NorthernWidget/Project-Okapi/docs/figures/issue-51-J10_F.png

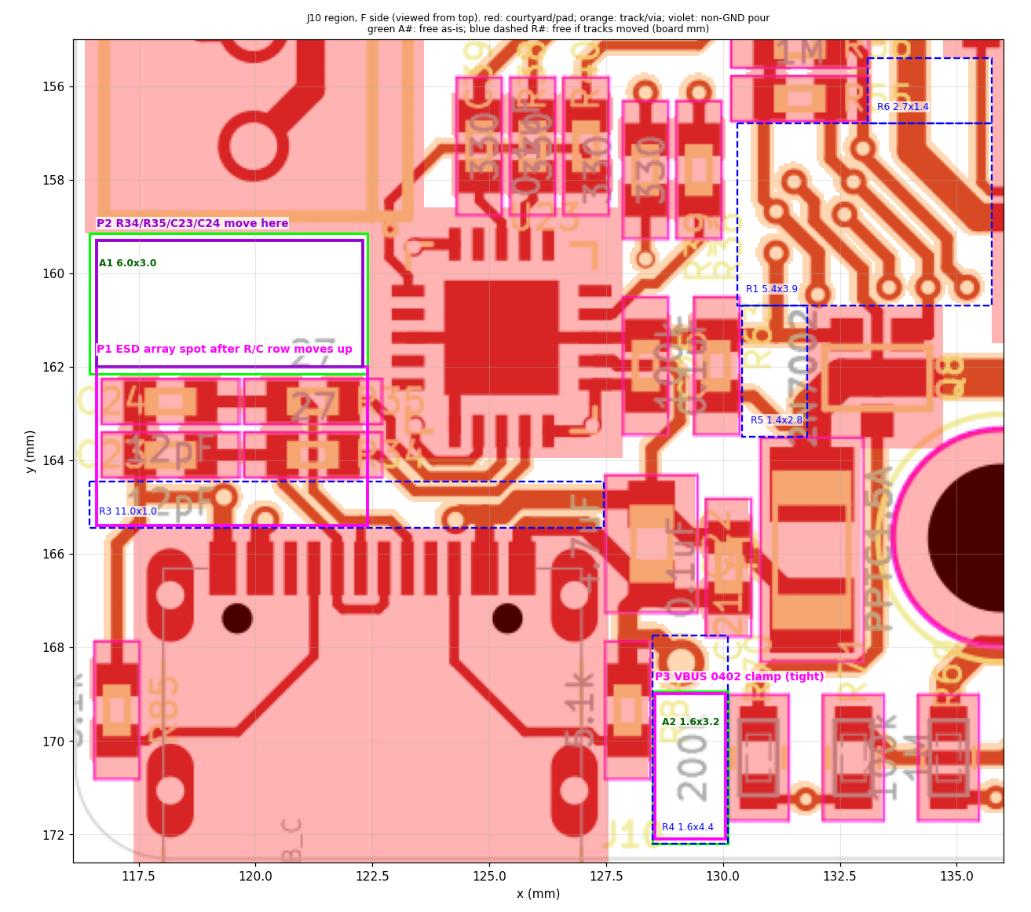
docs/figures/issue-51-J10_F.png
