NorthernWidget/Project-Okapi/docs/figures/issue-51-J5toJ8_F.png

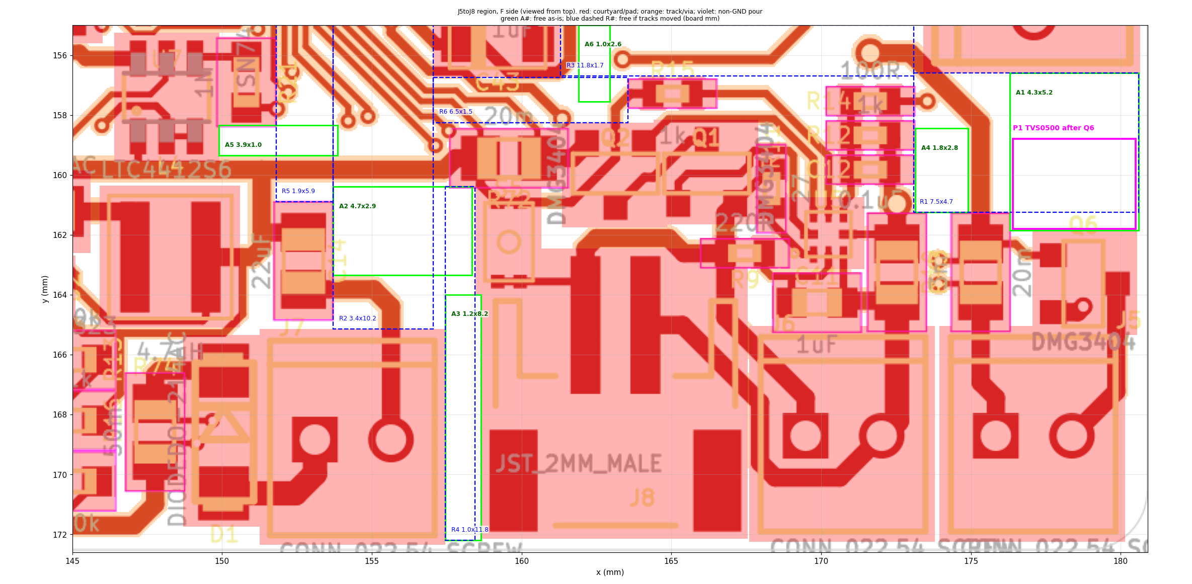
docs/figures/issue-51-J5toJ8_F.png
