NorthernWidget/Project-Okapi/Production/Okapi_BoM_0v7_2026-11-13.csv

Refs | Value | Footprint | Qty | MF | MPN | DIGIKEY | ALT_MF | ALT_MPN | ALT_DIGIKEY | DNP
BT1 | BATTERY_COIN12MM | nw-cold-silicon:LINX_BAT-HLD-012-SMT | 1 | MPD | BK-916-TR | BK-916-CT-ND
C1,C18,C22 | 4.7uF | nw-cold-silicon:C0603 | 3 | Murata | GRM188Z71C475KE21D | 490-GRM188Z71C475KE21DCT-ND
C2,C3,C4,C7,C8,C9,C10,C14,C19,C20,C30 | 22uF | nw-cold-silicon:C0805 | 11 | Murata | GRM219R61C226ME15L | 490-9952-1-ND
C5 | 220uF | nw-cold-silicon:C2917 | 1 | AVX | TPSY227K010R0100 | 478-5408-1-ND
C6,C33 | 68pF | nw-cold-silicon:C0402 | 2 | Wurth | 885012005060 | 732-7474-1-ND
C11,C13 | 1uF | nw-cold-silicon:C0603 | 2 | Taiyo Yuden | TMK107B7105KA-T | 587-2984-1-ND
C12,C17,C21,C25,C26,C27,C28,C29,C31,C32,C34,C35,C36,C37,C38,C39,C44,C45,C46,C47,C48,C50,C57 | 0.1uF | nw-cold-silicon:C0402 | 23 | Murata | GCM155R71C104KA55D | 490-4759-1-ND
C15,C16,C42 | 1uF | nw-cold-silicon:C0402 | 3 | Samsung | CL05A105KA5NQNC | 1276-1445-1-ND
C23,C24,C40,C41 | 12pF | nw-cold-silicon:C0402 | 4 | TDK | CGA2B2C0G1H120J050BA | 445-5585-1-ND
C43 | 100uF | nw-cold-silicon:C1206_TANT | 1 | Murata | GRM31CR61A107MEA8L | 490-GRM31CR61A107MEA8LCT-ND
D1,D3 | DIODEDO-214AC | nw-cold-silicon:DO214AC | 2 | Central Semiconductor | CMSH3-40MA TR13 | CMSH3-40MATR13CT-ND
D2 | DIODESOD-323 | nw-cold-silicon:SOD323-R | 1 | Central Semiconductor | CMDSH2-3 TR | CMDSH2-3CT-ND
D4,D5,D7 | CLVBA-FKA | nw-cold-silicon:CLVBA-FKA | 3 | Cree | CLVBA-FKA-CAEDH8BBB7A363 | CLVBA-FKA-CAEDH8BBB7A363CT-ND
D6 | LM4040 | nw-cold-silicon:SOT23-3 | 1 | Microchip | LM4040DYM3-2.5-TR | 576-1047-1-ND
D8 | BAT54C | nw-cold-silicon:SOT23-3 | 1 | ON Semiconductor | BAT54CLT1G | BAT54CLT1GOSCT-ND
D9 | DIODEDO-214AC | nw-cold-silicon:DO214AC | 1 | Diodes Incorporated | B340A-13-F | B340A-FDICT-ND
D10,D13,D16 | LEDGREEN0603 | nw-cold-silicon:LED_0603 | 3 | Wurth | 150060GS75000 | 732-4971-1-ND
D11,D14,D17 | LEDYELLOW0603 | nw-cold-silicon:LED_0603 | 3 | Wurth | 150060YS75000 | 732-4981-1-ND
D12,D18 | LEDRED0603 | nw-cold-silicon:LED_0603 | 2 | Wurth | 150060RS75000 | 732-4978-1-ND
F1,F2 | PPTC1.5A | nw-cold-silicon:1206 | 2 | Bourns | MF-NSMF150-2 | MF-NSMF150-2CT-ND
H1,H2,H3 | MOUNTING_HOLE4_NP | nw-cold-silicon:4_40 | 3 | N/A | DNP | DNP
IC1 | ATMEGA1284M | nw-cold-silicon:MLF44-TH | 1 | Atmel | ATMEGA1284P-MUR | ATMEGA1284P-MURCT-ND
ISP1 | AVRISP-6 | nw-cold-silicon:AVRISP | 1 | Amphenol | 67997-206HLF | 609-3234-ND
J1,J4 | CONN_82.54_SCREW | nw-cold-silicon:1X08_SCREW | 2 | On Shore | OSTVN08A150 | ED10566-ND
J2 | CONN_102.54_SCREW | nw-cold-silicon:1X10_SCREW | 1 | On Shore | OSTVN10A150 | ED10567-ND
J3 | CONN_42.54_SCREW | nw-cold-silicon:1X04_SCREW | 1 | On Shore | OSTVN04A150 | ED10563-ND
J5,J6,J7 | CONN_022.54_SCREW | nw-cold-silicon:1X02_2.54_SCREWTERM | 3 | OnShore | OSTVN02A150 | ED10561-ND
J8 | JST_2MM_MALE | nw-cold-silicon:JST-2-SMD | 1 | JST | S2B-PH-SM4-TB(LF)(SN) | 455-1749-1-ND
J9 | B_SERIES_M.2EKEY_NOPROG | nw-cold-silicon:PARTICLE_M.2EKEY_NOPROG | 1 | TE | 2199230-4 | A115904CT-ND
J10 | USB_C | nw-cold-silicon:USB_C_CUSB31-CFM2AX-01-X | 1 | GCT | USB4105-GF-A | 2073-USB4105-GF-ACT-ND
JP1,JP2,JP3,JP4,JP5,JP6,JP7 | JUMPER-SMT_2_NO_SILK | nw-cold-silicon:SMT-JUMPER_2_NO_SILK | 7
L1 | 6.8uH | nw-cold-silicon:1008 | 1 | Wurth | 74438323068 | 732-4849-1-ND
L2 | 10uH | nw-cold-silicon:WE-XHMI(6.65X6.45) | 1 | Wurth | 74439346100 | 732-10707-1-ND
L3 | 1uH | nw-cold-silicon:WE-LQS(3X3) | 1 | Wurth | 74404032010 | 732-5491-1-ND
L4 | 4.7uH | nw-cold-silicon:WE-MAIA(4.1X4.1) | 1 | Wurth | 78438356047 | 732-11316-1-ND
Q1,Q2,Q6 | DMG3404 | nw-cold-silicon:SOT23-3 | 3 | Diodes Incorporated | DMG3404L-7 | DMG3404L-7DICT-ND
Q3,Q5 | FDN360P | nw-cold-silicon:SOT23-3 | 2 | onsemi | FDN360P | FDN360PCT-ND
Q4,Q7,Q8 | 2N7002 | nw-cold-silicon:SOT323 | 3 | ON Semiconductor | 2N7002WT1G | 2N7002WT1GOSCT-ND
R1,R5,R7,R8,R65,R66 | 180k | nw-cold-silicon:R0402 | 6 | Yageo | RC0402FR-07180KL | 311-180KLRCT-ND | Panasonic | ERJ-2RKF1803X | P180KLCT-ND
R2,R4 | 1.62M | nw-cold-silicon:R0603 | 2 | Vishay | CRCW06031M62FKEA | 541-1.62MHCT-ND | Yageo | RC0603FR-071M62L | 13-RC0603FR-071M62LCT-ND
R3,R17 | 330k | nw-cold-silicon:R0603 | 2 | Panasonic | ERJ-3EKF3303V | P330KHCT-ND | Stackpole | RMCF0603FT330K | RMCF0603FT330KCT-ND
R6 | 820k | nw-cold-silicon:R0603 | 1 | Yageo | RC0603FR-07820KL | 311-820KHRCT-ND | Panasonic | ERJ-3EKF8203V | P820KHCT-ND
R9,R53,R60,R64,R76,R77,R78,R79,R80 | 220R | nw-cold-silicon:R0402 | 9 | TE | CRGCQ0402F220R | A129619CT-ND | Yageo | RC0402FR-07220RL | 311-220LRCT-ND
R10 | 3m | nw-cold-silicon:R0805 | 1 | Rohm | PMR10EZPFV3L00 | RHM.003AJCT-ND | Vishay | WFC08053L000FE66 | 541-WFC08053L000FE66CT-ND
R11,R34,R35 | 27 | nw-cold-silicon:R0402 | 3 | Yageo | RC0402FR-0727RL | YAG3086CT-ND | Panasonic | ERJ-2RKF27R0X | P27.0LCT-ND
R12,R15 | 1k | nw-cold-silicon:R0402 | 2 | Yageo | RC0402FR-071KL | 311-1.00KLRCT-ND | Panasonic | ERJ-2RKF1001X | P1.00KLCT-ND
R13 | 180k | nw-cold-silicon:R0603 | 1 | Panasonic | ERJ-3EKF1803V | P180KHCT-ND | Stackpole | RMCF0603FT180K | RMCF0603FT180KCT-ND
R14 | 100R | nw-cold-silicon:R0402 | 1 | Yageo | RC0402FR-07100RL | 311-100LRCT-ND | Stackpole | RMCF0402FT100R | RMCF0402FT100RCT-ND
R16 | 91k | nw-cold-silicon:R0603 | 1 | Panasonic | ERJ-3EKF9102V | P91.0KHCT-ND | Yageo | RC0603FR-0791KL | 311-91.0KHRCT-ND
R18,R19,R23,R57,R58,R61,R63 | 100k | nw-cold-silicon:R0402 | 7 | Yageo | RC0402FR-07100KL | 311-100KLRCT-ND | Panasonic | ERJ-2RKF1003X | P100KLCT-ND
R20 | 130k | nw-cold-silicon:R0603 | 1 | Panasonic | ERJ-3EKF1303V | P130KHCT-ND | Stackpole | RMCF0603FT130K | RMCF0603FT130KCT-ND
R21 | 1M | nw-cold-silicon:R0603 | 1 | Panasonic | ERJ-3EKF1004V | P1.00MHCT-ND | Yageo | RC0603FR-071ML | 311-1.00MHRCT-ND
R22 | 143k | nw-cold-silicon:R0402_0603 | 1 | Yageo | RC0603FR-07143KL | 311-143KHRCT-ND
R24,R25,R41,R45,R46,R47,R52,R54,R67,R86,R87 | 10k | nw-cold-silicon:R0402 | 11 | Yageo | RC0402FR-0710KL | 311-10.0KLRCT-ND | Panasonic | ERJ-2RKF1002X | P10.0KLCT-ND
R26,R27,R28,R29 | 232 | nw-cold-silicon:R0402 | 4 | Yageo | RC0402FR-07232RL | YAG3063CT-ND | Stackpole | RMCF0402FT232R | RMCF0402FT232RCT-ND
R30,R31,R32,R33 | 464 | nw-cold-silicon:R0402 | 4 | Yageo | RC0402FR-07464RL | 311-464LRCT-ND | Panasonic | ERJ-2RKF4640X | P464LCT-ND
R36,R37,R38,R39,R40,R42,R43,R44 | 330 | nw-cold-silicon:R0402 | 8 | Yageo | RC0402FR-07330RL | 311-330LRCT-ND | Panasonic | ERJ-2RKF3300X | P330LCT-ND
R48 | 1k | nw-cold-silicon:R0402_0603 | 1 | Yageo | RC0402FR-071KL | 311-1.00KLRCT-ND | Panasonic | ERJ-2RKF1001X | P1.00KLCT-ND
R49,R50 | 10k | nw-cold-silicon:R0603 | 2 | Bourns | CRT0603-BY-1002ELF | CRT0603-BY-1002ELFCT-ND | Susumu | RG1608P-103-B-T5 | RG16P10.0KBCT-ND
R51 | 0 | nw-cold-silicon:R0402 | 1 | Panasonic | ERJ-2GE0R00X | P0.0JCT-ND | Yageo | RC0402JR-070RP | YAG1279CT-ND
R55,R56,R59,R68 | 1M | nw-cold-silicon:R0402 | 4 | Yageo | RC0402FR-071ML | 311-1.00MLRCT-ND | Panasonic | ERJ-2RKF1004X | P1.00MLCT-ND
R69 | 100k | nw-cold-silicon:R0402_0603 | 1 | Yageo | RC0402FR-07100KL | 311-100KLRCT-ND | Panasonic | ERJ-2RKF1003X | P100KLCT-ND
R70 | 200k | nw-cold-silicon:R0402_0603 | 1 | Panasonic | ERJ-2RKF2003X | P200KLCT-ND | Yageo | RC0402FR-07200KL | 311-200KLRCT-ND
R71 | 1M | nw-cold-silicon:R0402_0603 | 1 | Yageo | RC0402FR-071ML | 311-1.00MLRCT-ND | Panasonic | ERJ-2RKF1004X | P1.00MLCT-ND
R72,R73,R75 | 20m | nw-cold-silicon:R0805 | 3 | Panasonic | ERJ-6BWFR020V | P.02AQCT-ND | KOA | UR73VD2ATTD20L0F | 2019-UR73VD2ATTD20L0FCT-ND
R74 | 50m | nw-cold-silicon:R0805 | 1 | Panasonic | ERJ-6BWFR050V | P17581CT-ND | KOA | UR73V2ATTD50L0F | 2019-UR73V2ATTD50L0FCT-ND
R81,R82,R83,R84,R85 | 5.1k | nw-cold-silicon:R0402 | 5 | Yageo | RC0402FR-075K1L | 311-5.10KLRCT-ND | Panasonic | ERJ-2RKF5101X | P5.10KLCT-ND
RTC1 | DS3231M | nw-cold-silicon:SO08 | 1 | Maxim | DS3231MZ+ | DS3231MZ+-ND
S1,S2 | SPDTPCM12 | nw-cold-silicon:PCM12 | 2 | C&K | PCM12SMTR | 401-2016-1-ND
S3,S4,S6,S7 | BUTTON4.2X3.2 | nw-cold-silicon:SWITCH_4.2X3.2 | 4 | C&K | PTS810 SJG 250 SMTR LFS | CKN10504CT-ND
S5 | BUTTON2.6X1.6 | nw-cold-silicon:SWITCH_2.6X1.6 | 1 | Panasonic | EVP-BB2A9B000 | P19888CT-ND
SD1 | MICROSDCD | nw-cold-silicon:MICROSD_CD | 1 | Molex | 5025700893 | WM19093CT-ND
U$1,U$2 | VDIV-JP | nw-cold-silicon:VDIV_GENERIC | 2
U1 | TLV61220DBV | nw-cold-silicon:DBV_R-PDSO-G6 | 1 | TI | TLV61220DBVR | 296-30547-1-ND
U2 | TPS6282DLC | nw-cold-silicon:DLC_8 | 1 | TI | TPS62822DLCT | 296-49512-1-ND
U3 | TPS61032RSA | nw-cold-silicon:RSA_S-PVQFN-N16 | 1 | TI | TPS61032RSAR | 296-16662-1-ND
U4 | LT3652DD | nw-cold-silicon:DFN_12_3X3 | 1 | LT | LT3652EDD#PBF | LT3652EDD#PBF-ND
U5 | BQ2980RUG | nw-cold-silicon:RUG_S-PQFP-N8 | 1 | TI | BQ298000RUGT | 296-47578-1-ND
U6 | TPS2105 | nw-cold-silicon:SOT23-5 | 1 | TI | TPS2105DBVR | 296-10883-1-ND
U7 | LTC4412S6 | nw-cold-silicon:SOT23-6L | 1 | LT | LTC4412ES6#TRPBF | LTC4412ES6#TRPBFCT-ND
U8 | TPL5111DDC | nw-cold-silicon:DDC_R-PDSO-G6 | 1 | TI | TPL5111DDCR | 296-46226-1-ND
U9 | TPS797 | nw-cold-silicon:DCK_R-PDSO-G5 | 1 | TI | TPS79733DCKR | 296-11990-1-ND
U10,U21,U22 | TPS22917DBV | nw-cold-silicon:DBV_R-PDSO-G6 | 3 | TI | TPS22917DBVT | 296-48370-1-ND
U11,U12,U13 | SN74AUP1G04YFP | nw-cold-silicon:DSBGD_4 | 3 | TI | SN74AUP1G04YFPR | 296-25196-1-ND
U14,U15,U16 | SN74AUP2G08DQE | nw-cold-silicon:DQE_R-PX2SON-N8 | 3 | TI | SN74AUP2G08DQER | 296-25638-1-ND
U17,U18,U19,U20 | MIC2544MSOP | nw-cold-silicon:MSOP_8 | 4 | Microchip | MIC2544-1YMM | 576-1738-5-ND
U23 | FT231X-Q | nw-cold-silicon:QFN20 | 1 | FTDI | FT231XQ-R | 768-1128-1-ND
U24 | SN74LVC1G3157DRL | nw-cold-silicon:DRL_R-PDSO-N6 | 1 | TI | SN74LVC1G3157DRLR | 296-18015-1-ND
U25 | SN74AUP3G34DCU | nw-cold-silicon:DCU_(R-PDSO-G8) | 1 | TI | SN74AUP3G34DCUR | 296-25595-1-ND
U26,U34 | TXS0102DQM | nw-cold-silicon:DQM_R-PX2SON-N8 | 2 | TI | TXS0102DQMR | 296-28435-1-ND
U27,U29,U42 | TXS0104RGY | nw-cold-silicon:RGY_S-PVQFN-N14 | 3 | TI | TXS0104ERGYR | 296-20698-1-ND
U28,U36 | TCA9406DCU | nw-cold-silicon:DCU_(R-PDSO-G8) | 2 | TI | TCA9406DCUR | 296-28109-1-ND
U30 | MCP4726SOT-23 | nw-cold-silicon:SOT23-6L | 1 | Microchip | MCP4726A2T-E/CH | MCP4726A2T-E/CHCT-ND
U31 | BME280 | nw-cold-silicon:BME280 | 1 | Bosch | BME280 | 828-1063-1-ND
U32 | PAC1934QFN | nw-cold-silicon:QFN16 | 1 | Microchip | PAC1934T-I/JQ | PAC1934T-I/JQCT-ND
U33 | ADS111 | nw-cold-silicon:VSSOP_10 | 1 | TI | ADS1115IDGSR | 296-38849-1-ND
U35 | MB85RC | nw-cold-silicon:SO08 | 1 | Fujitsu | MB85RC512TPNF-G-JNERE1 | 865-1269-1-ND
U37 | TLV3691DCK | nw-cold-silicon:DCK_R-PDSO-G5 | 1 | TI | TLV3691IDCKR | 296-37910-1-ND
U38 | MLX90393 | nw-cold-silicon:QFN16_3X3 | 1 | Melexis | MLX90393SLW-ABA-011-RE | MLX90393SLW-ABA-011-RECT-ND
U39 | MIC94094C6 | nw-cold-silicon:SC-70_6 | 1 | Microchip | MIC94094YC6-TR | 576-3492-1-ND
U40 | SN74AHC1G86DCK | nw-cold-silicon:DCK_R-PDSO-G5 | 1 | TI | SN74AHC1G86DCKR | 296-8750-1-ND
U41 | MCP23018QFN | nw-cold-silicon:QFN24 | 1 | Microchip | MCP23018T-E/MJ | MCP23018T-E/MJCT-ND
U43 | BMA456 | nw-cold-silicon:LGA-12_2X2 | 1 | Bosch | BMA456 | 828-1075-1-ND
U44 | VEML6030 | nw-cold-silicon:VEML6030 | 1 | Vishay | VEML6030-GS15 | VEML6030-GS15CT-ND
U45 | PCA9634QFN | nw-cold-silicon:QFN20_5X5 | 1 | NXP | PCA9634BS,118 | 568-8717-1-ND
USB2 | USB_MICROVERT | nw-cold-silicon:USB_MICRO_VERT_MOLEX | 1 | Molex | 1051330001 | WM9734CT-ND
XTAL1 | 8 MHz | nw-cold-silicon:CRYSTAL_5X3.2_2-SMD | 1 | ECS | ECS-80-12-30-JGN-TR | 50-ECS-80-12-30-JGN-CT-ND
