NorthernWidget/Project-Okapi/docs/v0.7-pre-build-checks.md

# v0.7 pre-build checks

No board has been built from the 2024 design or from its KiCad port. v0.7.0 is not to be built either: like the 2024 design, it has no charger sense resistor between the LT3652's SENSE and BAT pins ([#32](https://github.com/NorthernWidget/Project-Okapi/issues/32)), which v0.8.0 adds as R88. These checks carry forward to the first v0.8.0 boards. The only Okapi boards that exist are the 25 from 2020 (v0.4), and their schematic is a different one. So nothing below has an as-built value yet: this is what to confirm on the first v0.8.0 boards, with the value the design expects beside each.

In several places the 2024 files disagreed with what the design meant, and the v0.7.0 parts list corrects them (`NW-Status/studies/okapi-hardware-audit/DECISIONS.md` has the reasoning for each):

| Ref | Design for v0.7.0 | 2024 files | Net |
|-----|---|---|-----|
| R26–R29 | 232 Ω, 0402 | value field 287R; the part number was 232 Ω | ILIM of the port switches U17–U20, to ground |
| R30–R33 | 464 Ω, 0402 | value field 287R; the part number was 453 Ω | second ILIM resistor of each switch, in parallel through JP1–JP4 |
| R36–R40, R42–R44 | 330 Ω, 0402 | 330 Ω with an 0603 part number | LED series (D4, D5), the FT231X UART series (R38, R40) |
| R19 | 100 kΩ, 0402 | 120 kΩ | PARTICLE_EN pull-up to 3V3_CORE (Q3's gate) |
| C40, C41 | 12 pF, 0402 (TDK C0G) | a Samsung 0603 part number on 0402 pads | crystal load |
| C42 | 1 µF, 0402 | an 0603 part number on an 0402 pad | AVCC and AREF decoupling |
| R48 | 1 kΩ, 0402 on a dual 0402/0603 land | 330 Ω, 0603 | bias for the 2.5 V reference (D6) |
| R51 | 0 Ω, 0402 | no value | PAC1934 ADDRSEL to ground (address 0x10) |
| R72, R73, R75 | 20 mΩ, 0805, 0.5 W (ERJ-6BWFR020V) | no value | PAC1934 shunts: V_LI, V_PRIME, V_BETA |
| R74 | 50 mΩ, 0805, 0.5 W (ERJ-6BWFR050V) | no value | PAC1934 shunt: V_SOLAR_IN |
| R22, R69 | 143 kΩ 0603, 100 kΩ 0402, both on dual 0402/0603 lands | 0603 lands | MPPT pair on the LT3652's VIN_REG |
| Q7 | 2N7002WT1G | 2N7002W-7-F (#7) | switches 5V_AUX |

The resistor and capacitor consolidation (2026-11-06 to 2026-11-09, `NW-Status/studies/okapi-hardware-audit/resistor-minimum-set.md` and `capacitors.md`) changed these from the 2024 files as well:

| Ref | Design for v0.7.0 | 2024 files | Net |
|-----|---|---|-----|
| R3 | 330 kΩ, 0603 | 360 kΩ | TPS61032 low-battery divider |
| R5, R7 | 180 kΩ, 0402 | 0603 | feedback dividers of U1 and U2 |
| R6 | 820 kΩ 1 %, 0603 | 5 % | 3V3_AUX feedback divider |
| R9 | 220 Ω, 0402 | 330 Ω | U5's VDD filter (300 Ω maximum) |
| R11 | 27 Ω, 0402 | 20 Ω | U5's BAT resistor |
| R13 | 180 kΩ, 0603 | 182 kΩ | LT3652 VFB bias |
| R15 | 1 kΩ, 0402 | 2 kΩ | U5's PACK resistor |
| R21 | 1 MΩ, 0603 | 470 kΩ | LTC4412 STAT pull-up |
| R70, R71 | 200 kΩ, 1 MΩ, 0402 on dual 0402/0603 lands | 0603 | LT3652 SHDN divider (charger start voltage) |
| R81–R83 | 5.1 kΩ, 0402 | 5.6 kΩ | B-SoM RGB LED |
| C1 | 4.7 µF, 0603 | 0805 | – |
| C3, C4, C14 | 22 µF, 0805 | 10 µF | bulk, for effective capacitance at 4.2–5 V |
| C30 | 22 µF, 0805 | 10 µF | the MCP4726's VDD bulk |
| C15, C16 | 1 µF, 0402 | 0.22 µF | – |
| C22 | 4.7 µF X7R, 0603 | 10 µF, 0805 | USB VBUS (FTDI's value) |
| C33 | 68 pF, 0402 | 0.1 µF | DAC output |
| C43 | 100 µF ceramic, 1206 (GRM31CR61A107MEA8L) | tantalum | the tantalum land stays until #43 |
| XTAL1 | ECS-80-12-30-JGN-TR | TXC 7A-8.000MAAE-T (obsolete) | 8 MHz crystal |

Measure two or three boards from the run, so that one odd board does not stand for all of them.

## 1. Look (unpowered)

1. R9, R36–R40, R42–R44: 0402 (1.0 × 0.5 mm), not 0603 (1.6 × 0.8 mm). An 0603 on these pads overhangs them.
2. C40, C41, C42: 0402. Record the markings on the reels, since a ceramic capacitor carries none.
3. R48: record the size. It is 0402 as built, and 0603 only if someone has swapped it for more reference current (a 330 Ω 0603, `RC0603FR-07330RL`, fits the same pads).
4. R22 (0603) and R69 (0402), marked on the silk as the MPPT pair; R70 and R71 0402. All four sit on dual lands that take either size.
5. Q7, Q4, Q8: record the top marking. The BoM change is for Q7; Q4 and Q8 carried the same part number.
6. R72–R75, and on v0.8.0 the charger sense resistor R88: 0805. Record any marking.
7. R5, R7, R9, R11, R15, R81–R83: 0402. C1, C22: 0603. C15, C16: 0402. C3, C4, C14, C30: 0805 22 µF (record the reel). C43: a ceramic 1206 on the tantalum land, centered.

## 2. Resistance (unpowered, batteries, USB and solar input out)

Many of these sit between unpowered ICs, whose protection diodes can conduct at an ohmmeter's test voltage. Take each reading in both probe polarities and record the higher one. Measure the four shunts with a four-wire (Kelvin) milliohm meter on the pads; a two-wire meter cannot read 20 mΩ.

| Ref | Probe across | Expect |
|-----|---|---|
| R26–R29 | its two pads, JP1–JP4 open | 232 Ω |
| R30–R33 | its two pads, JP open | 464 Ω |
| R26–R29 | its two pads, the matching JP closed | 154.7 Ω (232 Ω ∥ 464 Ω) |
| R36–R40, R42–R44 | its two pads | 330 Ω |
| R9 | its two pads | 220 Ω |
| R11 | its two pads | 27 Ω |
| R15 | its two pads | 1 kΩ |
| R3 | its two pads | 330 kΩ |
| R13 | its two pads | 180 kΩ |
| R21 | its two pads | 1 MΩ |
| R70 | its two pads | 200 kΩ |
| R71 | its two pads | 1 MΩ |
| R81–R83 | its two pads | 5.1 kΩ |
| R19 | its two pads | 100 kΩ |
| R48 | its two pads | 1 kΩ |
| R51 | its two pads | under 1 Ω |
| R72, R73, R75 | pads, four-wire | 20 mΩ |
| R74, and R88 on v0.8.0 | pads, four-wire | 50 mΩ |
| R22 | its two pads | 143 kΩ |
| R69 | its two pads | 100 kΩ |

Close each of JP1–JP4 in turn with a solder bridge, read it, and wick it open again.

## 3. Powered

1. **Port current limits (optional, with a current-limited load).** Enable one port switch and load its output with an electronic load in constant-current mode. Raise the current until the output collapses and record that trip current. The datasheet gives 0.79–1.19 A with the jumper open and 1.04–1.93 A with it closed (R_SET = 230 V / I, with the current-limit factor spread 184–276 V up to 1 A and 161–299 V above it). If the upstream rail sags first, record where.
2. **R19.** With PARTICLE_EN not driven, measure the voltage across R19. The current is that voltage divided by the reading from step 2. When firmware drives PARTICLE_EN low, the pull-up carries about 33 µA at 3.3 V.
3. **R48 and the reference.** With 5V_AUX on, measure VREF (J2 pin 2) and the voltage across R48. Expect 2.5 V on VREF and about 2.5 mA through R48 (the LM4040 holds 2.5 V from 60 µA to 15 mA). Then load VREF with 1.25 kΩ (about 2 mA) and record VREF again.
4. **R51 and the PAC1934.** Scan the I2C bus on the segment the PAC1934 sits on. Expect an answer at 0x10 and the product ID 0x5B from `pacFind()`; the other chips are at 0x48, 0x52, 0x20, 0x50, 0x77, 0x0C, 0x68 and 0x18 (the BMA456's other strap would put it at 0x19).
5. **Shunts and zero offset.** With the load off, read each channel's current. The PAC1934's offset is ±0.02 mV at 25 °C, which is ±1 mA on 20 mΩ and ±0.4 mA on 50 mΩ. Then pass a known current through each channel (about 1 A, from a bench supply read on a second meter) and compare: expect 20 mV across a 20 mΩ shunt and 50 mV across a 50 mΩ one. On V_LI the current is bipolar: charging reads positive.
6. **MPPT pair.** Feed the solar input from a current-limited bench supply and lower its voltage below the point the supply can sustain. The charger holds the input at VIN_REG, 2.7 V × (1 + 143 kΩ / 100 kΩ) = 6.56 V by the design. Record where it settles.
7. **Q7.** Command 5V_AUX off and measure the current from the backup battery. A latched Q7 draws about 100 mA; expect the sleep current instead.

The PAC1934 path in the firmware (`Okapi.cpp`) has not run on hardware.

## Results

| Board (serial) | R26/R30 open (Ω) | R26 closed (Ω) | R19 (Ω) | R48 (Ω) | VREF (V) | PAC1934 address | R72 (mΩ) | R73 (mΩ) | R74 (mΩ) | R75 (mΩ) | Notes |
|---|---|---|---|---|---|---|---|---|---|---|---|
| | | | | | | | | | | | |
| | | | | | | | | | | | |
