NorthernWidget/Project-Okapi/docs/figures/issue-36-r48-move.png

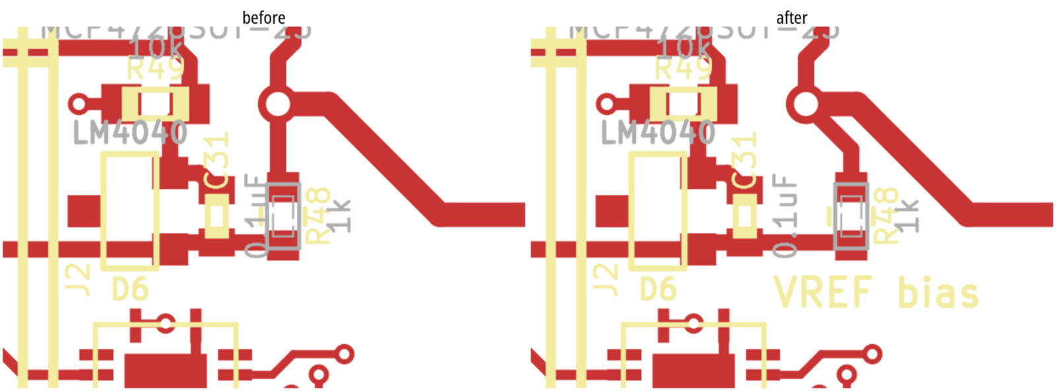
docs/figures/issue-36-r48-move.png
