NorthernWidget/Project-Okapi/docs/figures/issue-37-slow-routing.png

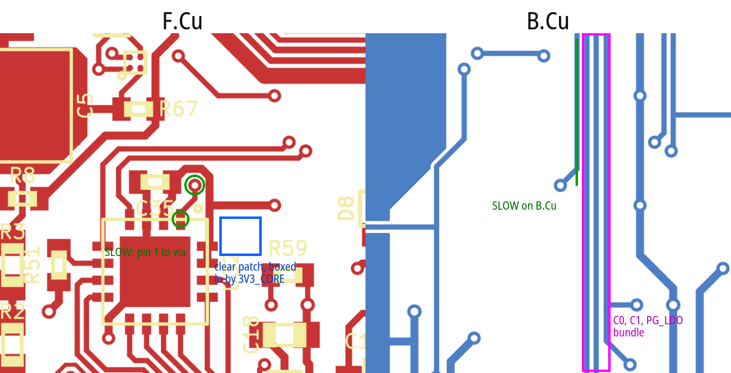
docs/figures/issue-37-slow-routing.png
