NorthernWidget/Project-Okapi/docs/figures/issue-51-J1J2_F.png

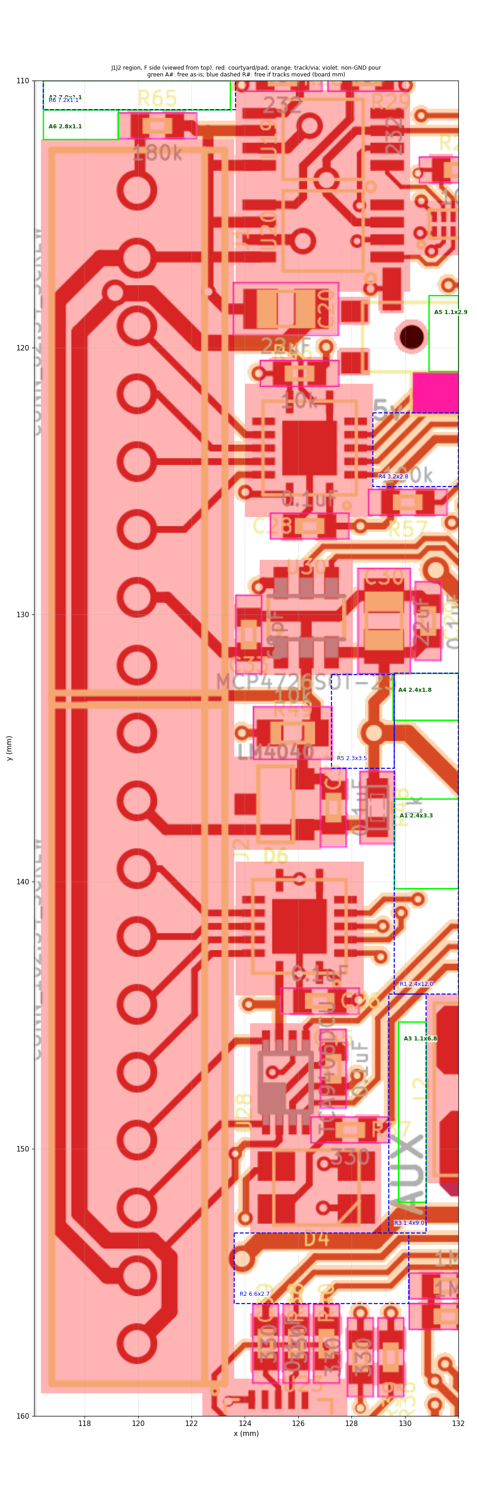
docs/figures/issue-51-J1J2_F.png
