NorthernWidget/Project-Okapi/docs/figures/issue-51-J3J4_F.png

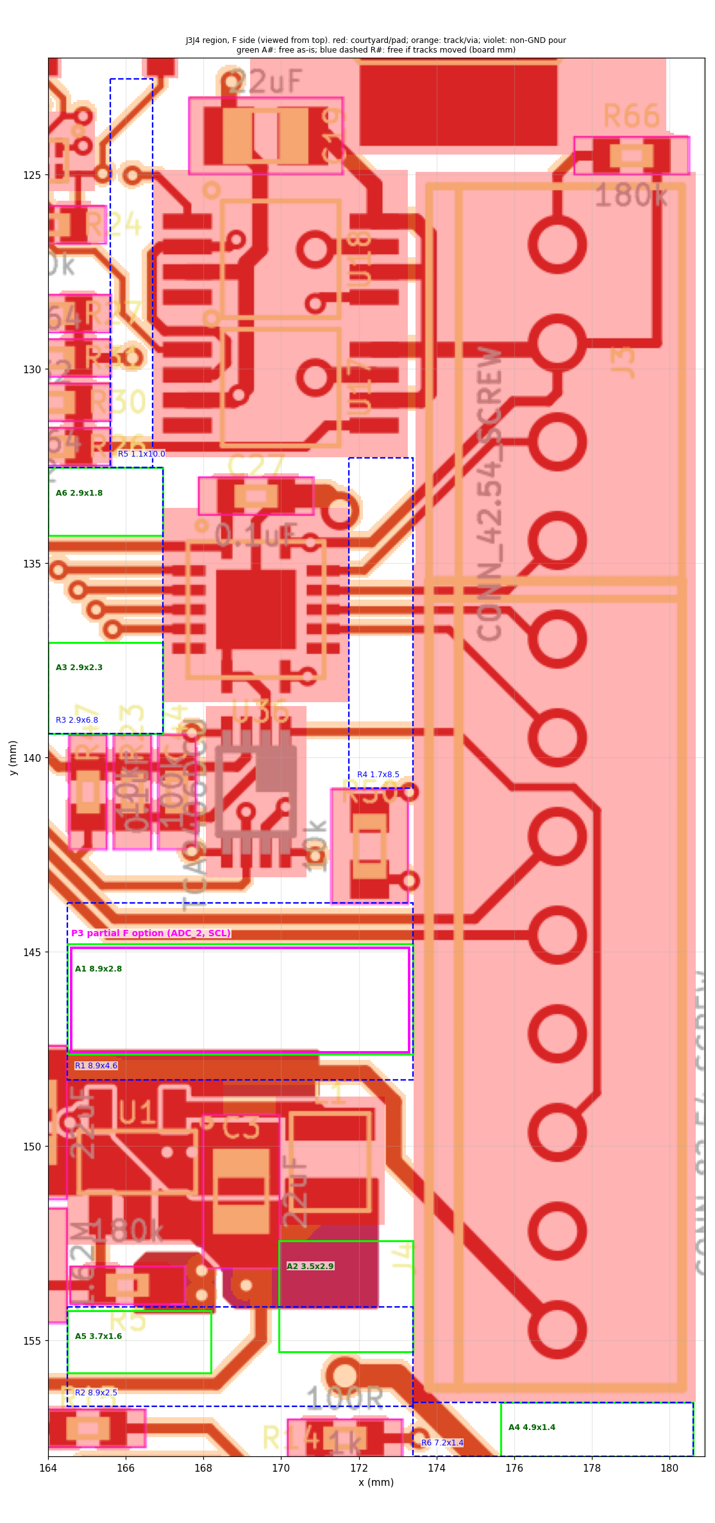
docs/figures/issue-51-J3J4_F.png
