NorthernWidget/Project-Okapi/docs/figures/issue-51-USB2_F.png

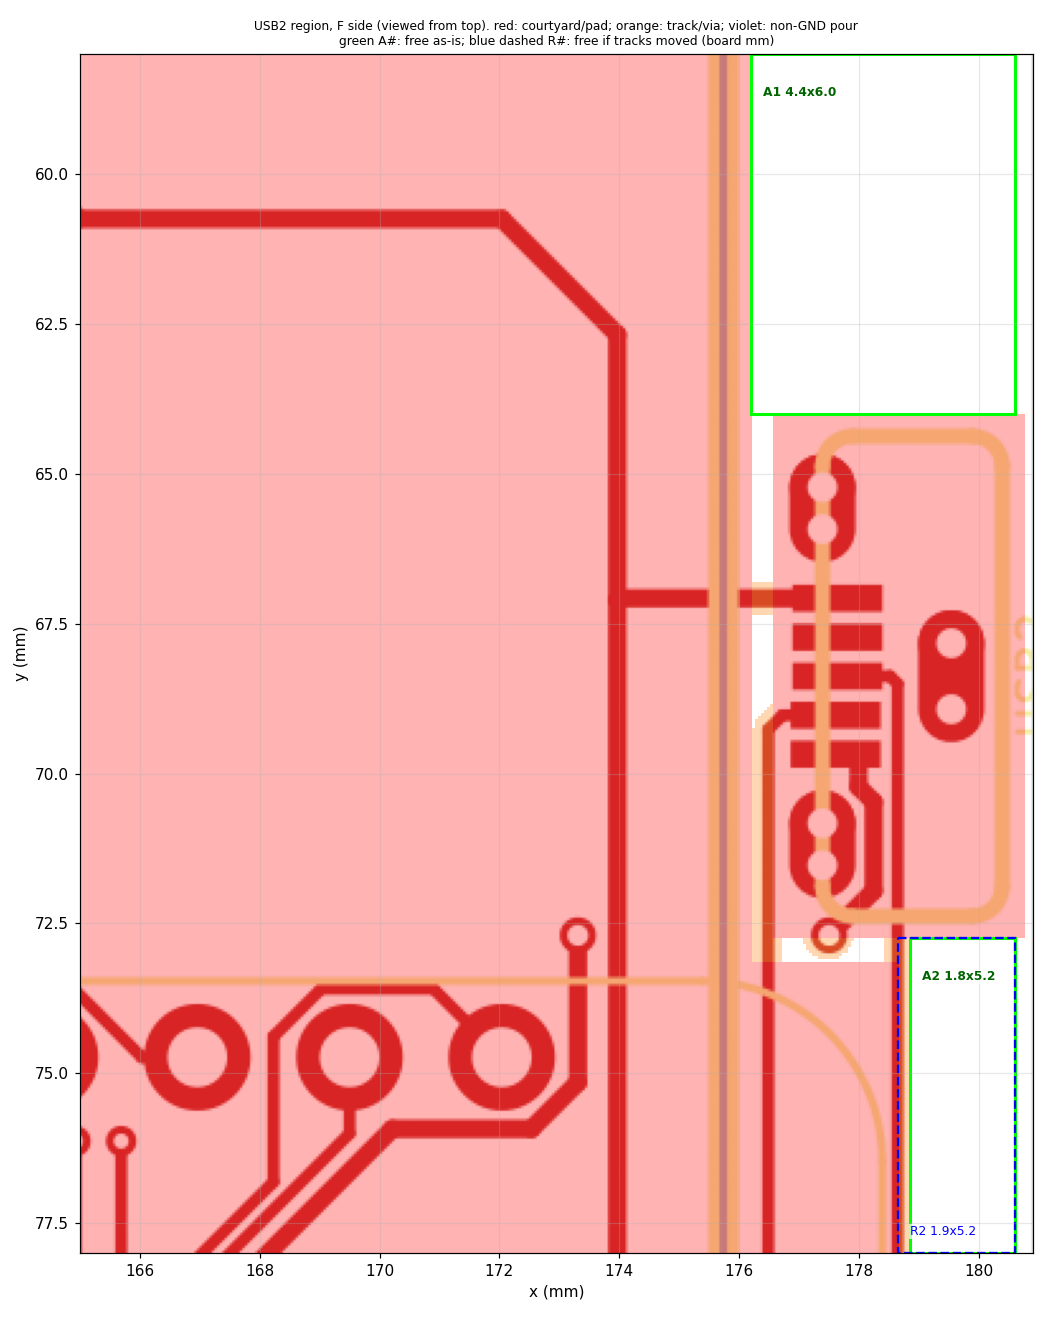
docs/figures/issue-51-USB2_F.png
