NorthernWidget/Project-Okapi/Hardware/KiCAD-10import/Okapi.kicad_pcb

## KiCad design Hardware/KiCAD-10import/Okapi.kicad_pcb (2026-11-13)

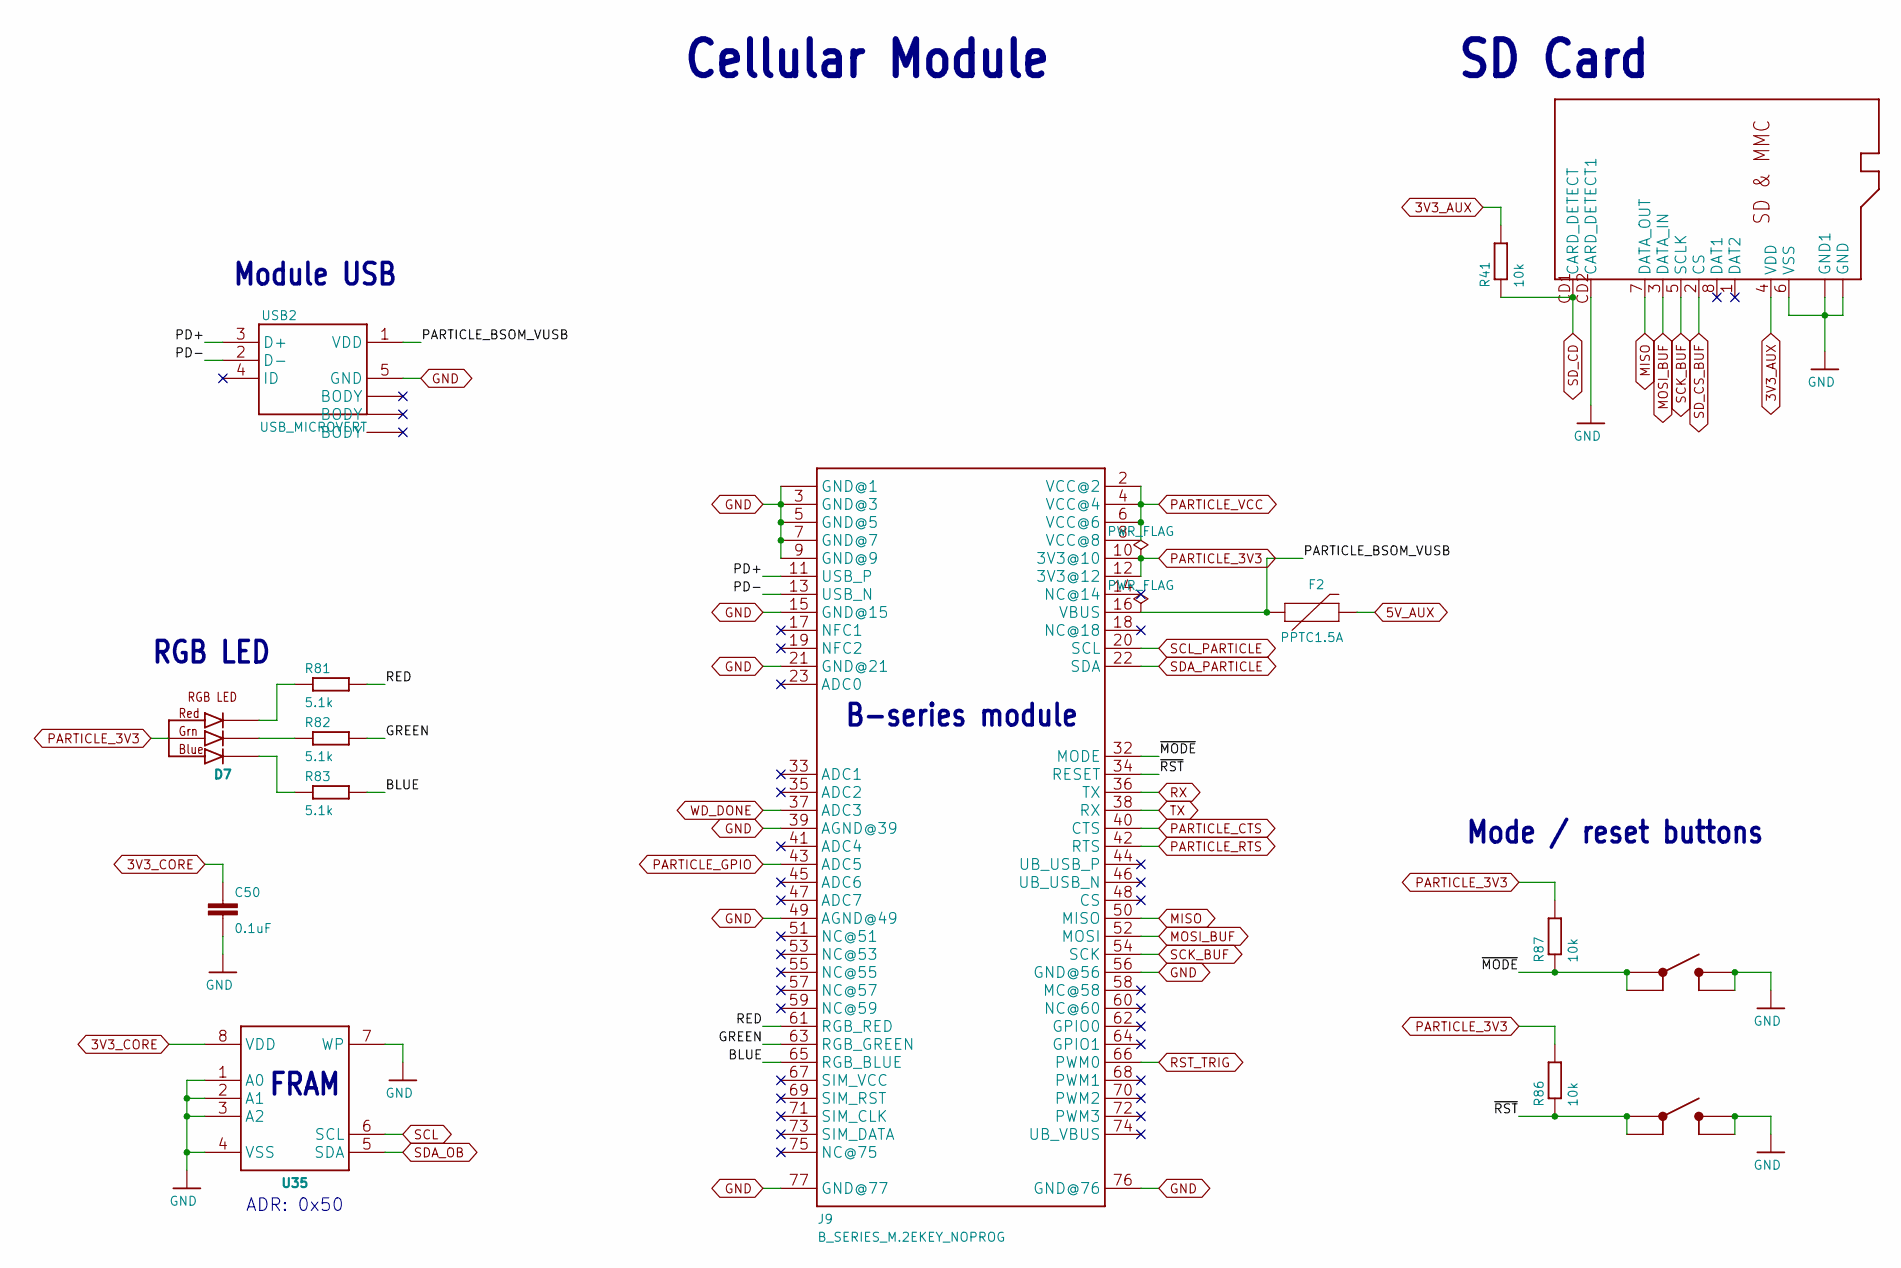
[picture p8: schematic Cell_Module.kicad_sch]

Parts:
C50: 0.1uF; C0402; MPN GCM155R71C104KA55D; DIGIKEY 490-4759-1-ND
D7: CLVBA-FKA; MPN CLVBA-FKA-CAEDH8BBB7A363; DIGIKEY CLVBA-FKA-CAEDH8BBB7A363CT-ND
F2: PPTC1.5A; 1206; MPN MF-NSMF150-2; DIGIKEY MF-NSMF150-2CT-ND
J9: B_SERIES_M.2EKEY_NOPROG; PARTICLE_M.2EKEY_NOPROG; MPN 2199230-4; DIGIKEY A115904CT-ND
R41, R86, R87: 10k; R0402; MPN RC0402FR-0710KL; DIGIKEY 311-10.0KLRCT-ND
R81, R82, R83: 5.1k; R0402; MPN RC0402FR-075K1L; DIGIKEY 311-5.10KLRCT-ND
S6, S7: BUTTON4.2X3.2; SWITCH_4.2X3.2; MPN PTS810 SJG 250 SMTR LFS; DIGIKEY CKN10504CT-ND
SD1: MICROSDCD; MICROSD_CD; MPN 5025700893; DIGIKEY WM19093CT-ND
U35: MB85RC; SO08; MPN MB85RC512TPNF-G-JNERE1; DIGIKEY 865-1269-1-ND
USB2: USB_MICROVERT; USB_MICRO_VERT_MOLEX; MPN 1051330001; DIGIKEY WM9734CT-ND

Connections:
3V3_AUX: R41.2, SD1.4 (VDD); also elsewhere on the board
3V3_CORE: C50.1, U35.8 (VDD); also elsewhere on the board
5V_AUX: F2.2; also elsewhere on the board
/Cell_Module/BLUE: J9.65 (RGB_BLUE), R83.2
/Cell_Module/GREEN: J9.63 (RGB_GREEN), R82.2
/Cell_Module/PARTICLE_BSOM_VUSB: F2.1, J9.16 (VBUS), USB2.1 (VDD)
/Cell_Module/PD+: J9.11 (USB_P), USB2.3 (D+)
/Cell_Module/PD-: J9.13 (USB_N), USB2.2 (D-)
/Cell_Module/RED: J9.61 (RGB_RED), R81.2
/Cell_Module/~MODE: J9.32 (MODE), R87.1, S6.1, S6.2
/Cell_Module/~RST: J9.34 (RESET), R86.1, S7.1, S7.2
GND: C50.2, J9.1 (GND@1), J9.3 (GND@3), J9.5 (GND@5), J9.7 (GND@7), J9.9 (GND@9), J9.15 (GND@15), J9.21 (GND@21), J9.39 (AGND@39), J9.49 (AGND@49), J9.56 (GND@56), J9.76 (GND@76), J9.77 (GND@77), J9.GND (GND@1), S6.3 (4), S6.4 (3), S7.3 (4), S7.4 (3), SD1.6 (VSS), SD1.CD2 (CARD_DETECT1), SD1.MT1 (GND), SD1.MT2 (GND1), SD1.MT3 (GND1), SD1.MT4 (GND1), U35.1 (A0), U35.2 (A1), U35.3 (A2), U35.4 (VSS), U35.7 (WP), USB2.5 (GND); also elsewhere on the board
MISO: J9.50 (MISO), SD1.7 (DATA_OUT); also elsewhere on the board
MOSI_BUF: J9.52 (MOSI), SD1.3 (DATA_IN); also elsewhere on the board
unnamed: D7.3 (BLUE_CATH), R83.1
unnamed: D7.4 (GREEN_CATH), R82.1
unnamed: D7.1 (RED_CATH), R81.1
PARTICLE_3V3: D7.2 (ANODE), J9.10 (3V3@10), J9.12 (3V3@12), R86.2, R87.2; also elsewhere on the board
PARTICLE_CTS: J9.40 (CTS); also elsewhere on the board
PARTICLE_GPIO: J9.43 (ADC5); also elsewhere on the board
PARTICLE_RTS: J9.42 (RTS); also elsewhere on the board
PARTICLE_VCC: J9.2 (VCC@2), J9.4 (VCC@4), J9.6 (VCC@6), J9.8 (VCC@8); also elsewhere on the board
RST_TRIG: J9.66 (PWM0); also elsewhere on the board
RX: J9.36 (TX); also elsewhere on the board
SCK_BUF: J9.54 (SCK), SD1.5 (SCLK); also elsewhere on the board
SCL: U35.6 (SCL); also elsewhere on the board
SCL_PARTICLE: J9.20 (SCL); also elsewhere on the board
SDA_OB: U35.5 (SDA); also elsewhere on the board
SDA_PARTICLE: J9.22 (SDA); also elsewhere on the board
SD_CD: R41.1, SD1.CD1 (CARD_DETECT); also elsewhere on the board
SD_CS_BUF: SD1.2 (CS); also elsewhere on the board
TX: J9.38 (RX); also elsewhere on the board
WD_DONE: J9.37 (ADC3); also elsewhere on the board

Notes on the sheet:
Cellular Module
B-series module
RGB LED
Mode / reset buttons
ADR: 0x50
Module USB
FRAM
SD Card

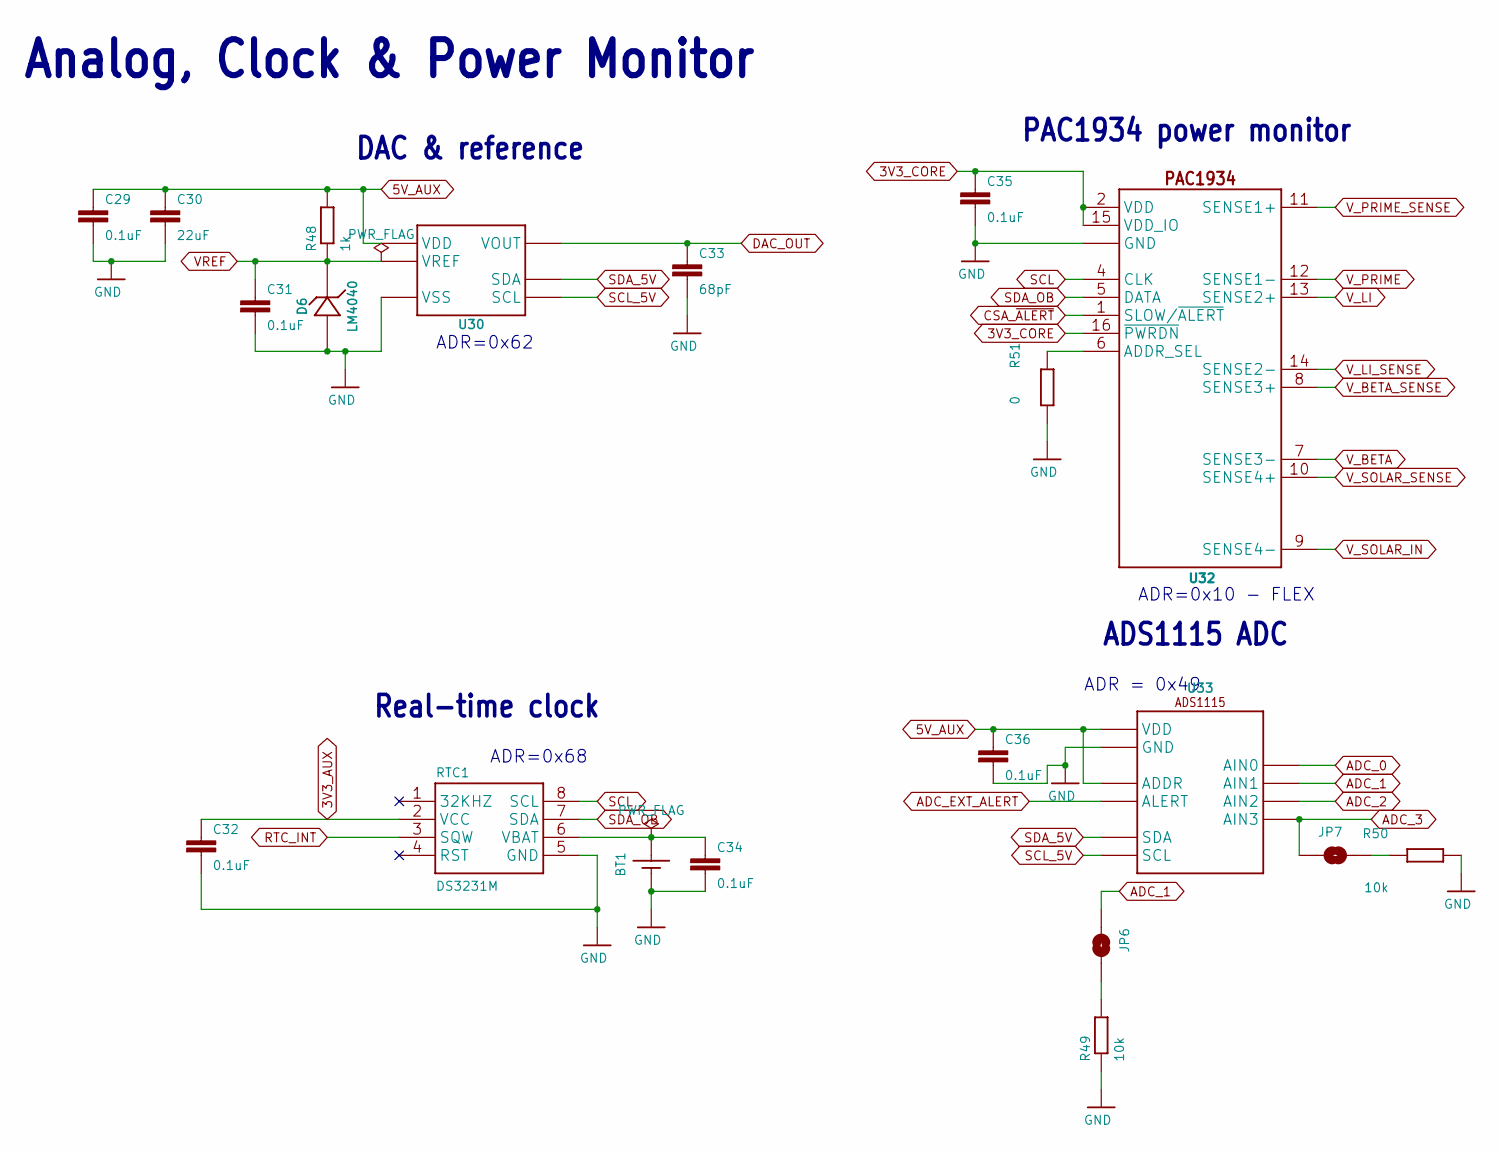
[picture p9: schematic Analog_Clock_Power.kicad_sch]

Parts:
BT1: BATTERY_COIN12MM; LINX_BAT-HLD-012-SMT; MPN BK-916-TR; DIGIKEY BK-916-CT-ND
C29, C31, C32, C34, C35, C36: 0.1uF; C0402; MPN GCM155R71C104KA55D; DIGIKEY 490-4759-1-ND
C30: 22uF; C0805; MPN GRM219R61C226ME15L; DIGIKEY 490-9952-1-ND
C33: 68pF; C0402; MPN 885012005060; DIGIKEY 732-7474-1-ND
D6: LM4040; SOT23-3; MPN LM4040DYM3-2.5-TR; DIGIKEY 576-1047-1-ND
JP6, JP7: JUMPER-SMT_2_NO_SILK; SMT-JUMPER_2_NO_SILK
R48: 1k; R0402_0603; MPN RC0402FR-071KL; DIGIKEY 311-1.00KLRCT-ND
R49, R50: 10k; R0603; MPN CRT0603-BY-1002ELF; DIGIKEY CRT0603-BY-1002ELFCT-ND
R51: 0; R0402; MPN ERJ-2GE0R00X; DIGIKEY P0.0JCT-ND
RTC1: DS3231M; SO08; MPN DS3231MZ+; DIGIKEY DS3231MZ+-ND
U30: MCP4726SOT-23; SOT23-6L; MPN MCP4726A2T-E/CH; DIGIKEY MCP4726A2T-E/CHCT-ND
U32: PAC1934QFN; QFN16; MPN PAC1934T-I/JQ; DIGIKEY PAC1934T-I/JQCT-ND
U33: ADS111; VSSOP_10; MPN ADS1115IDGSR; DIGIKEY 296-38849-1-ND

Connections:
3V3_AUX: C32.1, RTC1.2 (VCC); also elsewhere on the board
3V3_CORE: C35.1, U32.2 (VDD), U32.15 (VDD_IO), U32.16 (~PWRDN); also elsewhere on the board
5V_AUX: C29.1, C30.1, C36.1, R48.2, U30.3 (VDD), U33.1 (ADDR), U33.8 (VDD); also elsewhere on the board
ADC_0: U33.4 (AIN0); also elsewhere on the board
ADC_1: JP6.1, U33.5 (AIN1); also elsewhere on the board
ADC_2: U33.6 (AIN2); also elsewhere on the board
ADC_3: JP7.1, U33.7 (AIN3); also elsewhere on the board
ADC_EXT_ALERT: U33.2 (ALERT); also elsewhere on the board
CSA_~ALERT: U32.1 (SLOW/~ALERT); also elsewhere on the board
DAC_OUT: C33.1, U30.1 (VOUT); also elsewhere on the board
GND: BT1.GND (-), C29.2, C30.2, C31.2, C32.2, C33.2, C34.2, C35.2, C36.2, D6.2 (A), R49.1, R50.1, R51.1, RTC1.5 (GND), U30.2 (VSS), U32.3 (GND), U32.EP (GND), U33.3 (GND); also elsewhere on the board
unnamed: BT1.POWER0 (+), C34.1, RTC1.6 (VBAT)
unnamed: JP6.2, R49.2
unnamed: JP7.2, R50.2
unnamed: R51.2, U32.6 (ADDR_SEL)
RTC_INT: RTC1.3 (SQW); also elsewhere on the board
SCL: RTC1.8 (SCL), U32.4 (CLK); also elsewhere on the board
SCL_5V: U30.5 (SCL), U33.10 (SCL); also elsewhere on the board
SDA_5V: U30.4 (SDA), U33.9 (SDA); also elsewhere on the board
SDA_OB: RTC1.7 (SDA), U32.5 (DATA); also elsewhere on the board
VREF: C31.1, D6.1 (C), R48.1, U30.6 (VREF); also elsewhere on the board
V_BETA: U32.7 (SENSE3-); also elsewhere on the board
V_BETA_SENSE: U32.8 (SENSE3+); also elsewhere on the board
V_LI: U32.13 (SENSE2+); also elsewhere on the board
V_LI_SENSE: U32.14 (SENSE2-); also elsewhere on the board
V_PRIME: U32.12 (SENSE1-); also elsewhere on the board
V_PRIME_SENSE: U32.11 (SENSE1+); also elsewhere on the board
V_SOLAR_IN: U32.9 (SENSE4-); also elsewhere on the board
V_SOLAR_SENSE: U32.10 (SENSE4+); also elsewhere on the board

Notes on the sheet:
ADR=0x68
ADR = 0x49
Analog, Clock & Power Monitor
Real-time clock
ADR=0x10 - FLEX
DAC & reference
ADS1115 ADC
ADR=0x62
PAC1934 power monitor

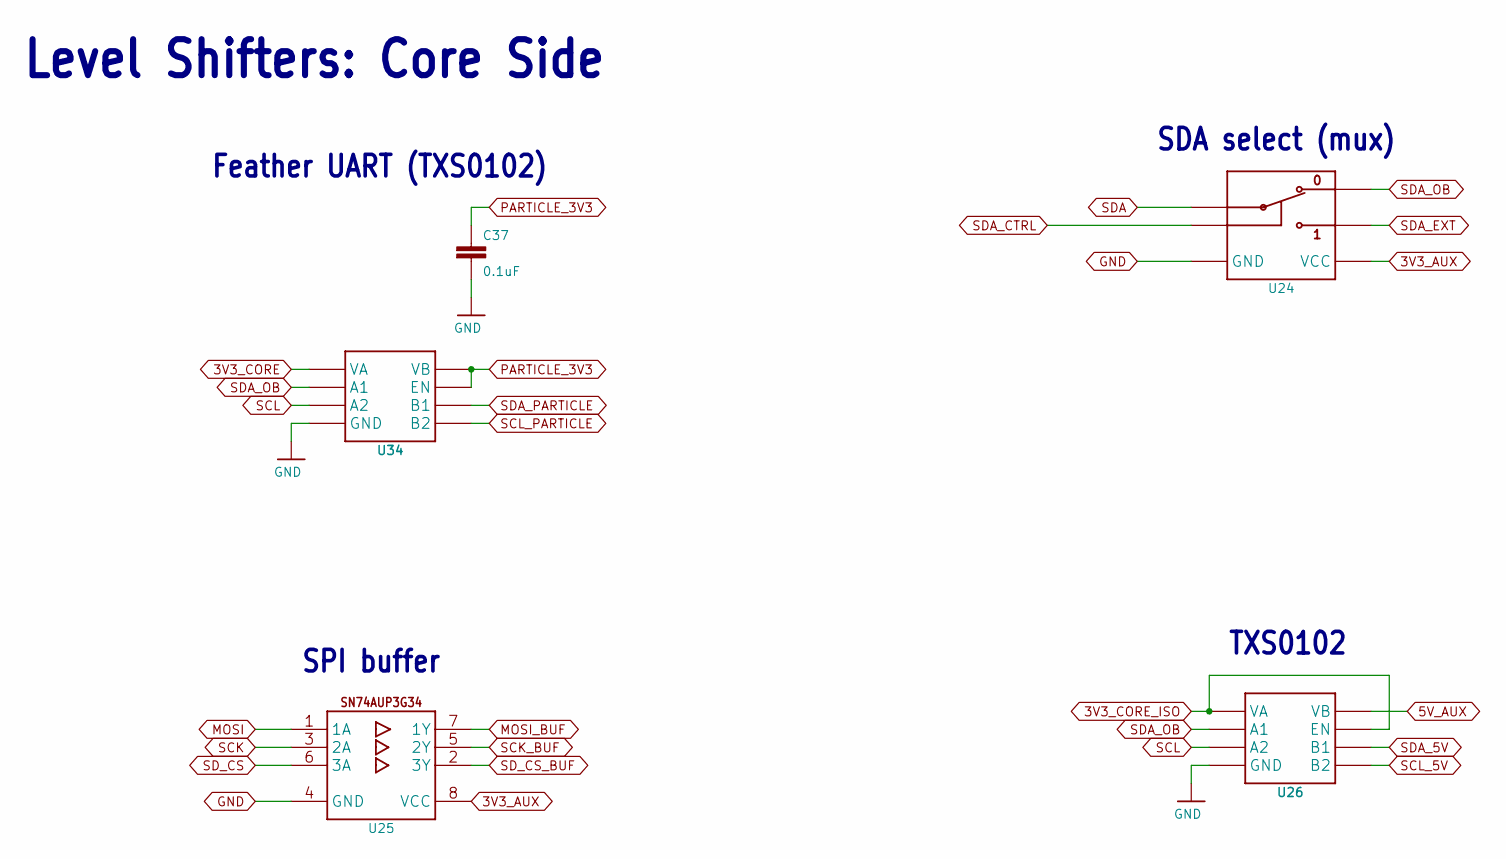
[picture p10: schematic Level_Shifters.kicad_sch]

Parts:
C37: 0.1uF; C0402; MPN GCM155R71C104KA55D; DIGIKEY 490-4759-1-ND
U24: SN74LVC1G3157DRL; DRL_R-PDSO-N6; MPN SN74LVC1G3157DRLR; DIGIKEY 296-18015-1-ND
U25: SN74AUP3G34DCU; DCU_(R-PDSO-G8); MPN SN74AUP3G34DCUR; DIGIKEY 296-25595-1-ND
U26, U34: TXS0102DQM; DQM_R-PX2SON-N8; MPN TXS0102DQMR; DIGIKEY 296-28435-1-ND

Connections:
3V3_AUX: U24.5 (VCC), U25.8 (VCC); also elsewhere on the board
3V3_CORE: U34.1 (VA); also elsewhere on the board
3V3_CORE_ISO: U26.1 (VA), U26.5 (EN); also elsewhere on the board
5V_AUX: U26.8 (VB); also elsewhere on the board
GND: C37.2, U24.2 (GND), U25.4 (GND), U26.4 (GND), U34.4 (GND); also elsewhere on the board
MOSI: U25.1 (1A); also elsewhere on the board
MOSI_BUF: U25.7 (1Y); also elsewhere on the board
PARTICLE_3V3: C37.1, U34.5 (EN), U34.8 (VB); also elsewhere on the board
SCK: U25.3 (2A); also elsewhere on the board
SCK_BUF: U25.5 (2Y); also elsewhere on the board
SCL: U26.3 (A2), U34.3 (A2); also elsewhere on the board
SCL_5V: U26.6 (B2); also elsewhere on the board
SCL_PARTICLE: U34.6 (B2); also elsewhere on the board
SDA: U24.4 (A); also elsewhere on the board
SDA_5V: U26.7 (B1); also elsewhere on the board
SDA_CTRL: U24.6 (S); also elsewhere on the board
SDA_EXT: U24.1 (B2); also elsewhere on the board
SDA_OB: U24.3 (B1), U26.2 (A1), U34.2 (A1); also elsewhere on the board
SDA_PARTICLE: U34.7 (B1); also elsewhere on the board
SD_CS: U25.6 (3A); also elsewhere on the board
SD_CS_BUF: U25.2 (3Y); also elsewhere on the board

Notes on the sheet:
TXS0102
Feather UART (TXS0102)
Level Shifters: Core Side
SDA select (mux)
SPI buffer

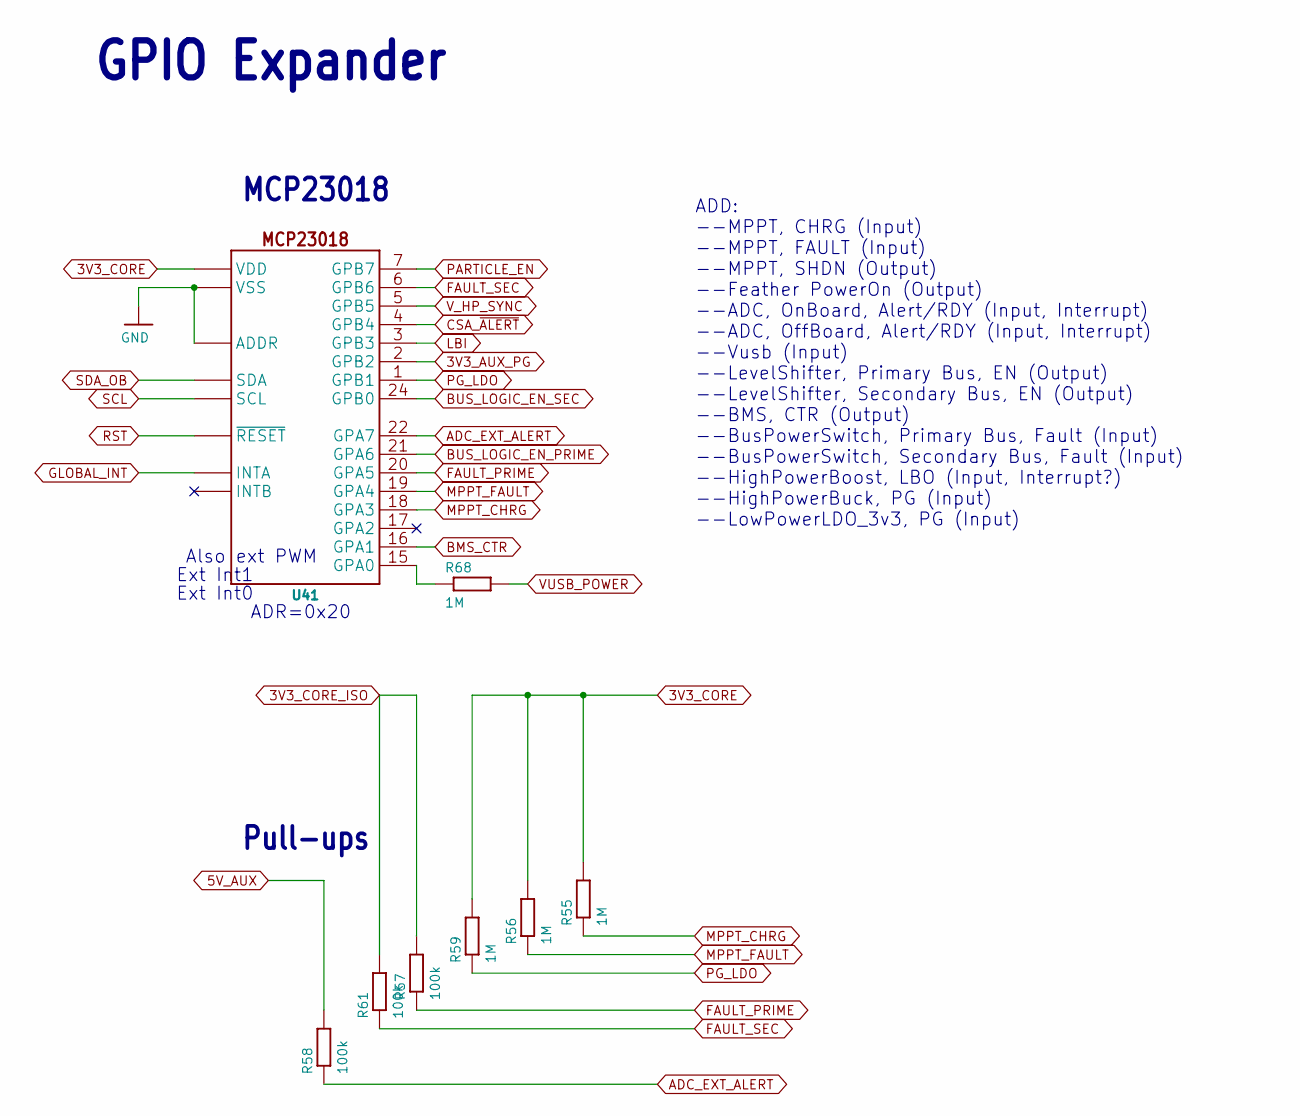
[picture p11: schematic GPIO_Expander.kicad_sch]

Parts:
R55, R56, R59, R68: 1M; R0402; MPN RC0402FR-071ML; DIGIKEY 311-1.00MLRCT-ND
R57, R58, R61: 100k; R0402; MPN RC0402FR-07100KL; DIGIKEY 311-100KLRCT-ND
U41: MCP23018QFN; QFN24; MPN MCP23018T-E/MJ; DIGIKEY MCP23018T-E/MJCT-ND

Connections:
3V3_AUX_PG: U41.2 (GPB2); also elsewhere on the board
3V3_CORE: R55.2, R56.2, R59.2, U41.8 (VDD); also elsewhere on the board
3V3_CORE_ISO: R57.2, R61.2; also elsewhere on the board
5V_AUX: R58.2; also elsewhere on the board
ADC_EXT_ALERT: R58.1, U41.22 (GPA7); also elsewhere on the board
BMS_CTR: U41.16 (GPA1); also elsewhere on the board
BUS_LOGIC_EN_PRIME: U41.21 (GPA6); also elsewhere on the board
BUS_LOGIC_EN_SEC: U41.24 (GPB0); also elsewhere on the board
CSA_~ALERT: U41.4 (GPB4); also elsewhere on the board
FAULT_PRIME: R57.1, U41.20 (GPA5); also elsewhere on the board
FAULT_SEC: R61.1, U41.6 (GPB6); also elsewhere on the board
GLOBAL_INT: U41.14 (INTA); also elsewhere on the board
GND: U41.11 (ADDR), U41.23 (VSS), U41.EP (VSS); also elsewhere on the board
LBI: U41.3 (GPB3); also elsewhere on the board
MPPT_CHRG: R55.1, U41.18 (GPA3); also elsewhere on the board
MPPT_FAULT: R56.1, U41.19 (GPA4); also elsewhere on the board
unnamed: R68.1, U41.15 (GPA0)
PARTICLE_EN: U41.7 (GPB7); also elsewhere on the board
PG_LDO: R59.1, U41.1 (GPB1); also elsewhere on the board
RST: U41.12 (~RESET); also elsewhere on the board
SCL: U41.9 (SCL); also elsewhere on the board
SDA_OB: U41.10 (SDA); also elsewhere on the board
VUSB_POWER: R68.2; also elsewhere on the board
V_HP_SYNC: U41.5 (GPB5); also elsewhere on the board

Notes on the sheet:
Ext Int0
Ext Int1
Also ext PWM
Pull-ups
MCP23018
GPIO Expander
ADR=0x20
ADD: --MPPT, CHRG (Input) --MPPT, FAULT (Input) --MPPT, SHDN (Output) --Feather PowerOn (Output) --ADC, OnBoard, Alert/RDY (Input, Interrupt) --ADC, OffBoard, Alert/RDY (Input, Interrupt) --Vusb (Input) --LevelShifter, Primary Bus, EN (Output) --LevelShifter, Secondary Bus, EN (Output) --BMS, CTR (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

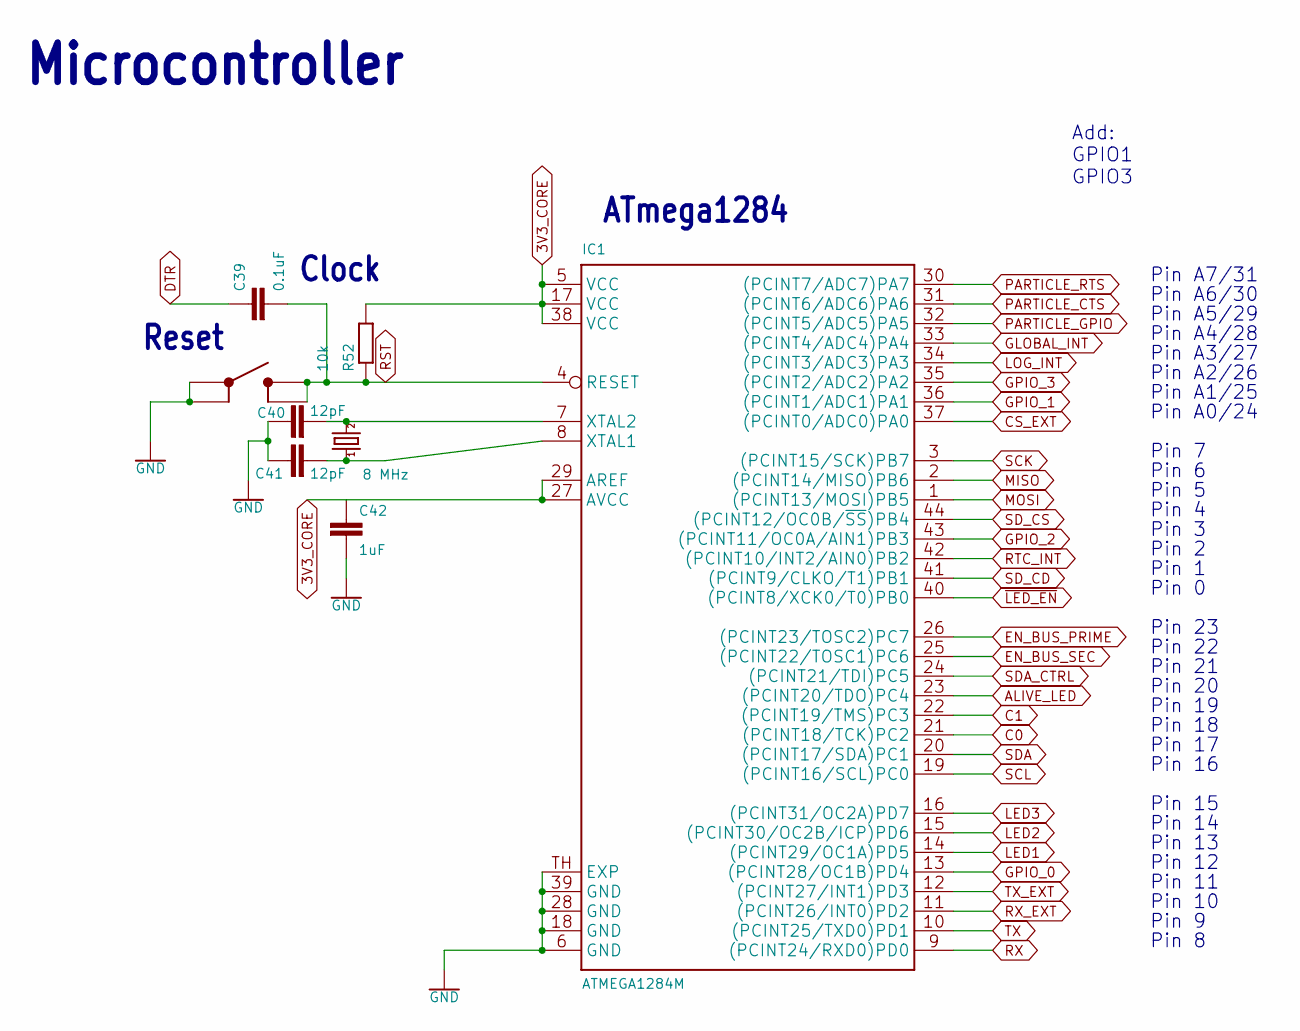
[picture p12: schematic Microcontroller.kicad_sch]

Parts:
C39: 0.1uF; C0402; MPN GCM155R71C104KA55D; DIGIKEY 490-4759-1-ND
C40, C41: 12pF; C0402; MPN CGA2B2C0G1H120J050BA; DIGIKEY 445-5585-1-ND
C42: 1uF; C0402; MPN CL05A105KA5NQNC; DIGIKEY 1276-1445-1-ND
IC1: ATMEGA1284M; MLF44-TH; MPN ATMEGA1284P-MUR; DIGIKEY ATMEGA1284P-MURCT-ND
R52: 10k; R0402; MPN RC0402FR-0710KL; DIGIKEY 311-10.0KLRCT-ND
S4: BUTTON4.2X3.2; SWITCH_4.2X3.2; MPN PTS810 SJG 250 SMTR LFS; DIGIKEY CKN10504CT-ND
XTAL1: 8 MHz; CRYSTAL_5X3.2_2-SMD; MPN ECS-80-12-30-JGN-TR; DIGIKEY 50-ECS-80-12-30-JGN-CT-ND

Connections:
3V3_CORE: C42.1, IC1.5 (VCC), IC1.17 (VCC), IC1.27 (AVCC), IC1.29 (AREF), IC1.38 (VCC), R52.2; also elsewhere on the board
ALIVE_LED: IC1.23 ((PCINT20/TDO)PC4); also elsewhere on the board
C0: IC1.21 ((PCINT18/TCK)PC2); also elsewhere on the board
C1: IC1.22 ((PCINT19/TMS)PC3); also elsewhere on the board
CS_EXT: IC1.37 ((PCINT0/ADC0)PA0); also elsewhere on the board
DTR: C39.1; also elsewhere on the board
EN_BUS_PRIME: IC1.26 ((PCINT23/TOSC2)PC7); also elsewhere on the board
EN_BUS_SEC: IC1.25 ((PCINT22/TOSC1)PC6); also elsewhere on the board
GLOBAL_INT: IC1.33 ((PCINT4/ADC4)PA4); also elsewhere on the board
GND: C40.1, C41.1, C42.2, IC1.6 (GND), IC1.18 (GND), IC1.28 (GND), IC1.39 (GND), IC1.TH (EXP), S4.1, S4.2; also elsewhere on the board
GPIO_0: IC1.13 ((PCINT28/OC1B)PD4); also elsewhere on the board
GPIO_1: IC1.36 ((PCINT1/ADC1)PA1); also elsewhere on the board
GPIO_2: IC1.43 ((PCINT11/OC0A/AIN1)PB3); also elsewhere on the board
GPIO_3: IC1.35 ((PCINT2/ADC2)PA2); also elsewhere on the board
LED1: IC1.14 ((PCINT29/OC1A)PD5); also elsewhere on the board
LED2: IC1.15 ((PCINT30/OC2B/ICP)PD6); also elsewhere on the board
LED3: IC1.16 ((PCINT31/OC2A)PD7); also elsewhere on the board
LOG_INT: IC1.34 ((PCINT3/ADC3)PA3); also elsewhere on the board
MISO: IC1.2 ((PCINT14/MISO)PB6); also elsewhere on the board
MOSI: IC1.1 ((PCINT13/MOSI)PB5); also elsewhere on the board
unnamed: C41.2, IC1.8 (XTAL1), XTAL1.OSC1 (1)
unnamed: C40.2, IC1.7 (XTAL2), XTAL1.OSC2 (2)
PARTICLE_CTS: IC1.31 ((PCINT6/ADC6)PA6); also elsewhere on the board
PARTICLE_GPIO: IC1.32 ((PCINT5/ADC5)PA5); also elsewhere on the board
PARTICLE_RTS: IC1.30 ((PCINT7/ADC7)PA7); also elsewhere on the board
RST: C39.2, IC1.4 (RESET), R52.1, S4.3 (4), S4.4 (3); also elsewhere on the board
RTC_INT: IC1.42 ((PCINT10/INT2/AIN0)PB2); also elsewhere on the board
RX: IC1.9 ((PCINT24/RXD0)PD0); also elsewhere on the board
RX_EXT: IC1.11 ((PCINT26/INT0)PD2); also elsewhere on the board
SCK: IC1.3 ((PCINT15/SCK)PB7); also elsewhere on the board
SCL: IC1.19 ((PCINT16/SCL)PC0); also elsewhere on the board
SDA: IC1.20 ((PCINT17/SDA)PC1); also elsewhere on the board
SDA_CTRL: IC1.24 ((PCINT21/TDI)PC5); also elsewhere on the board
SD_CD: IC1.41 ((PCINT9/CLKO/T1)PB1); also elsewhere on the board
SD_CS: IC1.44 ((PCINT12/OC0B/~SS)PB4); also elsewhere on the board
TX: IC1.10 ((PCINT25/TXD0)PD1); also elsewhere on the board
TX_EXT: IC1.12 ((PCINT27/INT1)PD3); also elsewhere on the board
~LED_EN: IC1.40 ((PCINT8/XCK0/T0)PB0); also elsewhere on the board

Notes on the sheet:
Pin 23
Pin A5/29
Pin 4
Pin 20
Pin 6
Pin 0
Pin 11
Pin 16
Pin 5
Reset
Pin 18
Pin 15
Pin 19
Pin A3/27
Add: GPIO1 GPIO3
Pin A6/30
Pin 1
Pin A1/25
Pin 10
Pin 22
Pin A4/28
Pin A2/26
Pin A0/24
Pin 8
Pin 12
Pin 13
Pin 2
Microcontroller
Pin 3
Pin 17
ATmega1284
Pin 14
Pin A7/31
Pin 9
Clock
Pin 7
Pin 21

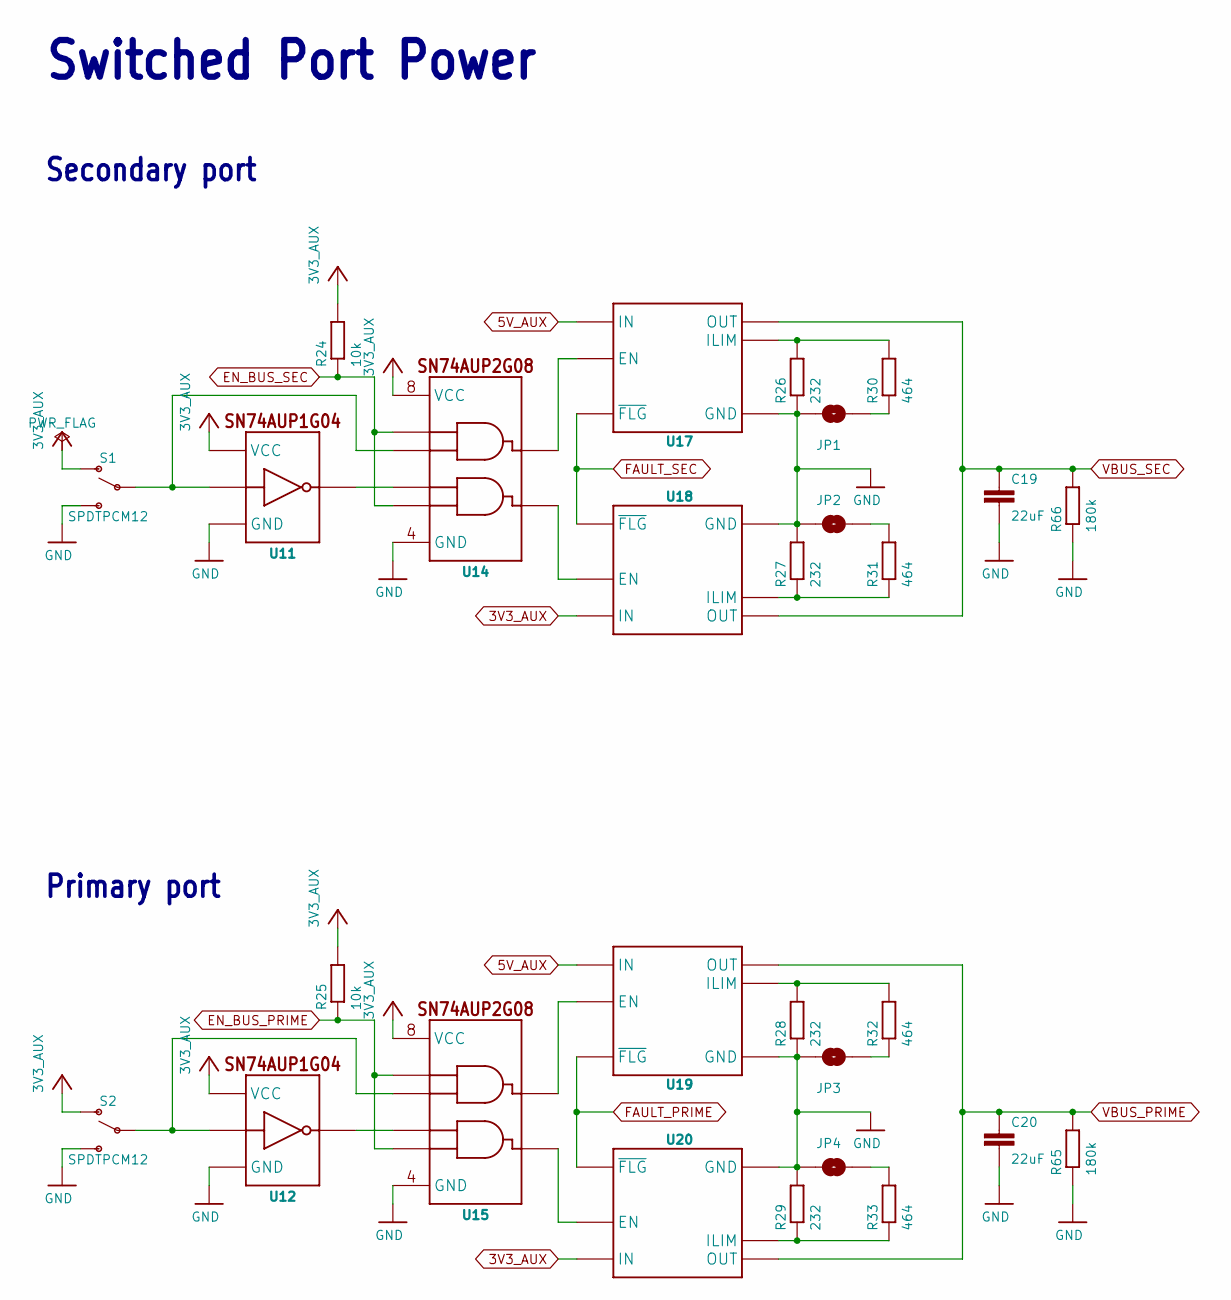
[picture p13: schematic Sensor_Ports.kicad_sch]

Parts:
C19, C20: 22uF; C0805; MPN GRM219R61C226ME15L; DIGIKEY 490-9952-1-ND
JP1, JP2, JP3, JP4: JUMPER-SMT_2_NO_SILK; SMT-JUMPER_2_NO_SILK
R24, R25: 10k; R0402; MPN RC0402FR-0710KL; DIGIKEY 311-10.0KLRCT-ND
R26, R27, R28, R29: 232; R0402; MPN RC0402FR-07232RL; DIGIKEY YAG3063CT-ND
R30, R31, R32, R33: 464; R0402; MPN RC0402FR-07464RL; DIGIKEY 311-464LRCT-ND
R65, R66: 180k; R0402; MPN RC0402FR-07180KL; DIGIKEY 311-180KLRCT-ND
S1, S2: SPDTPCM12; PCM12; MPN PCM12SMTR; DIGIKEY 401-2016-1-ND
U11, U12: SN74AUP1G04YFP; DSBGD_4; MPN SN74AUP1G04YFPR; DIGIKEY 296-25196-1-ND
U14, U15: SN74AUP2G08DQE; DQE_R-PX2SON-N8; MPN SN74AUP2G08DQER; DIGIKEY 296-25638-1-ND
U17, U18, U19, U20: MIC2544MSOP; MSOP_8; MPN MIC2544-1YMM; DIGIKEY 576-1738-5-ND

Connections:
3V3_AUX: R24.2, R25.2, S1.1 (O), S2.1 (O), U11.A2 (VCC), U12.A2 (VCC), U14.8 (VCC), U15.8 (VCC), U18.7 (IN), U20.7 (IN); also elsewhere on the board
5V_AUX: U17.7 (IN), U19.7 (IN); also elsewhere on the board
EN_BUS_PRIME: R25.1, U15.1 (A1), U15.6 (B2); also elsewhere on the board
EN_BUS_SEC: R24.1, U14.1 (A1), U14.6 (B2); also elsewhere on the board
FAULT_PRIME: U19.2 (~FLG), U20.2 (~FLG); also elsewhere on the board
FAULT_SEC: U17.2 (~FLG), U18.2 (~FLG); also elsewhere on the board
GND: C19.2, C20.2, JP1.1, JP2.1, JP3.1, JP4.1, R26.1, R27.2, R28.1, R29.2, R65.1, R66.1, S1.3 (S), S2.3 (S), U11.B1 (GND), U12.B1 (GND), U14.4 (GND), U15.4 (GND), U17.3 (GND), U18.3 (GND), U19.3 (GND), U20.3 (GND); also elsewhere on the board
unnamed: JP1.2, R30.1
unnamed: JP2.2, R31.2
unnamed: JP3.2, R32.1
unnamed: JP4.2, R33.2
unnamed: S1.2, U11.A1 (A), U14.2 (B1)
unnamed: S2.2, U12.A1 (A), U15.2 (B1)
unnamed: U11.B2 (Y), U14.5 (A2)
unnamed: U12.B2 (Y), U15.5 (A2)
unnamed: U14.7 (Y1), U17.1 (EN)
unnamed: U14.3 (Y2), U18.1 (EN)
unnamed: U15.7 (Y1), U19.1 (EN)
unnamed: U15.3 (Y2), U20.1 (EN)
unnamed: R26.2, R30.2, U17.5 (ILIM)
unnamed: R27.1, R31.1, U18.5 (ILIM)
unnamed: R28.2, R32.2, U19.5 (ILIM)
unnamed: R29.1, R33.1, U20.5 (ILIM)
VBUS_PRIME: C20.1, R65.2, U19.6 (OUT), U19.8 (OUT), U20.6 (OUT), U20.8 (OUT); also elsewhere on the board
VBUS_SEC: C19.1, R66.2, U17.6 (OUT), U17.8 (OUT), U18.6 (OUT), U18.8 (OUT); also elsewhere on the board

Notes on the sheet:
Primary port
Secondary port
Switched Port Power

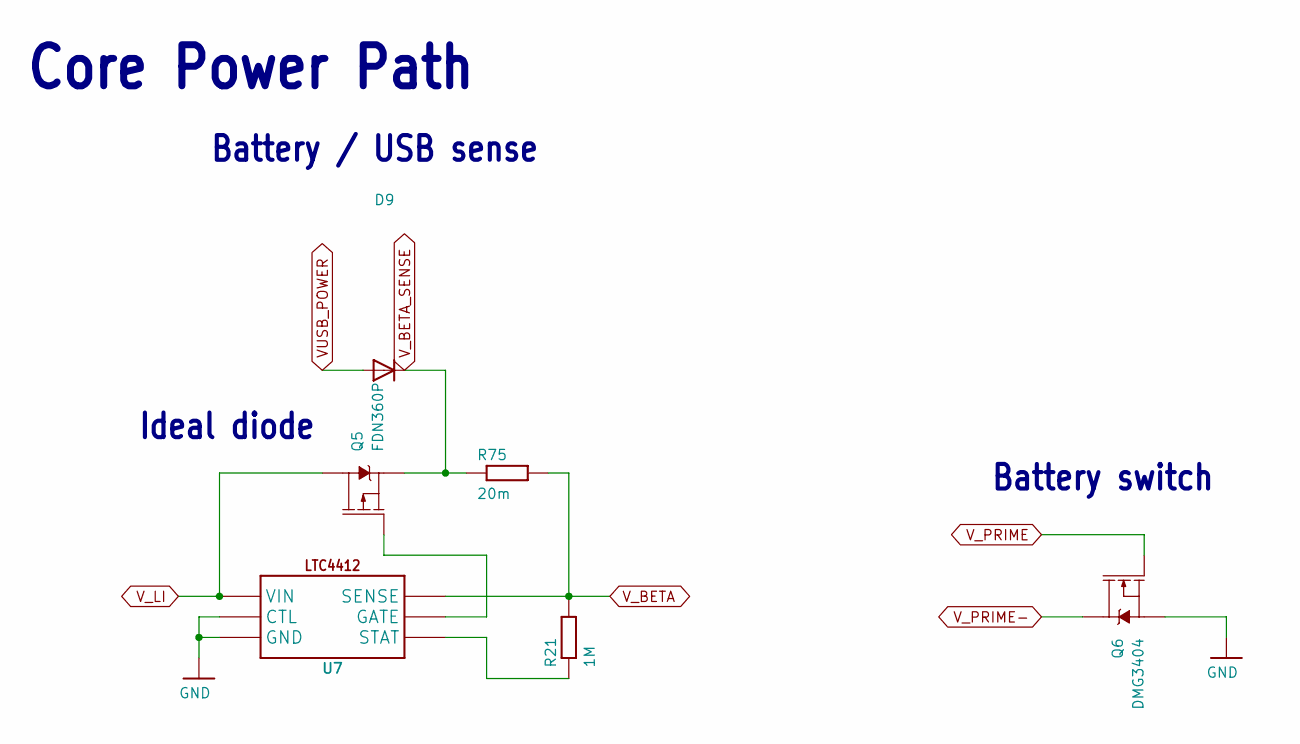
[picture p14: schematic Core_Power_Path.kicad_sch]

Parts:
D9: DIODEDO-214AC; DO214AC; MPN B340A-13-F; DIGIKEY B340A-FDICT-ND
Q5: FDN360P; SOT23-3; MPN FDN360P; DIGIKEY FDN360PCT-ND
Q6: DMG3404; SOT23-3; MPN DMG3404L-7; DIGIKEY DMG3404L-7DICT-ND
R21: 1M; R0603; MPN ERJ-3EKF1004V; DIGIKEY P1.00MHCT-ND
R75: 20m; R0805; MPN ERJ-6BWFR020V; DIGIKEY P.02AQCT-ND
U7: LTC4412S6; SOT23-6L; MPN LTC4412ES6#TRPBF; DIGIKEY LTC4412ES6#TRPBFCT-ND

Connections:
GND: Q6.2 (S), U7.2 (GND), U7.3 (CTL); also elsewhere on the board
unnamed: Q5.1 (G), U7.5 (GATE)
unnamed: R21.1, U7.4 (STAT)
VUSB_POWER: D9.A; also elsewhere on the board
V_BETA: R21.2, R75.2, U7.6 (SENSE); also elsewhere on the board
V_BETA_SENSE: D9.C, Q5.2 (S), R75.1; also elsewhere on the board
V_LI: Q5.3 (D), U7.1 (VIN); also elsewhere on the board
V_PRIME: Q6.1 (G); also elsewhere on the board
V_PRIME-: Q6.3 (D); also elsewhere on the board

Notes on the sheet:
Core Power Path
Battery switch
Ideal diode
Battery / USB sense
