NorthernWidget/Project-Okapi/Hardware/KiCAD-10import/Okapi.kicad_pcb

## KiCad design Hardware/KiCAD-10import/Okapi.kicad_pcb (continued)

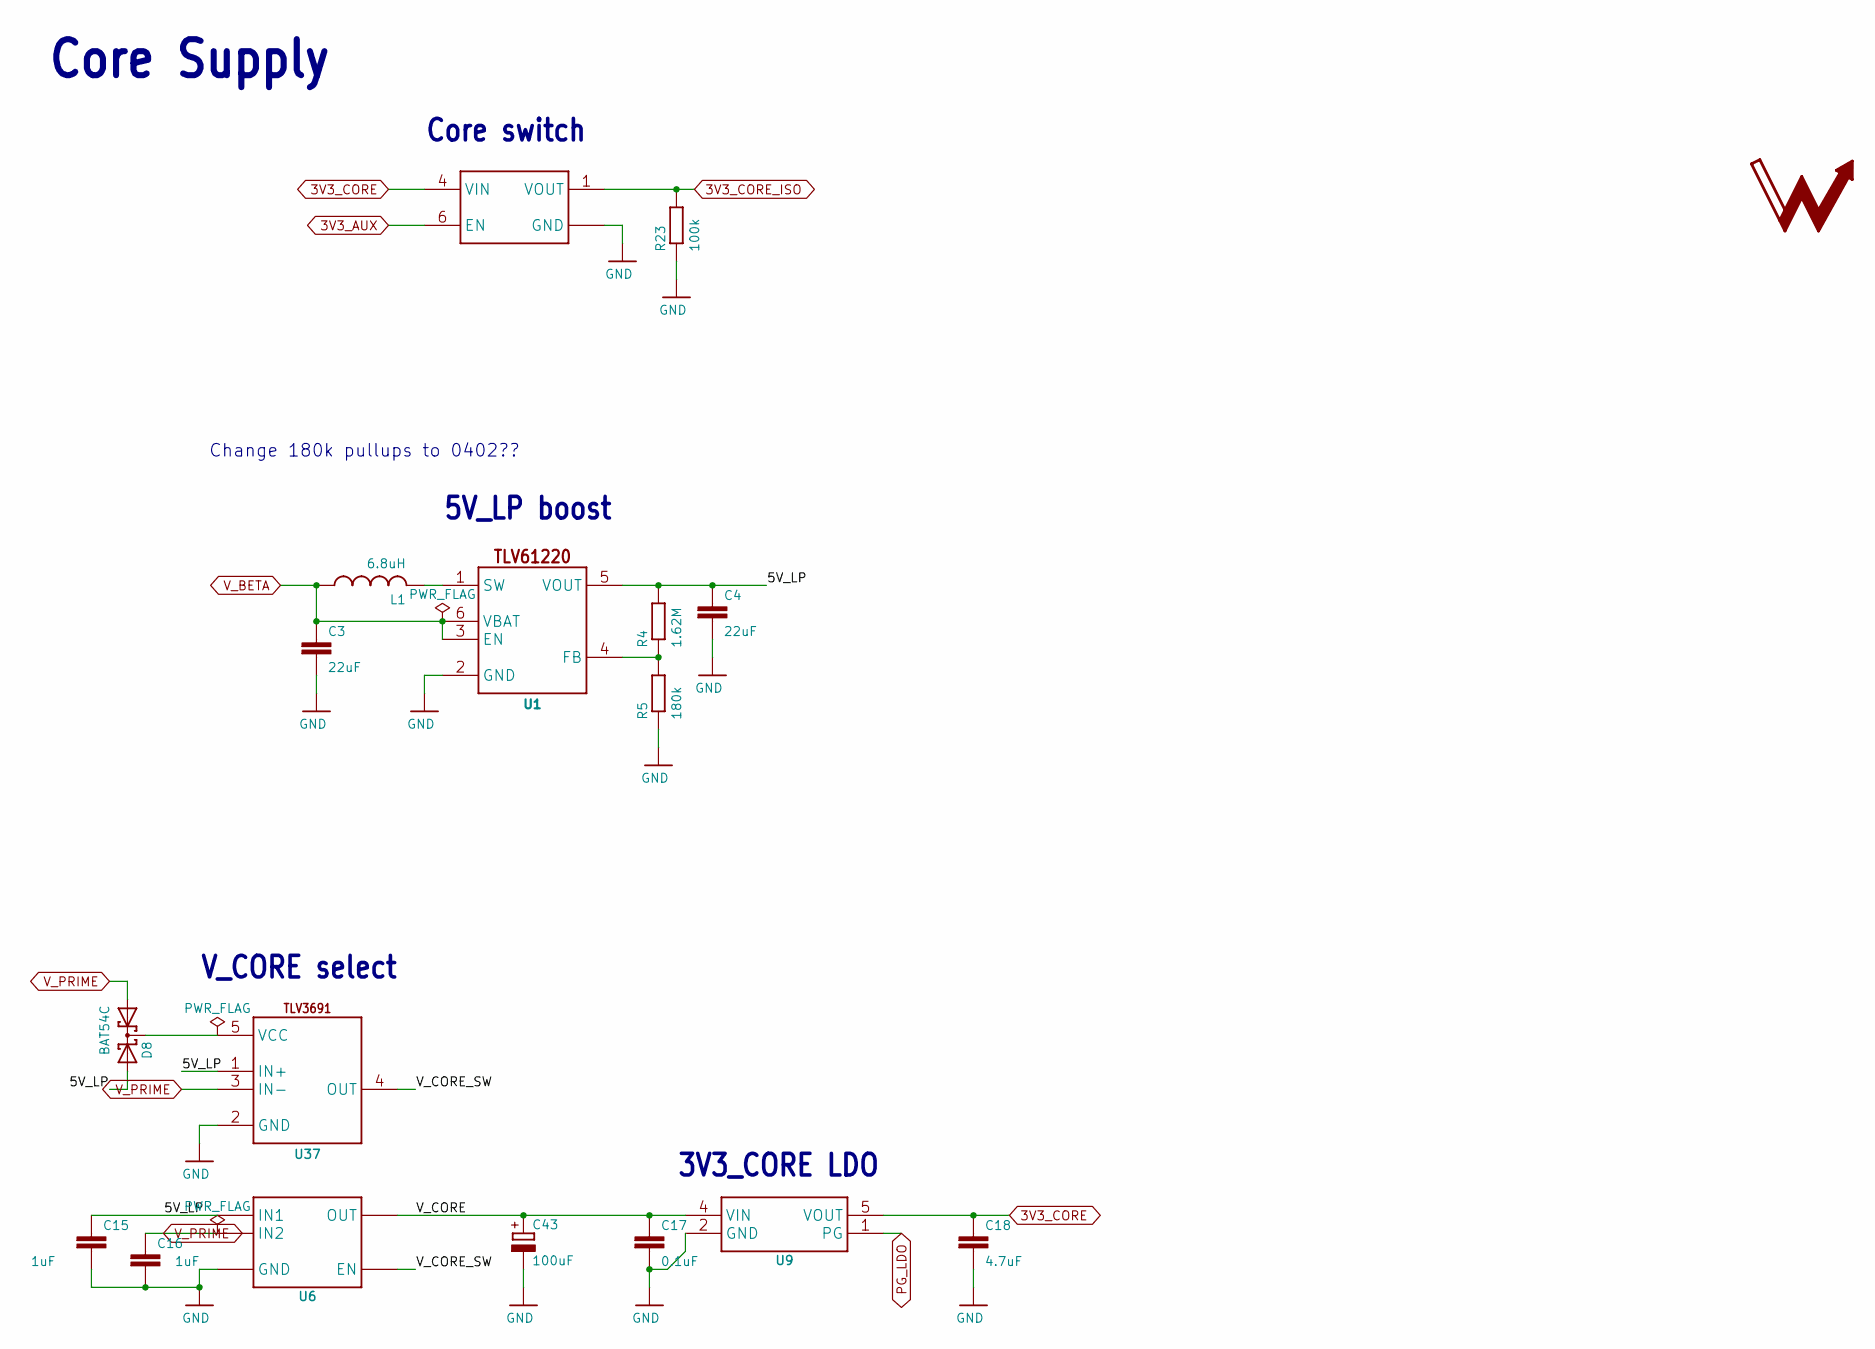
[picture p15: schematic Core_Supply.kicad_sch]

Parts:
C3, C4: 22uF; C0805; MPN GRM219R61C226ME15L; DIGIKEY 490-9952-1-ND
C15, C16: 1uF; C0402; MPN CL05A105KA5NQNC; DIGIKEY 1276-1445-1-ND
C17: 0.1uF; C0402; MPN GCM155R71C104KA55D; DIGIKEY 490-4759-1-ND
C18: 4.7uF; C0603; MPN GRM188Z71C475KE21D; DIGIKEY 490-GRM188Z71C475KE21DCT-ND
C43: 100uF; C1206_TANT; MPN GRM31CR61A107MEA8L; DIGIKEY 490-GRM31CR61A107MEA8LCT-ND
D8: BAT54C; SOT23-3; MPN BAT54CLT1G; DIGIKEY BAT54CLT1GOSCT-ND
L1: 6.8uH; 1008; MPN 74438323068; DIGIKEY 732-4849-1-ND
LOGO1: NWLOGO_MED
R4: 1.62M; R0603; MPN CRCW06031M62FKEA; DIGIKEY 541-1.62MHCT-ND
R5: 180k; R0402; MPN RC0402FR-07180KL; DIGIKEY 311-180KLRCT-ND
R23: 100k; R0402; MPN RC0402FR-07100KL; DIGIKEY 311-100KLRCT-ND
U1: TLV61220DBV; DBV_R-PDSO-G6; MPN TLV61220DBVR; DIGIKEY 296-30547-1-ND
U6: TPS2105; SOT23-5; MPN TPS2105DBVR; DIGIKEY 296-10883-1-ND
U9: TPS797; DCK_R-PDSO-G5; MPN TPS79733DCKR; DIGIKEY 296-11990-1-ND
U37: TLV3691DCK; DCK_R-PDSO-G5; MPN TLV3691IDCKR; DIGIKEY 296-37910-1-ND
U39: MIC94094C6; SC-70_6; MPN MIC94094YC6-TR; DIGIKEY 576-3492-1-ND

Connections:
3V3_AUX: U39.6 (EN); also elsewhere on the board
3V3_CORE: C18.1, U9.5 (VOUT), U39.4 (VIN); also elsewhere on the board
3V3_CORE_ISO: R23.2, U39.1 (VOUT); also elsewhere on the board
/Core_Supply/5V_LP: C4.1, C15.1, D8.2 (A2), R4.2, U1.5 (VOUT), U6.5 (IN1), U37.1 (IN+)
/Core_Supply/V_CORE: C17.1, C43.+, U6.4 (OUT), U9.4 (VIN)
/Core_Supply/V_CORE_SW: U6.1 (EN), U37.4 (OUT)
GND: C3.2, C4.2, C15.2, C16.2, C17.2, C18.2, C43.-, R5.1, R23.1, U1.2 (GND), U6.2 (GND), U9.2 (GND), U37.2 (GND), U39.2 (GND), U39.5 (GND); also elsewhere on the board
unnamed: D8.3 (C), U37.5 (VCC)
unnamed: R4.1, R5.2, U1.4 (FB)
unnamed: L1.2, U1.1 (SW)
PG_LDO: U9.1 (PG); also elsewhere on the board
V_BETA: C3.1, L1.1, U1.3 (EN), U1.6 (VBAT); also elsewhere on the board
V_PRIME: C16.1, D8.1 (A1), U6.3 (IN2), U37.3 (IN-); also elsewhere on the board

Notes on the sheet:
5V_LP boost
Core switch
Core Supply
3V3_CORE LDO
V_CORE select
Change 180k pullups to 0402??

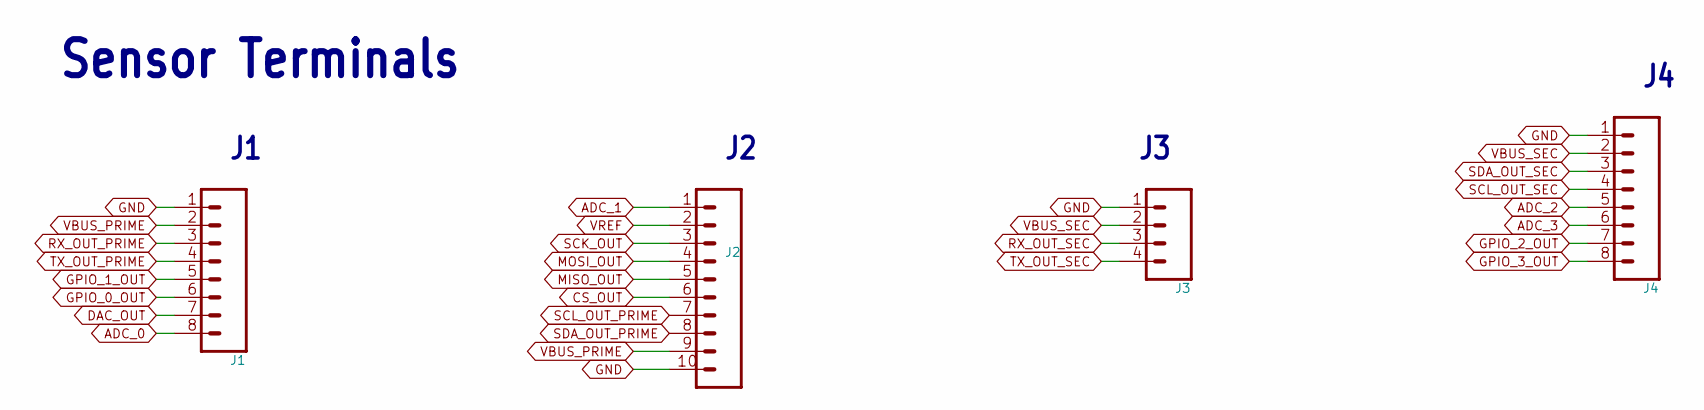
[picture p16: schematic Sensor_Terminals.kicad_sch]

Parts:
J1, J4: CONN_82.54_SCREW; 1X08_SCREW; MPN OSTVN08A150; DIGIKEY ED10566-ND
J2: CONN_102.54_SCREW; 1X10_SCREW; MPN OSTVN10A150; DIGIKEY ED10567-ND
J3: CONN_42.54_SCREW; 1X04_SCREW; MPN OSTVN04A150; DIGIKEY ED10563-ND

Connections:
ADC_0: J1.8; also elsewhere on the board
ADC_1: J2.1; also elsewhere on the board
ADC_2: J4.5; also elsewhere on the board
ADC_3: J4.6; also elsewhere on the board
CS_OUT: J2.6; also elsewhere on the board
DAC_OUT: J1.7; also elsewhere on the board
GND: J1.1, J2.10, J3.1, J4.1; also elsewhere on the board
GPIO_0_OUT: J1.6; also elsewhere on the board
GPIO_1_OUT: J1.5; also elsewhere on the board
GPIO_2_OUT: J4.7; also elsewhere on the board
GPIO_3_OUT: J4.8; also elsewhere on the board
MISO_OUT: J2.5; also elsewhere on the board
MOSI_OUT: J2.4; also elsewhere on the board
RX_OUT_PRIME: J1.3; also elsewhere on the board
RX_OUT_SEC: J3.3; also elsewhere on the board
SCK_OUT: J2.3; also elsewhere on the board
SCL_OUT_PRIME: J2.7; also elsewhere on the board
SCL_OUT_SEC: J4.4; also elsewhere on the board
SDA_OUT_PRIME: J2.8; also elsewhere on the board
SDA_OUT_SEC: J4.3; also elsewhere on the board
TX_OUT_PRIME: J1.4; also elsewhere on the board
TX_OUT_SEC: J3.4; also elsewhere on the board
VBUS_PRIME: J1.2, J2.9; also elsewhere on the board
VBUS_SEC: J3.2, J4.2; also elsewhere on the board
VREF: J2.2; also elsewhere on the board

Notes on the sheet:
Sensor Terminals

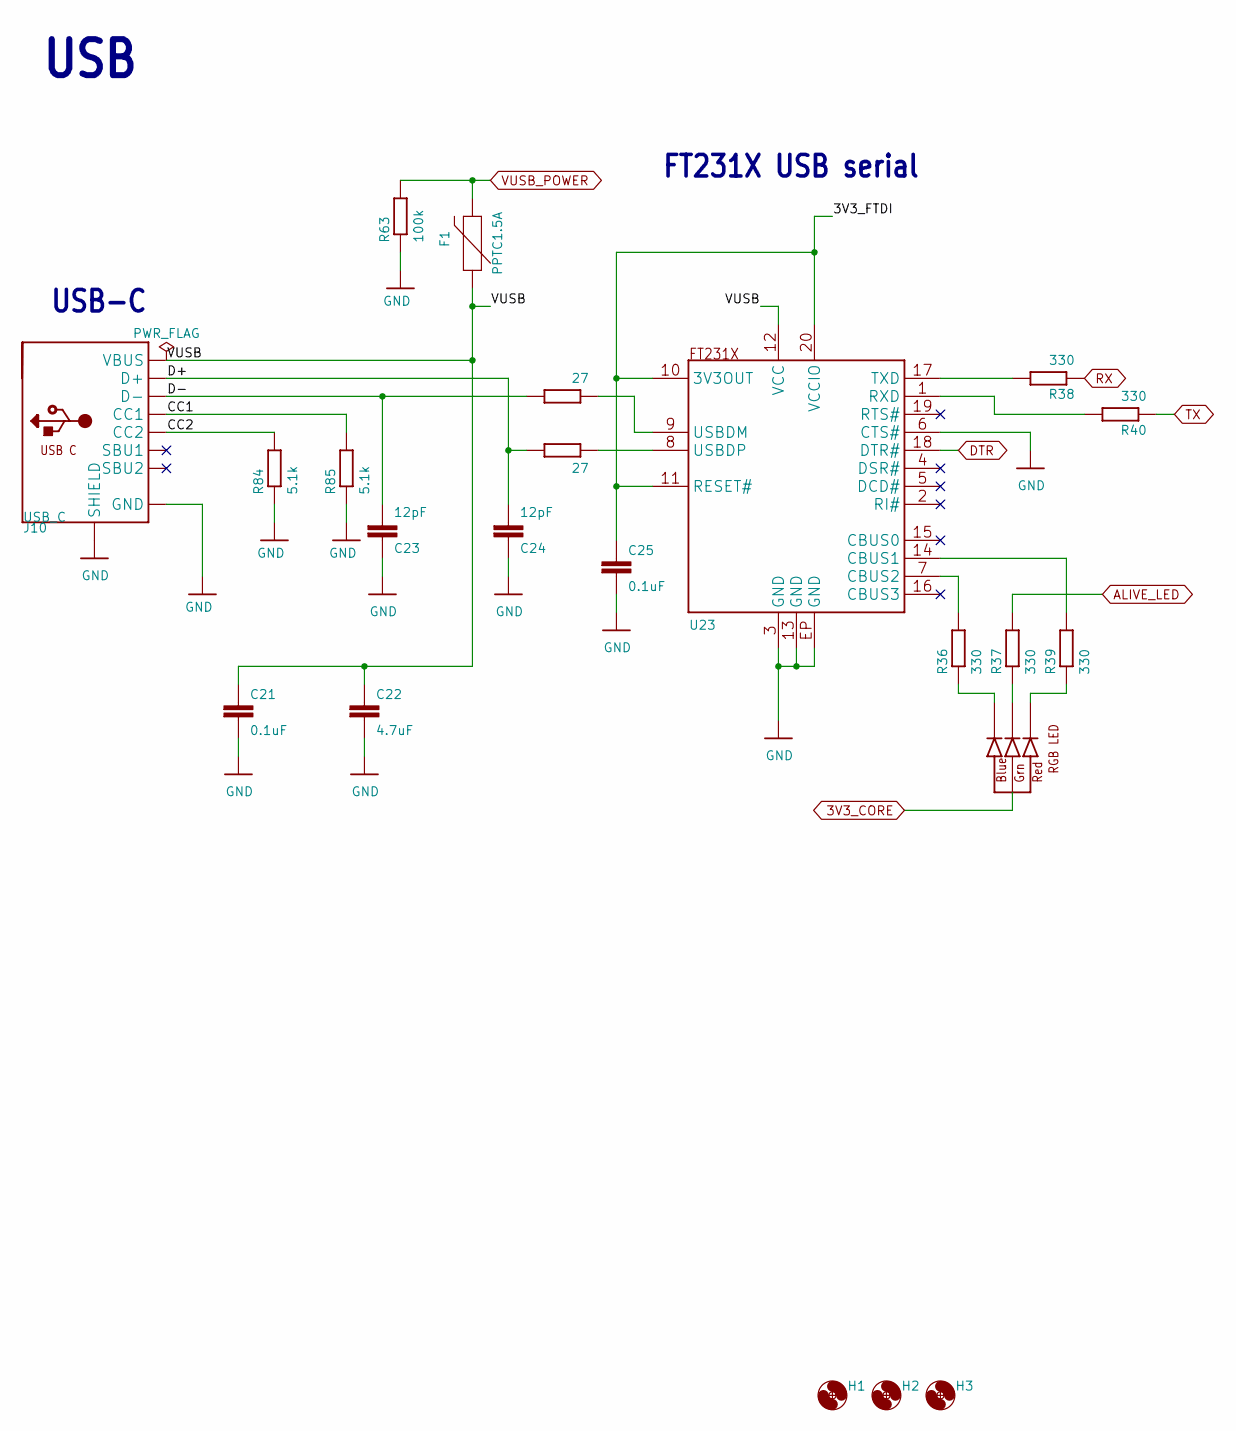
[picture p17: schematic USB_ISP_Feather.kicad_sch]

Parts:
C21, C25: 0.1uF; C0402; MPN GCM155R71C104KA55D; DIGIKEY 490-4759-1-ND
C22: 4.7uF; C0603; MPN GRM188Z71C475KE21D; DIGIKEY 490-GRM188Z71C475KE21DCT-ND
C23, C24: 12pF; C0402; MPN CGA2B2C0G1H120J050BA; DIGIKEY 445-5585-1-ND
D4: CLVBA-FKA; MPN CLVBA-FKA-CAEDH8BBB7A363; DIGIKEY CLVBA-FKA-CAEDH8BBB7A363CT-ND
F1: PPTC1.5A; 1206; MPN MF-NSMF150-2; DIGIKEY MF-NSMF150-2CT-ND
H1, H2, H3: MOUNTING_HOLE4_NP; 4_40; MPN DNP; DIGIKEY DNP
J10: USB_C; USB_C_CUSB31-CFM2AX-01-X; MPN USB4105-GF-A; DIGIKEY 2073-USB4105-GF-ACT-ND
R34, R35: 27; R0402; MPN RC0402FR-0727RL; DIGIKEY YAG3086CT-ND
R36, R37, R38, R39, R40: 330; R0402; MPN RC0402FR-07330RL; DIGIKEY 311-330LRCT-ND
R63: 100k; R0402; MPN RC0402FR-07100KL; DIGIKEY 311-100KLRCT-ND
R84, R85: 5.1k; R0402; MPN RC0402FR-075K1L; DIGIKEY 311-5.10KLRCT-ND
U23: FT231X-Q; QFN20; MPN FT231XQ-R; DIGIKEY 768-1128-1-ND

Connections:
3V3_CORE: D4.2 (ANODE); also elsewhere on the board
/USB_ISP_Feather/3V3_FTDI: C25.1, U23.10 (3V3OUT), U23.11 (RESET#), U23.20 (VCCIO)
/USB_ISP_Feather/CC1: J10.A5 (CC1), R85.2
/USB_ISP_Feather/CC2: J10.B5 (CC2), R84.2
/USB_ISP_Feather/D+: C24.2, J10.A6 (D+), J10.B6 (D+), R35.2
/USB_ISP_Feather/D-: C23.2, J10.A7 (D-), J10.B7 (D-), R34.2
/USB_ISP_Feather/VUSB: C21.1, C22.1, F1.1, J10.A4B9 (VBUS), J10.B4A9 (VBUS), U23.12 (VCC)
ALIVE_LED: R37.2; also elsewhere on the board
DTR: U23.18 (DTR#); also elsewhere on the board
GND: C21.2, C22.2, C23.1, C24.1, C25.2, J10.A1B12 (GND), J10.B1A12 (GND), J10.S1 (SHIELD), R63.1, R84.1, R85.1, U23.3 (GND), U23.6 (CTS#), U23.13 (GND), U23.EP (GND); also elsewhere on the board
unnamed: D4.3 (BLUE_CATH), R36.1
unnamed: D4.4 (GREEN_CATH), R37.1
unnamed: D4.1 (RED_CATH), R39.1
unnamed: R39.2, U23.14 (CBUS1)
unnamed: R36.2, U23.7 (CBUS2)
unnamed: R40.2, U23.1 (RXD)
unnamed: R38.2, U23.17 (TXD)
unnamed: R34.1, U23.9 (USBDM)
unnamed: R35.1, U23.8 (USBDP)
RX: R38.1; also elsewhere on the board
TX: R40.1; also elsewhere on the board
VUSB_POWER: F1.2, R63.2; also elsewhere on the board

Notes on the sheet:
FT231X USB serial
USB-C
USB

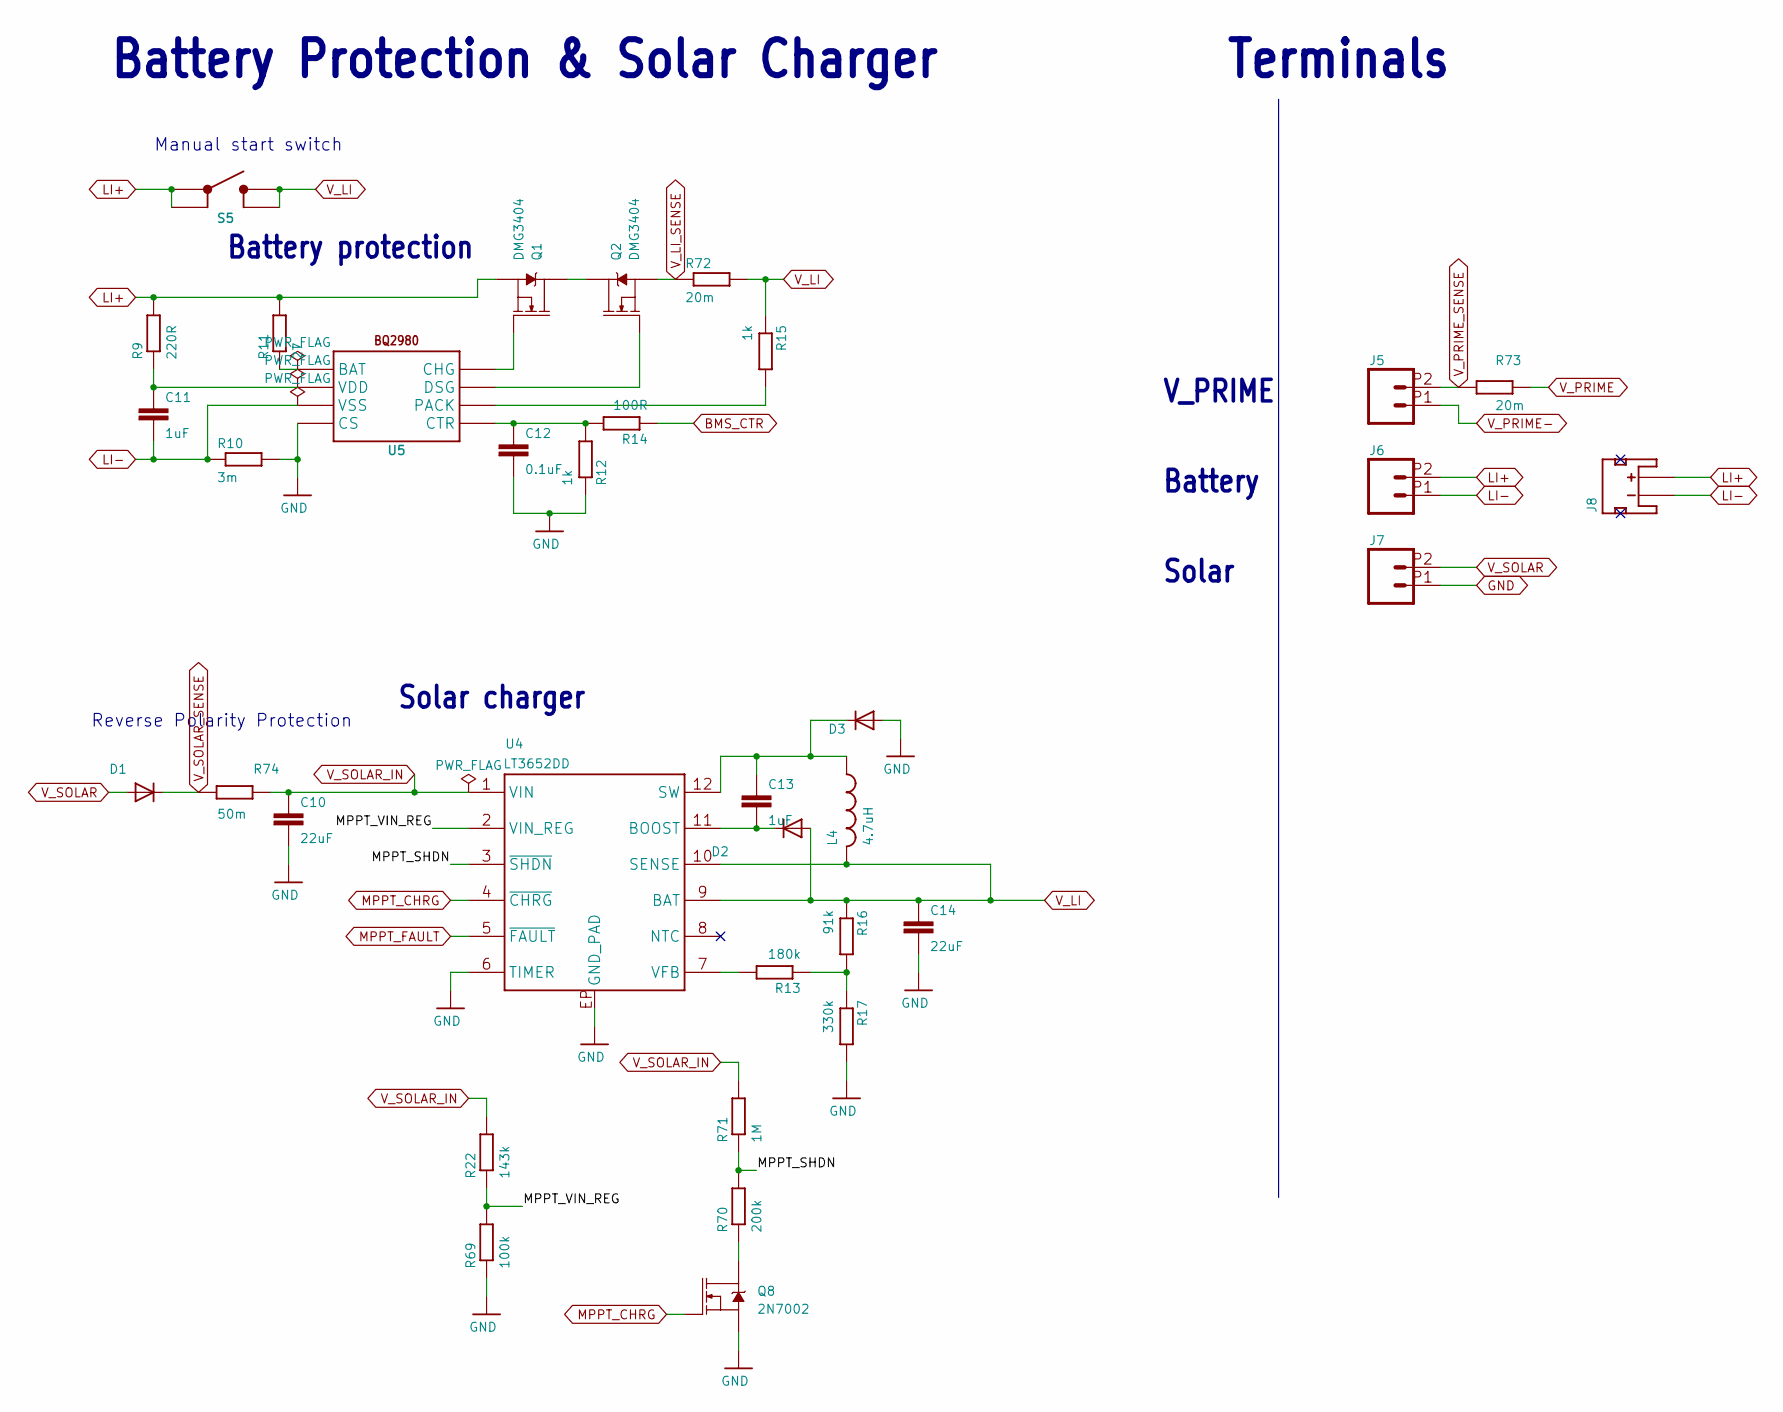
[picture p18: schematic Power_Input.kicad_sch]

Parts:
C10, C14: 22uF; C0805; MPN GRM219R61C226ME15L; DIGIKEY 490-9952-1-ND
C11, C13: 1uF; C0603; MPN TMK107B7105KA-T; DIGIKEY 587-2984-1-ND
C12: 0.1uF; C0402; MPN GCM155R71C104KA55D; DIGIKEY 490-4759-1-ND
D1, D3: DIODEDO-214AC; DO214AC; MPN CMSH3-40MA TR13; DIGIKEY CMSH3-40MATR13CT-ND
D2: DIODESOD-323; SOD323-R; MPN CMDSH2-3 TR; DIGIKEY CMDSH2-3CT-ND
J5, J6, J7: CONN_022.54_SCREW; 1X02_2.54_SCREWTERM; MPN OSTVN02A150; DIGIKEY ED10561-ND
J8: JST_2MM_MALE; JST-2-SMD; MPN S2B-PH-SM4-TB(LF)(SN); DIGIKEY 455-1749-1-ND
L4: 4.7uH; WE-MAIA(4.1X4.1); MPN 78438356047; DIGIKEY 732-11316-1-ND
Q1, Q2: DMG3404; SOT23-3; MPN DMG3404L-7; DIGIKEY DMG3404L-7DICT-ND
Q8: 2N7002; SOT323; MPN 2N7002WT1G; DIGIKEY 2N7002WT1GOSCT-ND
R9: 220R; R0402; MPN CRGCQ0402F220R; DIGIKEY A129619CT-ND
R10: 3m; R0805; MPN PMR10EZPFV3L00; DIGIKEY RHM.003AJCT-ND
R11: 27; R0402; MPN RC0402FR-0727RL; DIGIKEY YAG3086CT-ND
R12, R15: 1k; R0402; MPN RC0402FR-071KL; DIGIKEY 311-1.00KLRCT-ND
R13: 180k; R0603; MPN ERJ-3EKF1803V; DIGIKEY P180KHCT-ND
R14: 100R; R0402; MPN RC0402FR-07100RL; DIGIKEY 311-100LRCT-ND
R16: 91k; R0603; MPN ERJ-3EKF9102V; DIGIKEY P91.0KHCT-ND
R17: 330k; R0603; MPN ERJ-3EKF3303V; DIGIKEY P330KHCT-ND
R22: 143k; R0402_0603; MPN RC0603FR-07143KL; DIGIKEY 311-143KHRCT-ND
R69: 100k; R0402_0603; MPN RC0402FR-07100KL; DIGIKEY 311-100KLRCT-ND
R70: 200k; R0402_0603; MPN ERJ-2RKF2003X; DIGIKEY P200KLCT-ND
R71: 1M; R0402_0603; MPN RC0402FR-071ML; DIGIKEY 311-1.00MLRCT-ND
R72, R73: 20m; R0805; MPN ERJ-6BWFR020V; DIGIKEY P.02AQCT-ND
R74: 50m; R0805; MPN ERJ-6BWFR050V; DIGIKEY P17581CT-ND
S5: BUTTON2.6X1.6; SWITCH_2.6X1.6; MPN EVP-BB2A9B000; DIGIKEY P19888CT-ND
U4: LT3652DD; DFN_12_3X3; MPN LT3652EDD#PBF; DIGIKEY LT3652EDD#PBF-ND
U5: BQ2980RUG; RUG_S-PQFP-N8; MPN BQ298000RUGT; DIGIKEY 296-47578-1-ND

Connections:
/Power_Input/MPPT_SHDN: R70.2, R71.1, U4.3 (~SHDN)
/Power_Input/MPPT_VIN_REG: R22.1, R69.2, U4.2 (VIN_REG)
BMS_CTR: R14.1; also elsewhere on the board
GND: C10.2, C12.2, C14.2, D3.A, J7.P1 (1), Q8.2 (S), R10.2, R12.1, R17.2, R69.1, U4.6 (TIMER), U4.EP (GND_PAD), U5.4 (CS); also elsewhere on the board
LI+: J6.P2 (2), J8.2 (+), Q1.2 (S), R9.2, R11.2, S5.A (1), S5.A' (2)
LI-: C11.2, J6.P1 (1), J8.1 (-), R10.1, U5.3 (VSS)
MPPT_CHRG: Q8.1 (G), U4.4 (~CHRG); also elsewhere on the board
MPPT_FAULT: U4.5 (~FAULT); also elsewhere on the board
unnamed: C13.1, D3.C, L4.P$1 (1), U4.12 (SW)
unnamed: Q1.3 (D), Q2.3 (D)
unnamed: Q1.1 (G), U5.8 (CHG)
unnamed: Q2.1 (G), U5.7 (DSG)
unnamed: Q8.3 (D), R70.1
unnamed: R13.1, R16.2, R17.1
unnamed: C13.2, D2.C, U4.11 (BOOST)
unnamed: R13.2, U4.7 (VFB)
unnamed: R11.1, U5.1 (BAT)
unnamed: C12.1, R12.2, R14.2, U5.5 (CTR)
unnamed: R15.2, U5.6 (PACK)
unnamed: C11.1, R9.1, U5.2 (VDD)
V_LI: C14.1, D2.A, L4.P$2 (2), R15.1, R16.1, R72.2, S5.B (3), S5.B' (4), U4.9 (BAT), U4.10 (SENSE); also elsewhere on the board
V_LI_SENSE: Q2.2 (S), R72.1; also elsewhere on the board
V_PRIME: R73.2; also elsewhere on the board
V_PRIME-: J5.P1 (1); also elsewhere on the board
V_PRIME_SENSE: J5.P2 (2), R73.1; also elsewhere on the board
V_SOLAR: D1.A, J7.P2 (2)
V_SOLAR_IN: C10.1, R22.2, R71.2, R74.2, U4.1 (VIN); also elsewhere on the board
V_SOLAR_SENSE: D1.C, R74.1; also elsewhere on the board

Notes on the sheet:
V_PRIME
Solar
Battery protection
Solar charger
Battery
Reverse Polarity Protection
Terminals
Battery Protection & Solar Charger
Manual start switch

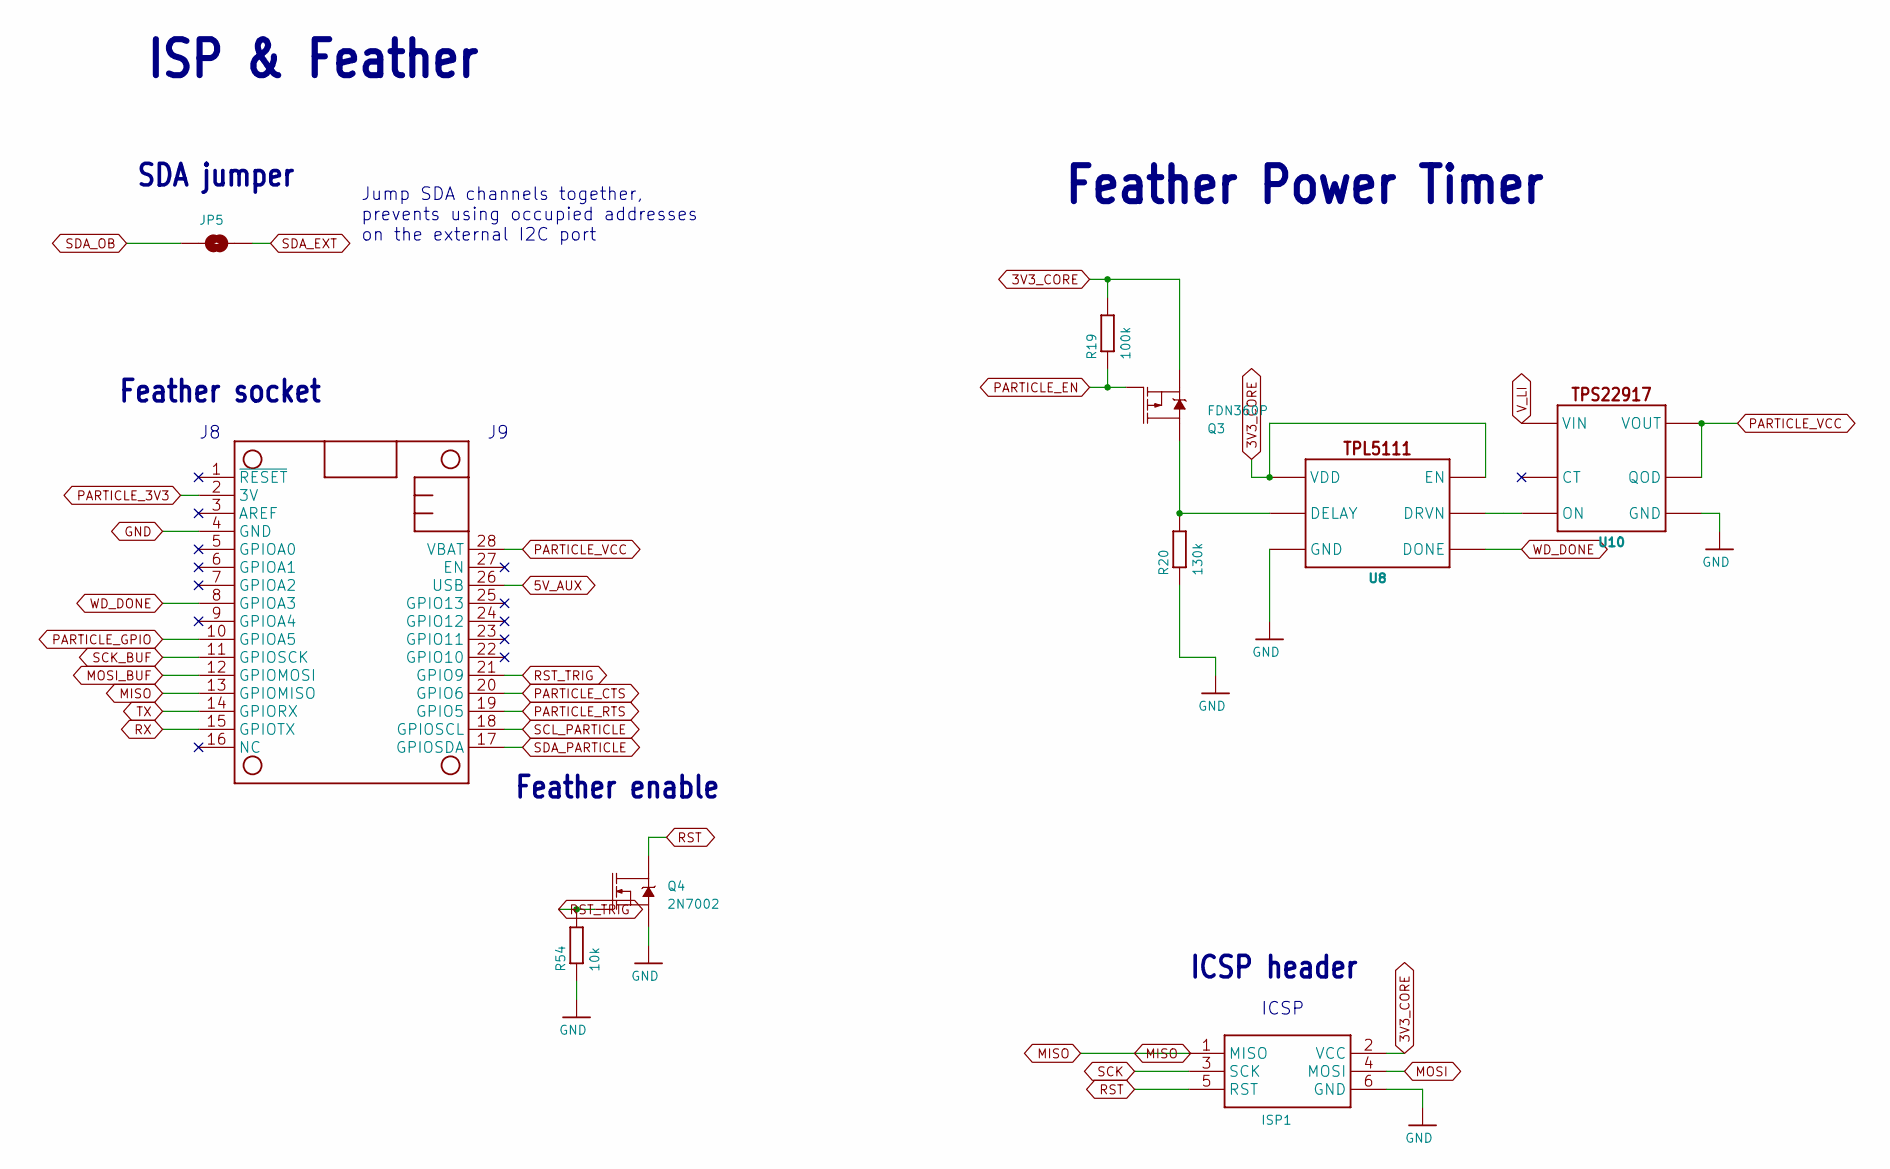
[picture p19: schematic Feather_ISP.kicad_sch]

Parts:
ISP1: AVRISP-6; AVRISP; MPN 67997-206HLF; DIGIKEY 609-3234-ND
JP5: JUMPER-SMT_2_NO_SILK; SMT-JUMPER_2_NO_SILK
MS1: FEATHERWINGLAYOUT; FEATHERWING_MIN
Q3: FDN360P; SOT23-3; MPN FDN360P; DIGIKEY FDN360PCT-ND
Q4: 2N7002; SOT323; MPN 2N7002WT1G; DIGIKEY 2N7002WT1GOSCT-ND
R19: 100k; R0402; MPN RC0402FR-07100KL; DIGIKEY 311-100KLRCT-ND
R20: 130k; R0603; MPN ERJ-3EKF1303V; DIGIKEY P130KHCT-ND
R54: 10k; R0402; MPN RC0402FR-0710KL; DIGIKEY 311-10.0KLRCT-ND
U8: TPL5111DDC; DDC_R-PDSO-G6; MPN TPL5111DDCR; DIGIKEY 296-46226-1-ND
U10: TPS22917DBV; DBV_R-PDSO-G6; MPN TPS22917DBVT; DIGIKEY 296-48370-1-ND

Connections:
3V3_CORE: ISP1.2 (VCC), Q3.2 (S), R19.2, U8.1 (VDD), U8.6 (EN); also elsewhere on the board
5V_AUX: MS1.26 (USB); also elsewhere on the board
GND: ISP1.6 (GND), MS1.4 (GND), Q4.2 (S), R20.1, R54.1, U8.2 (GND), U10.2 (GND); also elsewhere on the board
MISO: ISP1.1 (MISO), MS1.13 (GPIOMISO); also elsewhere on the board
MOSI: ISP1.4 (MOSI); also elsewhere on the board
MOSI_BUF: MS1.12 (GPIOMOSI); also elsewhere on the board
unnamed: Q3.3 (D), R20.2, U8.3 (DELAY)
unnamed: U8.5 (DRVN), U10.3 (ON)
PARTICLE_3V3: MS1.2 (3V); also elsewhere on the board
PARTICLE_CTS: MS1.20 (GPIO6); also elsewhere on the board
PARTICLE_EN: Q3.1 (G), R19.1; also elsewhere on the board
PARTICLE_GPIO: MS1.10 (GPIOA5); also elsewhere on the board
PARTICLE_RTS: MS1.19 (GPIO5); also elsewhere on the board
PARTICLE_VCC: MS1.28 (VBAT), U10.5 (QOD), U10.6 (VOUT); also elsewhere on the board
RST: ISP1.5 (RST), Q4.3 (D); also elsewhere on the board
RST_TRIG: MS1.21 (GPIO9), Q4.1 (G), R54.2; also elsewhere on the board
RX: MS1.15 (GPIOTX); also elsewhere on the board
SCK: ISP1.3 (SCK); also elsewhere on the board
SCK_BUF: MS1.11 (GPIOSCK); also elsewhere on the board
SCL_PARTICLE: MS1.18 (GPIOSCL); also elsewhere on the board
SDA_EXT: JP5.2; also elsewhere on the board
SDA_OB: JP5.1; also elsewhere on the board
SDA_PARTICLE: MS1.17 (GPIOSDA); also elsewhere on the board
TX: MS1.14 (GPIORX); also elsewhere on the board
V_LI: U10.1 (VIN); also elsewhere on the board
WD_DONE: MS1.8 (GPIOA3), U8.4 (DONE); also elsewhere on the board

Notes on the sheet:
SDA jumper
ICSP header
Jump SDA channels together, prevents using occupied addresses on the external I2C port
Feather Power Timer
ISP & Feather
Feather socket
ICSP
Feather enable

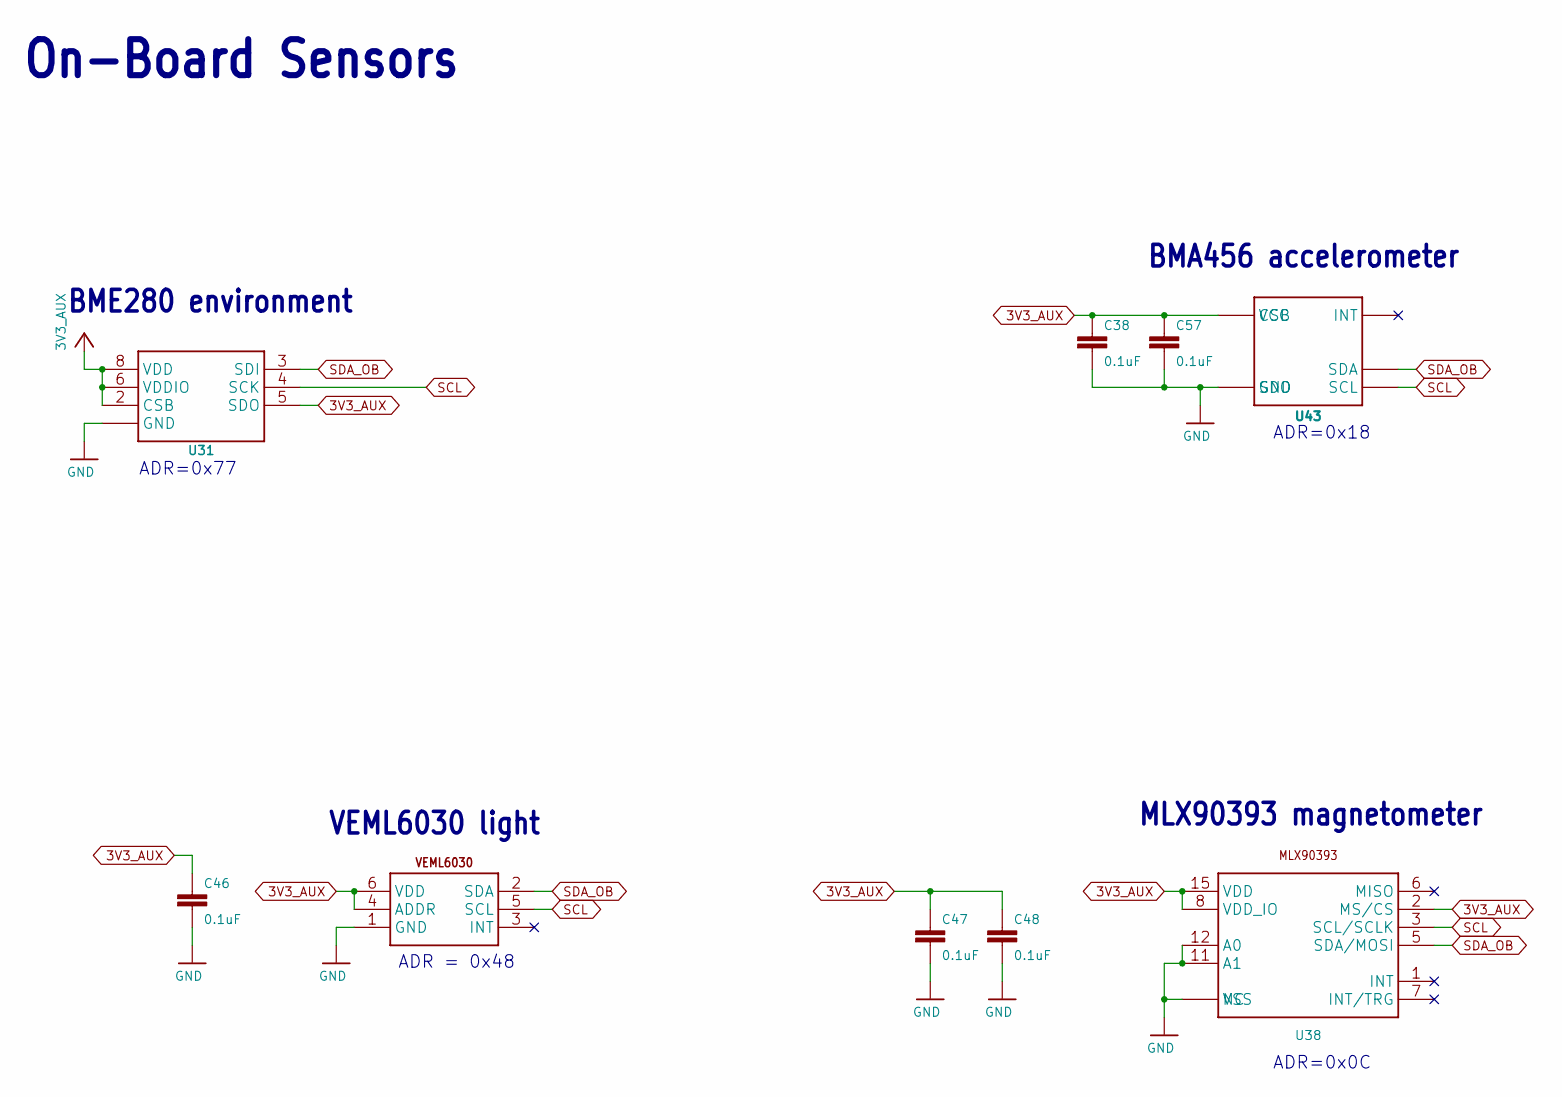
[picture p20: schematic Sensors.kicad_sch]

Parts:
C38, C46, C47, C48, C57: 0.1uF; C0402; MPN GCM155R71C104KA55D; DIGIKEY 490-4759-1-ND
U31: BME280; MPN BME280; DIGIKEY 828-1063-1-ND
U38: MLX90393; QFN16_3X3; MPN MLX90393SLW-ABA-011-RE; DIGIKEY MLX90393SLW-ABA-011-RECT-ND
U43: BMA456; LGA-12_2X2; MPN BMA456; DIGIKEY 828-1075-1-ND
U44: VEML6030; MPN VEML6030-GS15; DIGIKEY VEML6030-GS15CT-ND

Connections:
3V3_AUX: C38.1, C46.1, C47.1, C48.1, C57.1, U31.2 (CSB), U31.5 (SDO), U31.6 (VDDIO), U31.8 (VDD), U38.2 (MS/CS), U38.8 (VDD_IO), U38.15 (VDD), U43.3 (VCC), U43.7 (VCC), U43.10 (CSB), U44.4 (ADDR), U44.6 (VDD); also elsewhere on the board
GND: C38.2, C46.2, C47.2, C48.2, C57.2, U31.1 (GND), U31.7 (GND), U38.4 (NC), U38.9 (NC), U38.10 (NC), U38.11 (A1), U38.12 (A0), U38.13 (VSS), U38.14 (NC), U38.16 (NC), U38.EP (VSS), U43.1 (SDO), U43.8 (GND), U43.9 (GND), U44.1 (GND); also elsewhere on the board
SCL: U31.4 (SCK), U38.3 (SCL/SCLK), U43.12 (SCL), U44.5 (SCL); also elsewhere on the board
SDA_OB: U31.3 (SDI), U38.5 (SDA/MOSI), U43.2 (SDA), U44.2 (SDA); also elsewhere on the board

Notes on the sheet:
BMA456 accelerometer
VEML6030 light
ADR=0x77
On-Board Sensors
ADR = 0x48
MLX90393 magnetometer
BME280 environment
ADR=0x18
ADR=0x0C
