NorthernWidget/Project-Okapi/Hardware/KiCAD-10import/Okapi.kicad_pcb

## KiCad design Hardware/KiCAD-10import/Okapi.kicad_pcb (continued)

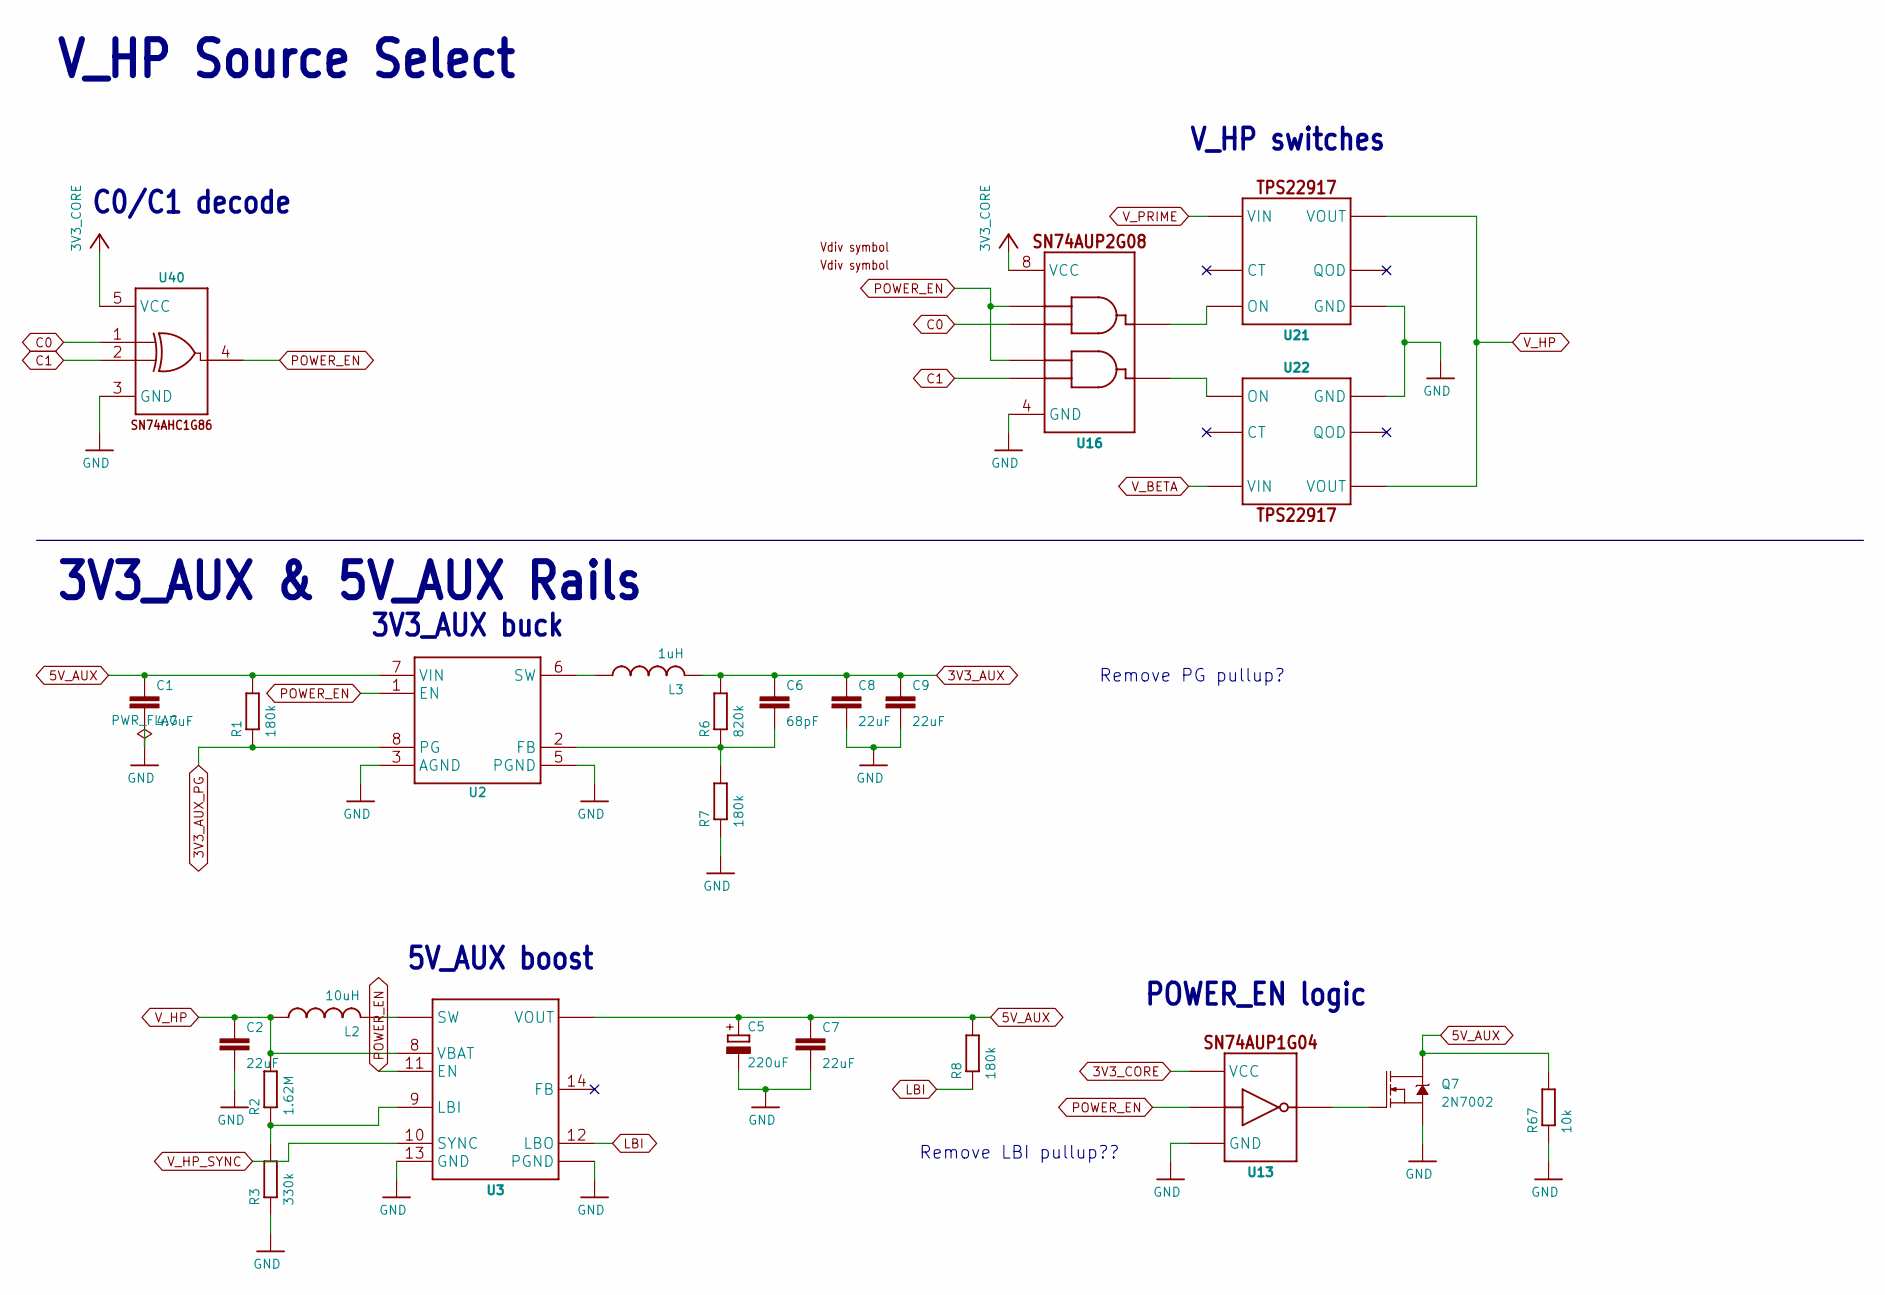
[picture p21: schematic Aux_Rails.kicad_sch]

Parts:
C1: 4.7uF; C0603; MPN GRM188Z71C475KE21D; DIGIKEY 490-GRM188Z71C475KE21DCT-ND
C2, C7, C8, C9: 22uF; C0805; MPN GRM219R61C226ME15L; DIGIKEY 490-9952-1-ND
C5: 220uF; C2917; MPN TPSY227K010R0100; DIGIKEY 478-5408-1-ND
C6: 68pF; C0402; MPN 885012005060; DIGIKEY 732-7474-1-ND
L2: 10uH; WE-XHMI(6.65X6.45); MPN 74439346100; DIGIKEY 732-10707-1-ND
L3: 1uH; WE-LQS(3X3); MPN 74404032010; DIGIKEY 732-5491-1-ND
Q7: 2N7002; SOT323; MPN 2N7002WT1G; DIGIKEY 2N7002WT1GOSCT-ND
R1, R7, R8: 180k; R0402; MPN RC0402FR-07180KL; DIGIKEY 311-180KLRCT-ND
R2: 1.62M; R0603; MPN CRCW06031M62FKEA; DIGIKEY 541-1.62MHCT-ND
R3: 330k; R0603; MPN ERJ-3EKF3303V; DIGIKEY P330KHCT-ND
R6: 820k; R0603; MPN RC0603FR-07820KL; DIGIKEY 311-820KHRCT-ND
R67: 10k; R0402; MPN RC0402FR-0710KL; DIGIKEY 311-10.0KLRCT-ND
U2: TPS6282DLC; DLC_8; MPN TPS62822DLCT; DIGIKEY 296-49512-1-ND
U3: TPS61032RSA; RSA_S-PVQFN-N16; MPN TPS61032RSAR; DIGIKEY 296-16662-1-ND
U13: SN74AUP1G04YFP; DSBGD_4; MPN SN74AUP1G04YFPR; DIGIKEY 296-25196-1-ND
U16: SN74AUP2G08DQE; DQE_R-PX2SON-N8; MPN SN74AUP2G08DQER; DIGIKEY 296-25638-1-ND
U21, U22: TPS22917DBV; DBV_R-PDSO-G6; MPN TPS22917DBVT; DIGIKEY 296-48370-1-ND
U40: SN74AHC1G86DCK; DCK_R-PDSO-G5; MPN SN74AHC1G86DCKR; DIGIKEY 296-8750-1-ND
U$1, U$2: VDIV-JP; VDIV_GENERIC

Connections:
3V3_AUX: C6.1, C8.1, C9.1, L3.P$2 (2), R6.2; also elsewhere on the board
3V3_AUX_PG: R1.1, U2.8 (PG); also elsewhere on the board
3V3_CORE: U13.A2 (VCC), U16.8 (VCC), U40.5 (VCC); also elsewhere on the board
5V_AUX: C1.1, C5.+, C7.1, Q7.3 (D), R1.2, R8.2, R67.2, U2.7 (VIN), U3.1 (VOUT), U3.15 (VOUT), U3.16 (VOUT); also elsewhere on the board
C0: U16.2 (B1), U40.1 (A); also elsewhere on the board
C1: U16.6 (B2), U40.2 (B); also elsewhere on the board
GND: C1.2, C2.2, C5.-, C7.2, C8.2, C9.2, Q7.2 (S), R3.1, R7.1, R67.1, U2.3 (AGND), U2.5 (PGND), U3.5 (PGND), U3.6 (PGND), U3.7 (PGND), U3.13 (GND), U3.PAD (PGND), U3.PAD@1 (PGND), U3.PAD@2 (PGND), U3.PAD@3 (PGND), U3.PAD@4 (PGND), U3.PAD@5 (PGND), U3.PAD@6 (PGND), U3.PAD@7 (PGND), U3.PAD@8 (PGND), U3.PAD@9 (PGND), U13.B1 (GND), U16.4 (GND), U21.2 (GND), U22.2 (GND), U40.3 (GND); also elsewhere on the board
LBI: R8.1, U3.12 (LBO); also elsewhere on the board
unnamed: L2.2, U3.3 (SW), U3.4 (SW)
unnamed: L3.P$1 (1), U2.6 (SW)
unnamed: Q7.1 (G), U13.B2 (Y)
unnamed: C6.2, R6.1, R7.2, U2.2 (FB)
unnamed: R2.1, R3.2, U3.9 (LBI)
unnamed: U16.7 (Y1), U21.3 (ON)
unnamed: U16.3 (Y2), U22.3 (ON)
POWER_EN: U2.1 (EN), U3.11 (EN), U13.A1 (A), U16.1 (A1), U16.5 (A2), U40.4 (Y)
V_BETA: U22.1 (VIN); also elsewhere on the board
V_HP: C2.1, L2.1, R2.2, U3.8 (VBAT), U21.6 (VOUT), U22.6 (VOUT)
V_HP_SYNC: U3.10 (SYNC); also elsewhere on the board
V_PRIME: U21.1 (VIN); also elsewhere on the board

Notes on the sheet:
Remove LBI pullup??
3V3_AUX & 5V_AUX Rails
POWER_EN logic
C0/C1 decode
Remove PG pullup?
V_HP switches
3V3_AUX buck
V_HP Source Select
5V_AUX boost

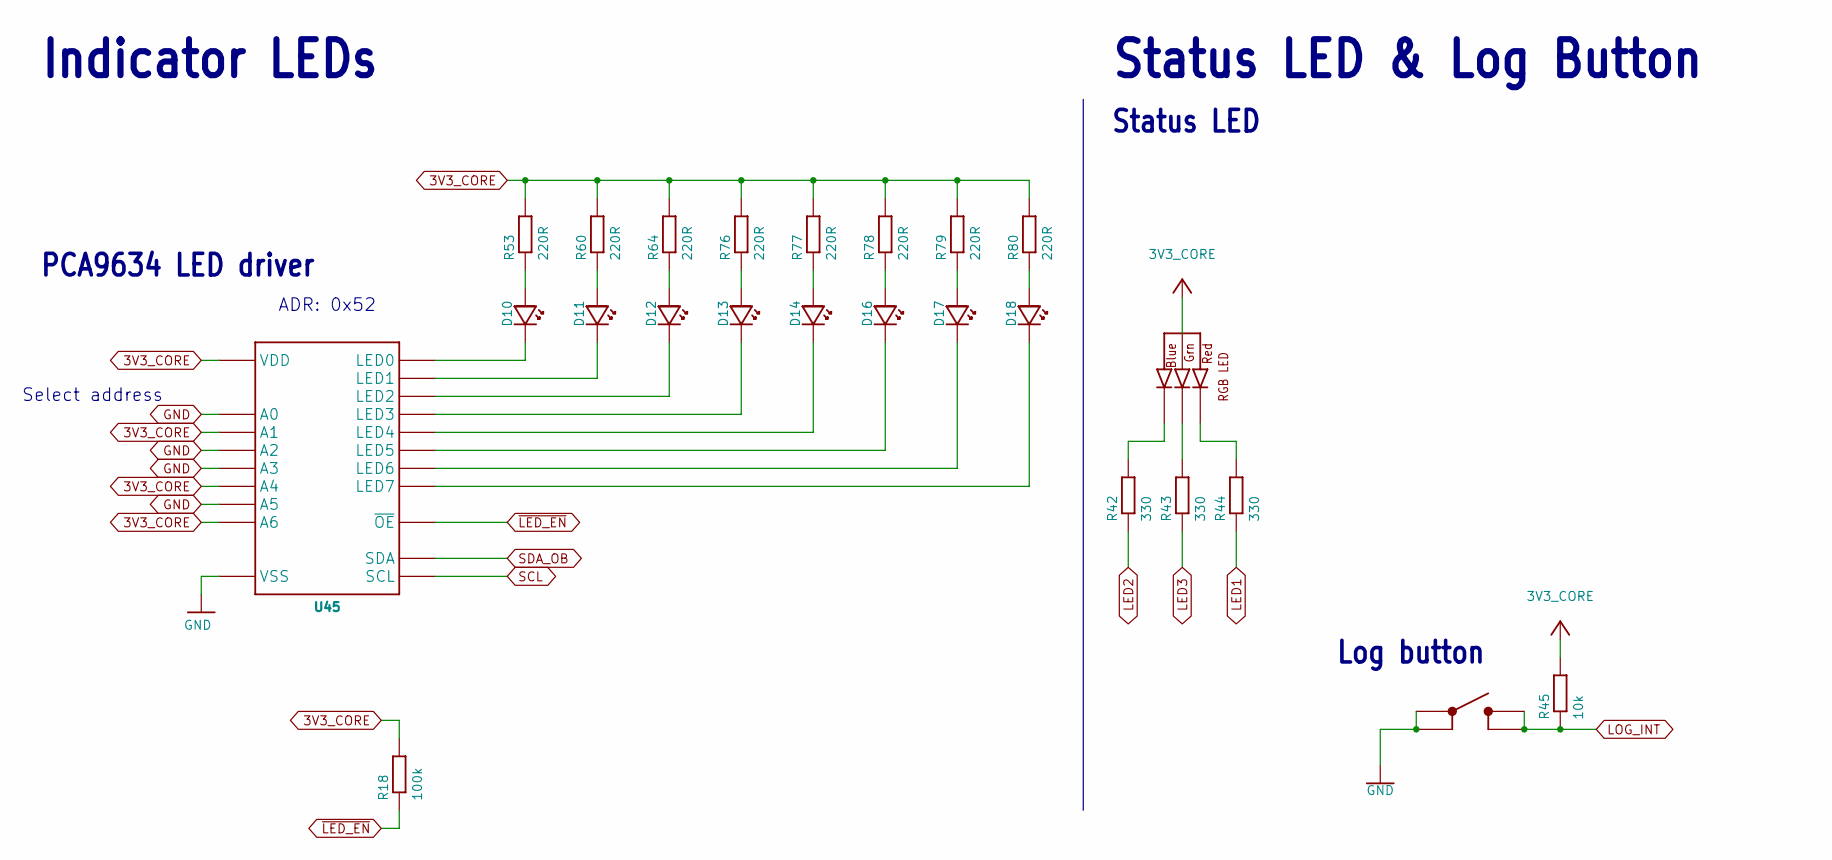
[picture p22: schematic Indicators.kicad_sch]

Parts:
D5: CLVBA-FKA; MPN CLVBA-FKA-CAEDH8BBB7A363; DIGIKEY CLVBA-FKA-CAEDH8BBB7A363CT-ND
D10, D13, D16: LEDGREEN0603; LED_0603; MPN 150060GS75000; DIGIKEY 732-4971-1-ND
D11, D14, D17: LEDYELLOW0603; LED_0603; MPN 150060YS75000; DIGIKEY 732-4981-1-ND
D12, D18: LEDRED0603; LED_0603; MPN 150060RS75000; DIGIKEY 732-4978-1-ND
R18: 100k; R0402; MPN RC0402FR-07100KL; DIGIKEY 311-100KLRCT-ND
R42, R43, R44: 330; R0402; MPN RC0402FR-07330RL; DIGIKEY 311-330LRCT-ND
R45: 10k; R0402; MPN RC0402FR-0710KL; DIGIKEY 311-10.0KLRCT-ND
R53, R60, R64, R76, R77, R78, R79, R80: 220R; R0402; MPN CRGCQ0402F220R; DIGIKEY A129619CT-ND
S3: BUTTON4.2X3.2; SWITCH_4.2X3.2; MPN PTS810 SJG 250 SMTR LFS; DIGIKEY CKN10504CT-ND
U45: PCA9634QFN; QFN20_5X5; MPN PCA9634BS,118; DIGIKEY 568-8717-1-ND

Connections:
3V3_CORE: D5.2 (ANODE), R18.2, R45.2, R53.2, R60.2, R64.2, R76.2, R77.2, R78.2, R79.2, R80.2, U45.3 (A4), U45.15 (A6), U45.18 (VDD), U45.20 (A1); also elsewhere on the board
GND: S3.1, S3.2, U45.1 (A2), U45.2 (A3), U45.8 (VSS), U45.14 (A5), U45.19 (A0), U45.EP (VSS); also elsewhere on the board
LED1: R44.1; also elsewhere on the board
LED2: R42.1; also elsewhere on the board
LED3: R43.1; also elsewhere on the board
LOG_INT: R45.1, S3.3 (4), S3.4 (3); also elsewhere on the board
unnamed: D5.3 (BLUE_CATH), R42.2
unnamed: D5.4 (GREEN_CATH), R43.2
unnamed: D5.1 (RED_CATH), R44.2
unnamed: D10.ANODE, R53.1
unnamed: D11.ANODE, R60.1
unnamed: D12.ANODE, R64.1
unnamed: D13.ANODE, R76.1
unnamed: D14.ANODE, R77.1
unnamed: D16.ANODE, R78.1
unnamed: D17.ANODE, R79.1
unnamed: D18.ANODE, R80.1
unnamed: D10.CATHODE, U45.4 (LED0)
unnamed: D11.CATHODE, U45.5 (LED1)
unnamed: D12.CATHODE, U45.6 (LED2)
unnamed: D13.CATHODE, U45.7 (LED3)
unnamed: D14.CATHODE, U45.9 (LED4)
unnamed: D16.CATHODE, U45.10 (LED5)
unnamed: D17.CATHODE, U45.11 (LED6)
unnamed: D18.CATHODE, U45.12 (LED7)
SCL: U45.16 (SCL); also elsewhere on the board
SDA_OB: U45.17 (SDA); also elsewhere on the board
~LED_EN: R18.1, U45.13 (~OE); also elsewhere on the board

Notes on the sheet:
Log button
PCA9634 LED driver
Status LED
ADR: 0x52
Status LED & Log Button
Indicator LEDs
Select address~{}

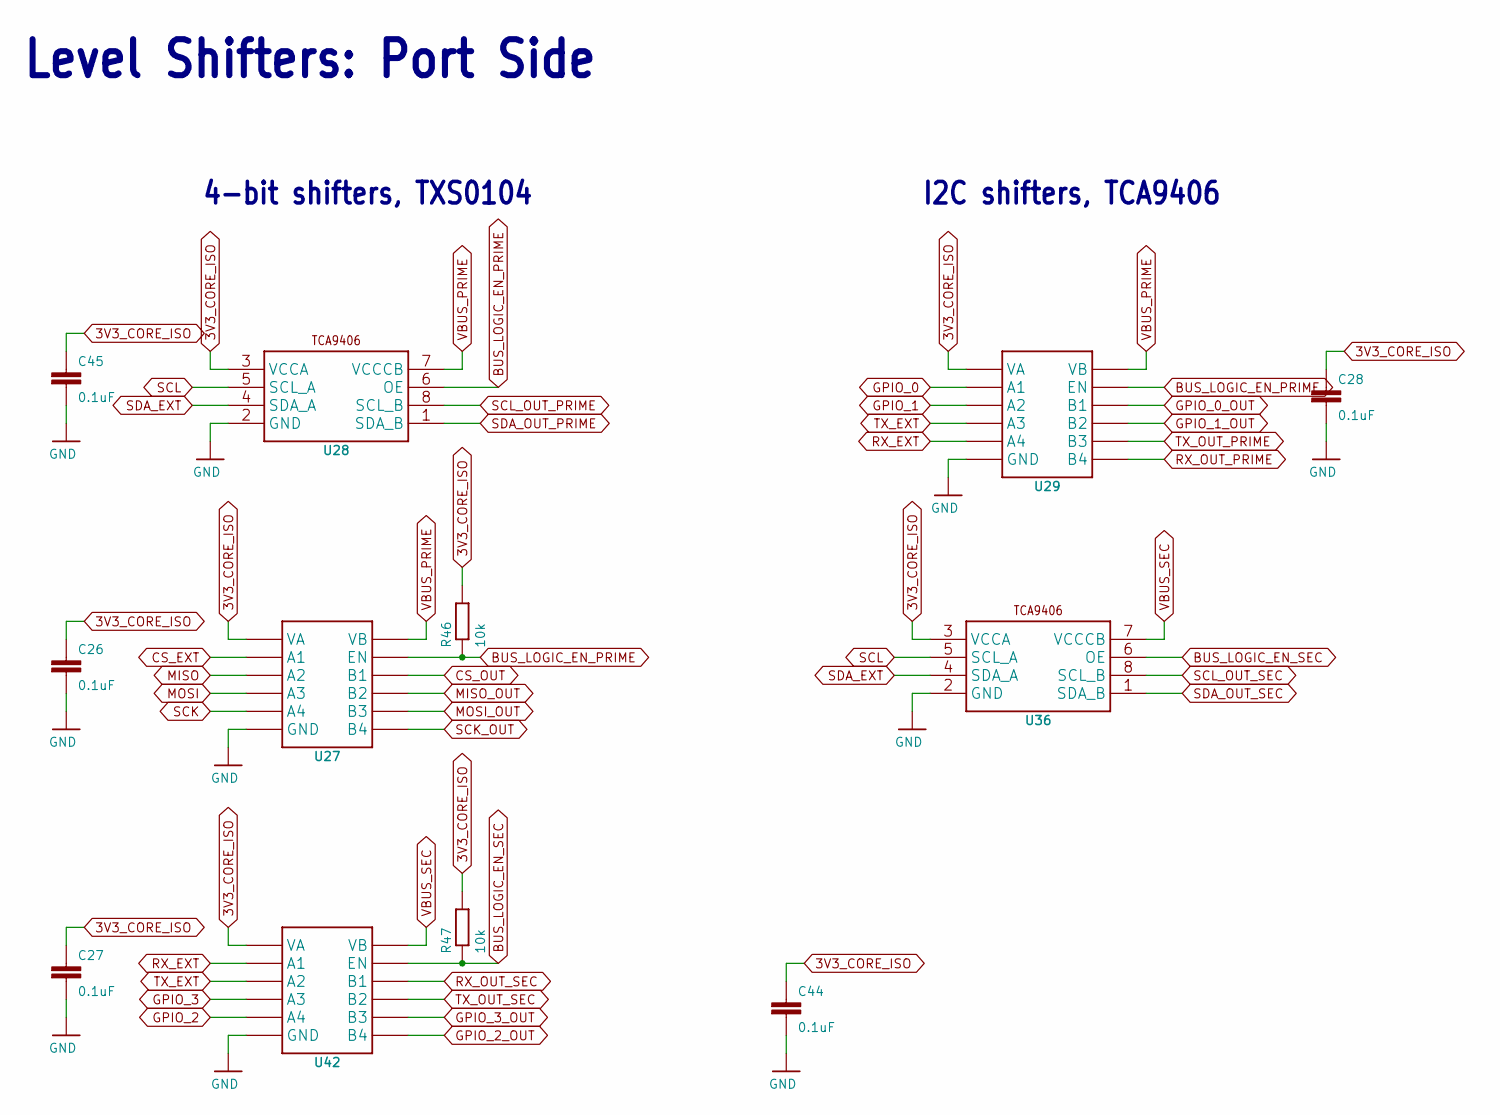
[picture p23: schematic Level_Shifters_Ports.kicad_sch]

Parts:
C26, C27, C28, C44, C45: 0.1uF; C0402; MPN GCM155R71C104KA55D; DIGIKEY 490-4759-1-ND
R46, R47: 10k; R0402; MPN RC0402FR-0710KL; DIGIKEY 311-10.0KLRCT-ND
U27, U29, U42: TXS0104RGY; RGY_S-PVQFN-N14; MPN TXS0104ERGYR; DIGIKEY 296-20698-1-ND
U28, U36: TCA9406DCU; DCU_(R-PDSO-G8); MPN TCA9406DCUR; DIGIKEY 296-28109-1-ND

Connections:
3V3_CORE_ISO: C26.1, C27.1, C28.1, C44.1, C45.1, R46.2, R47.2, U27.1 (VA), U28.3 (VCCA), U29.1 (VA), U36.3 (VCCA), U42.1 (VA); also elsewhere on the board
BUS_LOGIC_EN_PRIME: R46.1, U27.8 (EN), U28.6 (OE), U29.8 (EN); also elsewhere on the board
BUS_LOGIC_EN_SEC: R47.1, U36.6 (OE), U42.8 (EN); also elsewhere on the board
CS_EXT: U27.2 (A1); also elsewhere on the board
CS_OUT: U27.13 (B1); also elsewhere on the board
GND: C26.2, C27.2, C28.2, C44.2, C45.2, U27.7 (GND), U27.EP (GND), U28.2 (GND), U29.7 (GND), U29.EP (GND), U36.2 (GND), U42.7 (GND), U42.EP (GND); also elsewhere on the board
GPIO_0: U29.2 (A1); also elsewhere on the board
GPIO_0_OUT: U29.13 (B1); also elsewhere on the board
GPIO_1: U29.3 (A2); also elsewhere on the board
GPIO_1_OUT: U29.12 (B2); also elsewhere on the board
GPIO_2: U42.5 (A4); also elsewhere on the board
GPIO_2_OUT: U42.10 (B4); also elsewhere on the board
GPIO_3: U42.4 (A3); also elsewhere on the board
GPIO_3_OUT: U42.11 (B3); also elsewhere on the board
MISO: U27.3 (A2); also elsewhere on the board
MISO_OUT: U27.12 (B2); also elsewhere on the board
MOSI: U27.4 (A3); also elsewhere on the board
MOSI_OUT: U27.11 (B3); also elsewhere on the board
RX_EXT: U29.5 (A4), U42.2 (A1); also elsewhere on the board
RX_OUT_PRIME: U29.10 (B4); also elsewhere on the board
RX_OUT_SEC: U42.13 (B1); also elsewhere on the board
SCK: U27.5 (A4); also elsewhere on the board
SCK_OUT: U27.10 (B4); also elsewhere on the board
SCL: U28.5 (SCL_A), U36.5 (SCL_A); also elsewhere on the board
SCL_OUT_PRIME: U28.8 (SCL_B); also elsewhere on the board
SCL_OUT_SEC: U36.8 (SCL_B); also elsewhere on the board
SDA_EXT: U28.4 (SDA_A), U36.4 (SDA_A); also elsewhere on the board
SDA_OUT_PRIME: U28.1 (SDA_B); also elsewhere on the board
SDA_OUT_SEC: U36.1 (SDA_B); also elsewhere on the board
TX_EXT: U29.4 (A3), U42.3 (A2); also elsewhere on the board
TX_OUT_PRIME: U29.11 (B3); also elsewhere on the board
TX_OUT_SEC: U42.12 (B2); also elsewhere on the board
VBUS_PRIME: U27.14 (VB), U28.7 (VCCCB), U29.14 (VB); also elsewhere on the board
VBUS_SEC: U36.7 (VCCCB), U42.14 (VB); also elsewhere on the board

Notes on the sheet:
Level Shifters: Port Side
I2C shifters, TCA9406
4-bit shifters, TXS0104

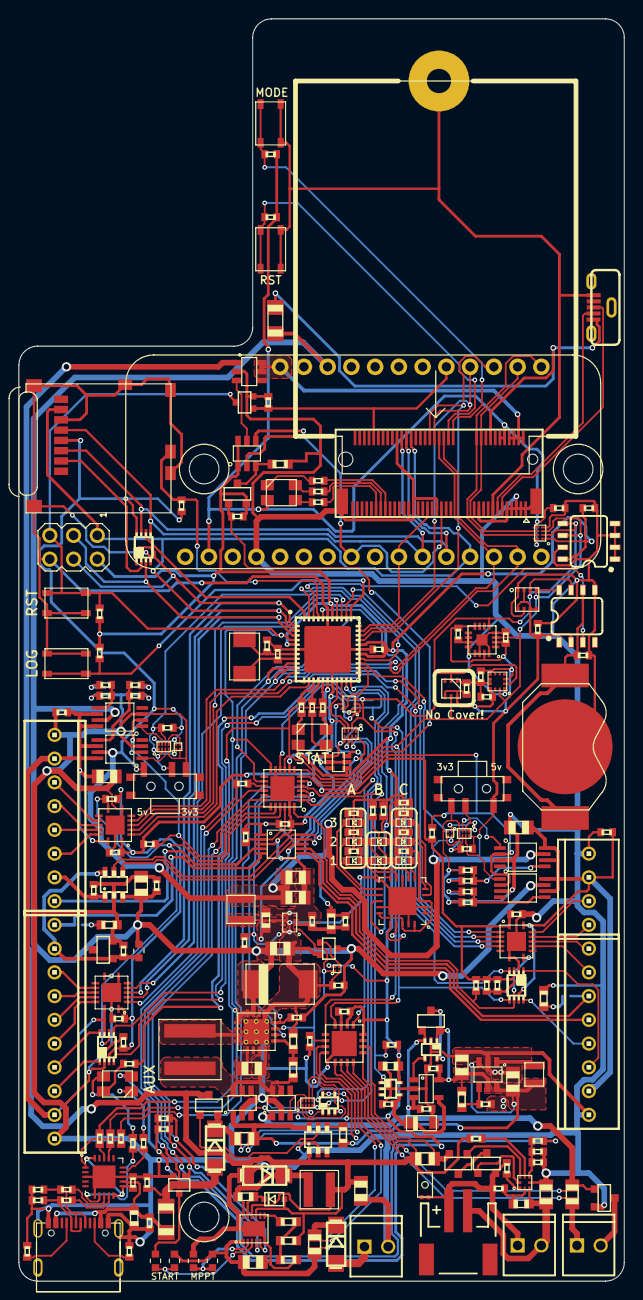
[picture p24: board Okapi.kicad_pcb from above]

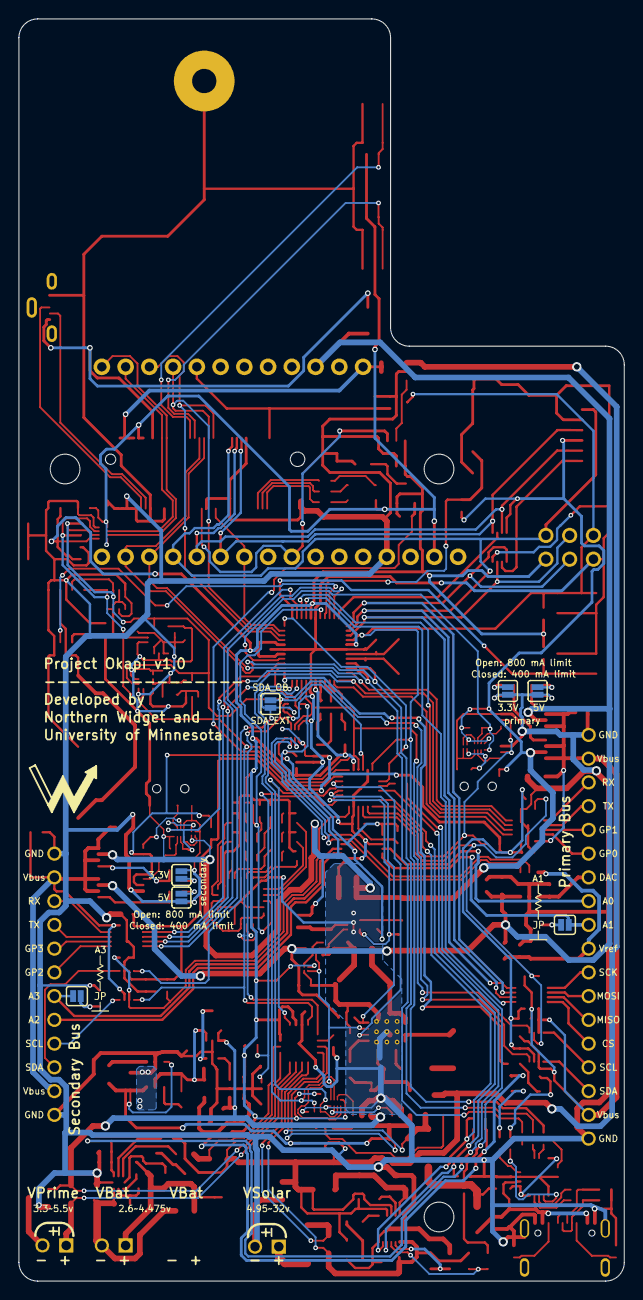
[picture p25: board Okapi.kicad_pcb from below]

Board: 2 copper layers, 64.8 x 135.0 mm, 250 parts (8 on the bottom side), 204 nets.
