NorthernWidget/Project-Okapi/(commit log)

2026-09-21 README: Page 1 follows the spec's universal Block 0; device data from 0x28; chip table
    Claude-Session: https://claude.ai/code/session_017NLdTS5Fho8nG3ih9RPxSQ
2026-09-23 README: link to the spec's Page 1 heading follows its new anchor (#page-1-sensor-data)
    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
2026-10-30 KiCAD-10import: restore the 60 global labels that the no-connect commit deleted on Okapi_3
    fb54477 meant to remove two stray labels (SIM_VCC, UB_VBUS) and add seven
    no-connects on J9; it removed 62 labels across the sheet and lost 54
    connections, fragmenting GND, 3V3_CORE, FEATHER_BAT, LOG_INT and
    V_PRIME_SENSE. This takes the sheet from faaf72e, removes only those two
    labels, and keeps the seven no-connects. Acceptance (kicad-cli netlist
    against Eagle's pinrefs, NW-Status/studies/okapi-hardware-audit/tools):
    168 of 209 Eagle nets exact at HEAD, 206 of 209 now, no Eagle pin missing;
    the three remaining differences are Eagle-side (U21/U22 QOD on the board
    only; D5's N$59/N$60 joined by KiCad'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
2026-10-30 KiCAD-10import: separate the status LED's green and red cathodes - move R43 under the green cathode
    In Eagle D5's cathodes are three nets: blue to R42 (N$58), green to R43
    (N$59), red to R44 (N$60). The importer placed R43 so that its top pin
    ended on the red cathode's pin end (220.98, 271.78), and a wire from the
    green cathode ended there too, so KiCad's geometric connectivity joined
    green, red, R43 and R44 as one net. R43 moves one grid step left to sit
    under the green cathode, with its lead and the LED3 label; the joining wire
    goes; the red cathode's own wire to R44 stays. Reference text nudged clear of
    R42's value. Acceptance: 208 of 209 Eagle nets exact (was 206); the one
    left is U21/U2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
2026-10-30 KiCAD-10import: tidy the status LED's wiring - one tick straight out, right angles, mirrored
    Andy, 2026-10-30. Each cathode leaves D5 straight down one grid tick; the
    middle continues straight to R43; the left turns left to R42 and the right
    mirrors it to R44, which moves to the mirror position (223.52); the three
    resistors drop two ticks to make the room, with their leads and the LED
    labels. The importer's diagonals and the jog above the blue pin are gone.
    Connectivity unchanged: 208 of 209 Eagle nets exact.
    Claude-Session: https://claude.ai/code/session_017F2gr2axqf8HWh46zhsQyY
2026-10-30 KiCAD-10import: leave the load switches' QOD pins and the SoM's SIM_VCC and UB_VBUS pins unconnected on both sides
    Andy, 2026-10-30. On sheet 2 the importer had put FEATHER_BAT labels on
    U21's and U22's QOD pin ends, which Eagle's schematic leaves open; they are
    no-connects now. On the board the four pads (U21-5, U22-5, J9-67, J9-74)
    carried nets with no tracks; their net assignments are cleared so the board
    agrees with the schematic. Acceptance: 209 of 209 Eagle nets exact (was 208).
    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
2026-11-01 KiCAD-10import: flip the status LED labels so their leads no longer run through the flags
    The three LED* global labels sat at angle 90 with left justification, which
    puts the flag body on the same side of the anchor as the lead from the
    resistor: each lead ran the full length of its flag. Angle 270 with right
    justification (KiCad stores a label's direction in both fields) hangs the
    flag below the anchor, where the lead ends at the upper tip and nothing
    crosses the text. Netlist unchanged: 209 of 209 Eagle nets reproduced.
    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
2026-11-01 KiCAD-10import: place the LED labels' hidden Intersheetrefs fields where KiCad autoplaces them at 270
    Rotating a label in the GUI re-autoplaces its hidden Intersheetrefs field to
    the far side of the flag. The hand edit left the field at the 90-degree
    position, 8.578 mm above the anchor; the other 270-degree labels on the
    sheet carry it below, at an offset that scales with font size (MISO at
    0.569 mm sits 3.895 mm below, the same ratio). Set the three to 8.578 mm
    below. The field is hidden, so nothing visible changes, and a round trip
    through kicad-cli sch upgrade now returns the sheet byte-identical.
    Claude-Session: https://claude.ai/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
2026-11-01 KiCAD-10import: end every wire at the label that names it (59 wires, all six sheets)
    The Eagle import drew each labeled net as a wire running past its label,
    with the label connected mid-wire and the far end hanging free. ERC flagged
    the 60 free ends; the net connectivity was never affected. 55 wires are
    shortened to end at the label's anchor and four (RX, SBU1, SBU2, 3V3_AUX at
    U25) whose label sits on the pin end are removed outright. Netlist 209 of 209
    Eagle nets, unchanged; ERC unconnected-wire-endpoint count 60 to 1; every
    sheet round-trips through KiCad byte-identically.
    Claude-Session: https://claude.ai/code/session_017F2gr2axq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
2026-11-01 KiCAD-10import: remove the 2 mm stub above the VUSB junction on sheet 2
    A wire ran 2.032 mm up from the VUSB junction at (312.42, 45.72) to nothing,
    an Eagle leftover and the last ERC unconnected endpoint. With it gone two
    wires meet at a corner there, so the junction dot goes too.
    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
2026-11-01 KiCAD-10import: put GND13 and GND14 on the grid
    Both ground symbols sat 0.254 mm right of the 1.27 mm grid, with their
    junctions and the ends of the two wires meeting each one. Each moves one
    quarter-tick left with its junction and wire ends. Netlist unchanged;
    ERC endpoint-off-grid 27 to 20.
    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
2026-11-01 KiCAD-10import: put Q3 on the grid
    The FDN360P symbol's origin sat 0.254 mm above the grid, taking its three pin
    ends with it. Q3 moves one quarter-tick down, with the gate wire, its
    junction, the FEATHER_EN label on that wire, and the ends of the source and
    drain wires. Netlist unchanged; ERC endpoint-off-grid 20 to 14, the
    remaining 14 all in the D4 LED block on sheet 2.
    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
2026-11-01 KiCAD-10import: redraw the D4 RGB LED block on the grid, as D5 was drawn
    The Eagle import left D4 and R37/R39 up to 0.508 mm off the grid, joined by
    three diagonal wires and with the anode reaching 3V3_CORE by a fourth: the
    last 14 ERC endpoint-off-grid warnings. D4 moves onto the grid one tick
    lower, the three resistors sit one column each above the cathodes (R36 blue,
    R37 green, R39 red, as wired before), and each lead runs one tick straight
    out, across, and straight in. The feeds keep their sources: CBUS2 to R36,
    CBUS1 to R39 along the top, ALIVE_LED to R37 from the right; CBUS3 stays
    unconnected as in Eagle. R37 and R39 references move up beside their leads
    so they no longer collide with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
2026-11-01 KiCAD-10import: space the D4 LED resistors 7.62 mm apart so each reference reads beside its own part
    At 5.08 mm the rotated reference of one resistor sat beside the next
    resistor's lead, and staggering the references up the column (d345b59)
    left it ambiguous which name belonged to which part. The three resistors
    now sit at 337.82, 345.44 and 353.06 with the LED moved one tick right
    to stay centered under the middle one; every reference is at the left
    of its resistor and every value at the right, all at one height. Leads
    keep the one-tick-out, right-angle form. Nets 209 of 209, round trip
    identical, ERC endpoints 0 and off-grid 0.
    Clau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
2026-11-01 KiCAD-10import: space the D5 LED resistors 7.62 mm apart, as D4
    Same ambiguity as D4: R43 and R44 were named above the column between
    two resistors. R42 and R44 move one tick outwards with their leads and
    the LED2 and LED1 labels below them; references go left and values
    right of each resistor at one height. Nets 209 of 209, round trip
    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
2026-11-01 KiCAD-10import: feed the D5 anode straight down from its 3V3_CORE supply symbol
    The import left the supply symbol one tick to the right of the anode
    pin and ran the wire diagonally between them. The symbol moves to the
    anode's column and the wire is vertical. Nets 209 of 209, round trip
    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
2026-11-02 KiCAD-10import: let KiCad 10.0.7 re-save the board, format only
    The June import wrote angles as -90 and numbers in another form; KiCad
    re-saves the file differently and then stably (a second re-save is
    identical). Checked identical before and after: 3897 segments, 345 vias,
    16 zones, 252 footprints, every pad's net, every net; DRC 1684 violations,
    17 unconnected items, parity 0. With the board in KiCad's own form, every
    later edit is a readable diff and the re-save test can gate it.
    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
2026-11-02 KiCAD-10import: every footprint reference points at the shared nw-cold-silicon library
    fp-lib-table names the library at ${KIPRJMOD}/../../../nw-cold-silicon.
    The 252 board footprints and the 251 placed symbols' Footprint fields are
    rewritten from Okapi:NAME to nw-cold-silicon:NAME by each element's Eagle
    package in Okapi.brd, the importer's _528 suffix on the two SMT jumpers
    dropped and SOT23-3@1 taken as SOT23-3; the sheets' embedded library
    defaults (99) and the project symbol library's (452) likewise, so ERC's
    library-mismatch check stays quiet. Footprint bodies are not yet replaced.
    ERC footprint-link warnings 251 to 0, total 398 to 147; nets 209 of 209;
    every sheet and the board re-sav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
2026-11-02 KiCAD-10import: pad-to-mask clearance 0.0635 mm, Eagle's 2.5 mil stop frame, as the board rule
    Eagle's design rules on the board set a 2.5 mil mask frame on every pad
    (mlMinStopFrame = mlMaxStopFrame = 2.5 mil); the import wrote that per pad
    and left the board rule at 0. The shared library carries no per-pad
    margins, so the board rule must say it. DRC: 1291 violations against 1292,
    the one difference a library-mismatch count; mask bridges 18 as before.
    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
2026-11-02 KiCAD-10import: every footprint body replaced by its nw-cold-silicon library footprint
    The 252 embedded copies from the June import give way to the library's
    pads and graphics, placed as before: positions kept, angles carried,
    back-side instances mirrored, every pad keeping its net. KiCad re-saved
    the result (twice, then stable). Unchanged: 3897 segments, 345 vias, 16
    zones, every pad's net and every net, 17 unconnected items, parity 281.
    The one pad change on the board is R48, from the old 1.0 by 1.1 mm 0603
    to the library's 1.0 by 1.0 (Andy, 2026-11-02: bschulz_passives' pads for
    every passive). DRC 1292 against 1291: one silkscreen overlap between
    ISP1's text and SD1's outline. Every inst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
2026-11-02 KiCAD-10import: bodies from the library's board-preferred LINX holder (BT1 keeps its silkscreen outline)
    Re-bodied again from nw-cold-silicon 8246fc2. No pad changed; BT1's outline,
    which the first re-body had taken from the board, is back. KiCad re-saved;
    pads, nets and footprints identical; DRC 1292, 17 unconnected, parity 281.
    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
2026-11-02 KiCAD-10import: every footprint linked to its symbol by path, with the symbol's value and fields
    What Update PCB from Schematic writes when re-linking by reference, from
    the netlist export: 251 footprints carry (path "/<symbol uuid>"), the sheet
    name and file, the symbol's value (the three LEDs had carried their
    reference as value) and the 61 BOM fields the symbols hold. U$4 has no
    symbol. Pad nets untouched; KiCad re-save identical. The parity check in
    kicad-cli still reports 172 "extra" footprints: the Eagle importer made
    the six sheets six top-level sheets (the project's top_level_sheets list,
    a KiCad 10 structure) and the DRC parity walks only the first; the netlist
    export walks all six,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
2026-11-02 KiCAD-10import: the board's nets carry the schematic's names
    106 Eagle-era net names (N$3, 5V_LP) become the names KiCad's netlist
    export gives the same pins (Net-(U2-FB), /Okapi_1/5V_LP), 933 references
    renamed, every board net matched to exactly one schematic net through its
    pads and none left over; 259 of 1080 pad entries change in name only.
    kicad-cli's parity check falls from 88 net conflicts to 22, all artifacts
    of its view of the first top-level sheet alone: the root-sheet nets it
    names without the sheet prefix, and the pins the schematic lists as
    unconnected-(...) where the board pad carries no net.
    Claude-Session: https://cla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
2026-11-02 KiCAD-10import: let KiCad re-save the root sheet, the two import leftovers gone
    The root sheet had differed by 21 lines from KiCad's own re-save since
    faaf72e: the V_CORE label out of sort order and a trailing embedded_fonts
    line. Every sheet now round-trips identical. Nets 209 of 209, ERC 147,
    unchanged. Its own commit, ahead of the hierarchy change that rewrites
    this file.
    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
2026-11-02 KiCAD-10import: one root sheet over six sub-sheets, in place of six top-level sheets
    The Eagle importer had made each Eagle sheet a KiCad 10 top-level sheet
    (top_level_sheets in Okapi.kicad_pro), which kicad-cli's netlist export and
    ERC walk whole and its DRC parity check walks one at a time. The former
    root becomes Okapi_1.kicad_sch; a new root Okapi.kicad_sch holds six sheet
    symbols named Okapi_1 to Okapi_6, three to a row on A4; the sub-sheets'
    stale instance records (each named its own old root) are dropped and KiCad
    rewrites them for the hierarchy. Net names keep the /Okapi_N/ prefix they
    had. Nets 209 of 209, ERC 147, all seven sheets re-save identical, 251
    components in the netlist ex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
2026-11-02 KiCAD-10import: footprints linked into the hierarchy, open pads carrying their schematic nets
    Paths are now /<sheet uuid>/<symbol uuid> for all 251 linked footprints.
    The 75 pads the board left without a net take the names the schematic
    gives open pins (unconnected-(REF-PIN-PadN)), as Update PCB from Schematic
    would, the six USB2 shell pads among them on the one net the KiCad
    schematic joins them to. Schematic parity: 1, the logo U$4, which has no
    symbol. DRC 1282 (1292 before: fewer hole-clearance and mask-bridge items
    between pads that now share a net), 20 unconnected items (17 before: the
    three ratsnest lines among the USB2 shell pads). KiCad re-save identical.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
2026-11-03 KiCAD-10import: the logo is a schematic part, LOGO1, from nw-cold-silicon
    NWLOGO_MED placed on Okapi_1 from the shared symbol library (the first
    symbol the project takes from it; sym-lib-table now names it), the board's
    U$4 renamed LOGO1 and linked to it, with the library's artwork attributes:
    excluded from the BOM and position files, no simulation, a description.
    Schematic parity 0. Nets 209 of 209, ERC 147, BOM 251 rows with no logo
    row, every sheet and the board re-save identical (Andy, 2026-11-03).
    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
2026-11-03 KiCAD-10import: 245 placed symbols take their definitions from nw-cold-silicon
    Every component whose library symbol has the same pin numbers and
    positions as the import's (symbol_map.py: 244 identical, plus FT231X-Q and
    ATMEGA1284M whose GND@1-style pin names the library writes as GND) now
    names nw-cold-silicon as its library, the sheets carry the library's
    definitions, and the import's definitions that nothing names any more are
    gone. Nothing moved: 209 of 209 Eagle nets, the netlist export the same
    pin for pin, every sheet re-saves identical. ERC 147 to 126: 21 of the
    22 unresolved ${DISP} texts were in the replaced definitions (the library
    carries DISP as a field). Left on Okapi-eagle-imp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
2026-11-03 KiCAD-10import: the last 131 symbols take their definitions from nw-cold-silicon, two rail symbols moved one tick
    The six parts the library lacked (BAT54C, the two USB connectors, the M.2
    connector, BMA456, MLX90393) and the 125 power symbols (100 and 7 on the
    importer's two GND variants, 5 on its GND, 9 3V3_AUX, 4 3V3_CORE) now name
    the library, which holds them as the six lifted symbols and three KiCad
    power symbols; every placed symbol is nw-cold-silicon's. One difference
    found by the checks and rewired: Okapi_3's embedded 3V3_CORE variant had
    its pin at the symbol origin where the library's sits one tick below, so
    #SUPPLY9 (the D5 anode feed) and #SUPPLY10 (R45) moved up one tick to keep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
2026-11-03 KiCAD-10import: the import's symbol library retired
    Nothing names Okapi-eagle-import any more: its last three embedded
    definitions (two VCC supply variants retired by faaf72e) go from the
    sheets, its line from sym-lib-table, and the file from the repository.
    The project's symbols are nw-cold-silicon's and the logo's. 209 of 209
    Eagle nets, ERC 112, every sheet re-saves identical.
    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
2026-11-03 KiCAD-10import: standard page sizes in place of the import's User sizes
    The Eagle import sized each page to its drawing. Each sheet now takes
    the smallest A size that holds its drawing inside the 10 mm margins and
    clear of the title-block corner:
    Okapi_1 432 x 191 mm A2
    Okapi_2 354 x 191 mm A3
    Okapi_3 326 x 310 mm A2
    Okapi_5 262 x 165 mm A4
    Okapi_6 218 x 104 mm A4
    Okapi_4 and the root were A4 already. Coordinates run from the top-left,
    so nothing moves; KiCad re-save identical on all seven sheets.
    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
2026-11-03 KiCAD-10import: title blocks on the seven sheets and the board, REV 1.0, 2024-11-02
    Okapi's Eagle schematic carried no frame, so these are new. REV 1.0
    follows the last commit to the Eagle schematic (b4032d4, "v1.0
    updates", 2024-11-02, which is also the date) and the README's
    "Okapi v1.0"; the drawing sheet prints both. KiCad re-save identical
    on all seven sheets and the board.
    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
2026-11-03 KiCAD-10import: the project draws nw-cold-silicon's sheet
    Both page-layout settings (schematic and board) point at
    ${KIPRJMOD}/../../../nw-cold-silicon/nw-cold-silicon.kicad_wks in place
    of the importer's empty.kicad_wks (which this directory never held, so
    KiCad was drawing its default sheet), and the text variables
    PROJECT = Okapi and DESIGNER = Bobby Schulz fill the title block.
    Verified with kicad-cli sch export pdf through the project file: all
    seven pages print Project, Designer, TITLE (sheet name), REV 1.0, Date
    2024-11-02, Sheet n/7 and the license line. Eagle nets 209 of 209,
    ERC 112, DRC 1282, 20 unconnected, 0 parity: all as before.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
2026-11-03 KiCAD-10import: default netclass at Eagle's 5 mil clearance (CHECKS-TODO DRC item 1)
    The project carried KiCad's 0.2 mm default where the board was routed
    to Eagle's jlcpcb-2layer rules (mdWireWire 5 mil = 0.127 mm, the value
    already in the rules' min_clearance). The netclass's via size follows
    the board's most used via (0.508 mm on a 0.254 drill, 194 of 340),
    since netclass sizes are the defaults for new routing, not checks.
    DRC: clearance 499 to 9, all nine between USB2's through-hole shell
    pads and tracks (item 7); 1282 to 783 in all; 20 unconnected and parity
    0 unchanged.
    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
2026-11-03 KiCAD-10import: silkscreen text rules at Bobby's sizes (CHECKS-TODO DRC item 2)
    KiCad's defaults (0.8 mm height, 0.08 mm thickness) flagged every
    reference text on the board, 199 of each. Bobby set them at 0.53 mm
    high and 0.078 mm thick (205 of 243), with a few at 0.51, 0.506 and
    0.42 mm, and the fabricated boards read fine, so the rules follow his
    sizes: minimum height 0.4 mm, minimum thickness 0.07 mm.
    DRC: text_height 199 to 0, text_thickness 199 to 0; 783 to 385 in all;
    20 unconnected and parity 0 unchanged.
    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
2026-11-03 KiCAD-10import: zones refilled and saved (CHECKS-TODO DRC item 3)
    The import left every zone unfilled. `kicad-cli pcb drc --refill-zones
    --save-board` fills the 16 zones and writes the board; KiCad re-saves
    the result identically and the pad-net table by (reference, pad) is
    unchanged.
    DRC: via_dangling 6 to 0, track_dangling 3 to 2, one isolated_copper
    warning appears (the fill island at 148.08, 128.78 mm that the audit
    knew, KICAD-TODO step 7); 385 to 379 in all. Unconnected items 20 to
    3: the 14 on GND, 2 on 5V_AUX and V_HP's track end join through the
    pours; the three left are USB2's shell pads (item 7). Parity 0.
    Claude-Session: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
2026-11-03 KiCAD-10import: SD1, U43 and S5 keepout zones placed under their parts (CHECKS-TODO DRC item 4)
    A footprint's zone polygon is written in board coordinates where its
    pads and graphics are local, and rebody.py had copied the library's
    polygons unmoved, so the three keepouts (SD1's two, U43's and S5's)
    sat near the board origin. Re-bodied with the corrected script, each
    zone's outline now equals the library footprint's as KiCad itself
    places it (checked vertex for vertex with the pcbnew module), and
    KiCad's own comparison reports the three as matching the library.
    The board is normalized through kicad-cli pcb upgrade; KiCad re-saves
    it identically and the pad-net table is unchanged.
    DRC: lib_f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
2026-11-03 KiCAD-10import: LOGO1 matches the library (DRC item 4 complete, no footprint mismatches)
    rebody.py had rounded coordinates to four decimals where KiCad writes
    six and compares exactly, so the mirrored logo on the back differed
    from the library by microns (1.992978 against 1.993). Re-bodied at
    full precision, with the library's description and its artwork
    attributes (exclude_from_bom, exclude_from_pos_files) on the instance.
    KiCad's own comparison reports every footprint on the board as
    matching the library; the board re-saves identically and the pad-net
    table is unchanged.
    DRC: lib_footprint_mismatch 1 to 0; 376 to 375; 3 unconnected,
    parity 0.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
2026-11-03 KiCAD-10import: RST_TRIG global, the SDA-jumper note on three lines (re-paging, step 1)
    RST_TRIG's three local labels become one global label, since the
    re-paging (NW-Status pages.md, layout H) puts the B-series module on
    one page and the log button and Q4 on another. The 86-character note
    "Jump SDA channels together, prevents using occupied addresses on the
    external I2C port" printed 105 mm wide and now wraps onto three lines.
    KiCad re-saves all seven sheets identically; Eagle nets 209 of 209;
    ERC 112, unchanged.
    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
2026-11-03 KiCAD-10import: Okapi_4, _5, _6 become Level_Shifters, Sensors, Microcontroller on Letter pages (step 2)
    The three sheets that stay whole take their names from what they hold
    (NW-Status pages.md, layout H): Okapi_4 the TXS/TCA level shifters,
    Okapi_5 the on-board sensors and RTC, Okapi_6 the ATmega1284 with its
    MCP23018. Each sheet symbol keeps its uuid, so the hierarchy paths and
    net names under them hold. Microcontroller's drawing moves 9 ticks
    left and Sensors' 5, onto the US Letter page; the root is US Letter
    too, its sheet symbols rewritten in page order, the three unsplit
    sheets last for now. KiCad re-saves all seven sheets identically;
    Eagle nets 209 of 209; ERC 112.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
2026-11-03 KiCAD-10import: Power_Input page (step 3)
    The power terminals J5 to J8 from Okapi_3 and, from Okapi_1, the start
    button, the BQ2980 protection with Q1/Q2 and the LT3652 charger with
    its solar chain, moved whole by grid ticks onto a US Letter page
    (sheet_lift.py, layout H in NW-Status pages.md). KiCad re-saves all
    eight sheets identically; Eagle nets 209 of 209; ERC 112.
    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
2026-11-03 KiCAD-10import: Core_Supply page (step 4)
    From Okapi_1: the MIC94094, the TLV61220 5V_LP boost, the TLV3691 and
    TPS2105 V_PRIME/V_CORE selection, the LTC4412 ideal diode with Q5, the
    TPS797 3V3_CORE LDO and Q6, with the logo. 5V_LP's four local labels
    land on this one page, so it stays local. KiCad re-saves all nine
    sheets identically; Eagle nets 209 of 209; ERC 112.
    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
2026-11-03 KiCAD-10import: Aux_Rails page (step 5)
    From Okapi_1: the TPS6282 3V3_AUX buck, the TPS61032 5V_AUX boost and
    the POWER_EN logic U13/Q7; from Okapi_2: the V_HP source switches U21
    and U22 with their U16/U40 logic and the VDIV jumpers, which Bobby drew
    under the port switches but which feed U3. Okapi_1 is now empty of
    parts. KiCad re-saves all ten sheets identically; Eagle nets 209 of
    209; ERC 112.
    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
2026-11-03 KiCAD-10import: Indicators page (step 6)
    From Okapi_3: the PCA9634 LED driver with its eight LEDs and the
    address ladder (R18's ~{LED_EN} pull-up and the "Select address" note
    with it), the D5 status LED and the S3 log button, under Bobby's own
    "Indicators" heading. KiCad re-saves all eleven sheets identically;
    Eagle nets 209 of 209; ERC 112.
    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
2026-11-03 KiCAD-10import: Cell_Module page (step 7)
    From Okapi_3: the Particle B-series module J9 with its micro-USB,
    fuse, reset and mode buttons, D7, the MB85RC FRAM and the microSD
    slot. Its RST_TRIG is the global label made in step 1. KiCad re-saves
    all twelve sheets identically; Eagle nets 209 of 209; ERC 112.
    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
2026-11-03 KiCAD-10import: Sensor_Ports page (step 8)
    From Okapi_2: the four MIC2544 current-limited switches with their
    jumpers, S1 and S2, and the AUP logic that drives them; from Okapi_3:
    the screw terminals J1 to J4 they feed. KiCad re-saves all thirteen
    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
2026-11-03 KiCAD-10import: USB_ISP_Feather page; the three import sheets are gone (step 9)
    From Okapi_2: USB-C J10, its fuse, the FT231X with D4; from Okapi_3:
    the ICSP header, the Feather socket MS1, JP5, Q4 and the mounting
    holes; from Okapi_1: the TPL5111 timer with JP8, Q3 and U10 that gates
    the socket's power. Bobby's heading on Okapi_2 read "USB & ISP".
    Okapi_1, Okapi_2 and Okapi_3 hold nothing now and go; the root lists
    the ten pages in signal-path order. KiCad re-saves all eleven sheets
    identically; Eagle nets 209 of 209; ERC 112.
    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
2026-11-03 KiCAD-10import: the board follows the ten pages (step 10)
    Every footprint re-linked to its symbol's path in the new hierarchy
    (link_paths.py, 252 of 252) and the 24 sheet-prefixed nets renamed to
    the schematic's (rename_nets.py, 303 pad references, 71 pads' net
    names changed); the pad-net partition, which pads share a net with
    which, is identical before and after. Normalized through kicad-cli pcb
    upgrade and re-saved identically by KiCad. DRC 375, 3 unconnected,
    schematic parity 0, as before the re-paging.
    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
2026-11-03 KiCAD-10import: the logo drawn in the Core_Supply page's top-right corner
    The same as Margay's: LOGO1 takes nw-cold-silicon's artwork (f6ed331),
    moves from Bobby's frame corner to (260.35, 12.7) in the empty
    top-right corner, and hides its reference and value. KiCad re-saves
    all eleven sheets identically; Eagle nets 209 of 209; ERC 112; DRC
    375, 3 unconnected, parity 0, unchanged.
    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
2026-11-03 KiCAD-10import: the three supply pages organized by section (Bobby's Margay style)
    Headings in the form of Bobby's Margay headings (5.08 mm bold), a
    divider between themes, blocks moved down by whole ticks to make room:
    Power_Input (terminals in their own column, with his "To Battery
    Connectors" note beside them), Core_Supply, Aux_Rails (V_HP source
    select above, the two rails below, his "Remove PG pullup?" note beside
    U2). KiCad re-saves every sheet identically; Eagle nets 209 of 209;
    ERC 112; every page's ink inside the border and clear of the title
    block. The plan is NW-Status tools/pages_tidy.py.
    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
2026-11-03 KiCAD-10import: Microcontroller page organized by section (one heading)
    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
2026-11-03 KiCAD-10import: Indicators page organized by section (two headings and a divider, the row moved down under them)
    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
2026-11-03 KiCAD-10import: Cell_Module page organized by section (two headings, the module and the SD card moved down under them)
    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
2026-11-03 KiCAD-10import: Level_Shifters page organized by section (one heading)
    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
2026-11-03 KiCAD-10import: Sensors page organized by section (one heading)
    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
2026-11-03 KiCAD-10import: Sensor_Ports page organized by section (two headings and a divider, the terminals moved right into their column)
    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
2026-11-03 KiCAD-10import: USB_ISP_Feather page organized by section (three headings and two dividers (USB, ISP and Feather, the Feather power timer), the ISP block moved right, the timer down, and the three mo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
2026-11-03 KiCAD-10import: the three mounting holes' value texts hidden
    H1 to H3 printed "MOUNTING_HOLE4_NP_CLOSE" over one another, 7.6 mm
    apart, as they did on Bobby's sheet. The values are hidden; the
    references stay. KiCad re-saves all eleven sheets identically; ERC 112.
    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
2026-11-03 KiCAD-10import: headings checked by their printed ink; four moved
    pages_headings_check.py renders each page with and without its
    headings and measures every heading's ink box, the other ink inside it
    and the gap to the ink below. Two headings touched their dividers
    (Aux_Rails' rails heading, the USB page's timer heading): each moved
    two ticks down with its block. Two sat far above what they label: the
    Microcontroller drawing moved up twenty ticks under its heading, and
    "Cellular Module" moved over the module itself. Every heading now has
    zero overlapping pixels. KiCad re-saves all eleven sheets identically;
    Eagle nets 209 of 209; ERC 112; every page inside the border.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
2026-11-03 KiCAD-10import: package-name values hidden (R-EU_*, DIODEDO-214AC, DIODESOD-323, the SMT jumper)
    Values Bobby never set print Eagle's device name, which told a reader
    nothing the Footprint field does not and sat on the labels he circled.
    Hidden on every page (this commit: Cell_Module, Sensors,
    USB_ISP_Feather; the next three carry the rest with their own edits).
    Part numbers that identify a part (DMG3404, LT3652DD, BAT54C, DS3231M
    and the rest) stay visible. KiCad re-saves every sheet identically.
    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
2026-11-03 KiCAD-10import: Power_Input per Andy's notes
    Three global labels whose flags lay over parts (V_LI_SENSE over R72,
    V_SOLAR_SENSE over R74, V_PRIME_SENSE over J5) now stand upright on
    their pins; D1's, R74's, R73's and D2's texts moved clear of their
    neighbors; the "Reverse Polarity Protection" note moved above its
    diode; six package-name values hidden. Eagle nets 209 of 209; ERC 112;
    re-save identical.
    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
2026-11-03 KiCAD-10import: Core_Supply per Andy's notes
    U37's V_PRIME label pointed into the comparator and now points away;
    D9's package-name value, which sat on V_BETA_SENSE, is hidden with
    R-EU's. Eagle nets 209 of 209; ERC 112; re-save identical.
    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
2026-11-03 KiCAD-10import: Aux_Rails per Andy's notes
    POWER_EN's flag lay across L2 and R2 at U3's input and now stands
    upright; the U13/Q7 POWER_EN logic moved from under U3 into the empty
    right half of the page, with its three labels and two grounds (the
    first attempt took U3's own ground along and the Eagle check caught
    it: 206 of 209, then 208, then 209). ERC 112; re-save identical.
    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
2026-11-03 KiCAD-10import: Microcontroller per Andy's notes
    IC1 with its pin notes moved six ticks right, the leads from the
    crystal, reset and decoupling cluster stretched to follow; DTR,
    3V3_CORE (VCC) and RST, whose flags lay over C39, the VCC pins and
    R52, now stand upright, AVCC's 3V3_CORE points away from the pin, and
    R52's value moved out of RST's way. The MCP23018 with its left-side
    labels, R68, the "ADD:" notes and the pull-up ladder it is wired to
    moved down and a little left as one block. Eagle nets 209 of 209;
    ERC 112; re-save identical.
    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
2026-11-03 KiCAD-10import: Indicators per Andy's notes
    The resistor and LED row moved six ticks right with U45's eight leads
    stretched, for lateral space at the address-select side; R18 moved
    down; the divider and the status LED and log button moved eight ticks
    right. Eagle nets 209 of 209; ERC 112; re-save identical.
    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
2026-11-03 KiCAD-10import: Microcontroller, the MCP23018 block six ticks higher, clear of the title block
    The ink check caught the pull-up ladder's labels in the title-block corner.
    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
2026-11-03 KiCAD-10import: Microcontroller re-applied from its pre-note state (the last commit had applied the plan twice)
    64fc8b2 re-ran the plan on a sheet that already carried it, which the
    gate (204 of 209, ERC 114) shows; this is the plan applied once to the
    sheet as it was before the notes, with the MCP23018 block 34 ticks
    down. Eagle nets 209 of 209; ERC 112; eleven sheets identical; every
    page inside the border and clear of the title block.
    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
2026-11-03 KiCAD-10import: Level_Shifters per Andy's notes (tools/pages_tidy.py stage 3)
    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
2026-11-03 KiCAD-10import: Sensors per Andy's notes (tools/pages_tidy.py stage 3)
    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
2026-11-03 KiCAD-10import: Cell_Module per Andy's notes (tools/pages_tidy.py stage 3)
    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
2026-11-03 KiCAD-10import: USB_ISP_Feather per Andy's notes (tools/pages_tidy.py stage 3)
    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
2026-11-03 KiCAD-10import: Sensor_Ports per Andy's notes (tools/pages_tidy.py stage 3)
    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
2026-11-03 KiCAD-10import: one font size per kind on every page (Andy: hold all font sizes constant)
    Labels 1.27 mm (KiCad's default; the importer had written 220 of
    them at 0.569 and others at 0.7112, 0.889, 1.016 and 1.2446), notes
    1.778 mm (Bobby's pin notes and most of his remarks were that size;
    the odd 0.8128, 2.1844 and 2.54 join them), Reference and Value
    fields 1.27 mm (half were 1.778). Headings (5.08) and circuit labels
    (3.048) as they were. 426 labels, 62 notes and 754 fields resized
    (tools/pages_tidy.py stage 4). Eagle nets 209 of 209; ERC 112;
    eleven sheets re-save identically. Four pages (Power_Input,
    Cell_Module, Sensors, USB_ISP_Feather) now run 1 to 3 mm past the left
    border where lef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
2026-11-03 KiCAD-10import: sixteen pages (Andy: expand rather than cram)
    Six pages give a block each to a new page, lifted whole by sheet_lift.py:
    Core_Supply -> Core_Power_Path (LTC4412 ideal diode, D9, Q5, Q6);
    Microcontroller -> GPIO_Expander (MCP23018, its notes, the pull-up
    ladder; GLOBAL_INT made a global label first, since it now spans the
    two); Level_Shifters -> Level_Shifters_Ports (the three TXS0104s and
    two TCA9406s with their caps); Sensors -> Analog_Clock_Power (DAC and
    reference, RTC, PAC1934, ADS1115); Sensor_Ports -> Sensor_Terminals
    (J1 to J4); USB_ISP_Feather -> Feather_ISP (JP5, the ICSP header, the
    Feather socket, Q4, and the TPL5111 timer). The dividers those blocks
    sat beside are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
2026-11-03 KiCAD-10import: the board follows the sixteen pages
    Footprints re-linked to their symbols' paths on the new sheets, the
    sheet-prefixed nets renamed, pad-net partition identical; normalized
    through kicad-cli pcb upgrade and re-saved identically. DRC 375, 3
    unconnected, parity 0.
    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
2026-11-03 KiCAD-10import: Power_Input, a label for each circuit (tools/pages_tidy.py stage 6)
    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
2026-11-03 KiCAD-10import: Core_Power_Path, a label for each circuit (tools/pages_tidy.py stage 6)
    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
2026-11-03 KiCAD-10import: Aux_Rails, a label for each circuit (tools/pages_tidy.py stage 6)
    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
2026-11-03 KiCAD-10import: Microcontroller, a label for each circuit (tools/pages_tidy.py stage 6)
    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
2026-11-03 KiCAD-10import: GPIO_Expander, a label for each circuit (tools/pages_tidy.py stage 6)
    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
2026-11-03 KiCAD-10import: Cell_Module, a label for each circuit (tools/pages_tidy.py stage 6)
    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
2026-11-03 KiCAD-10import: Level_Shifters, a label for each circuit (tools/pages_tidy.py stage 6)
    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
2026-11-03 KiCAD-10import: Level_Shifters_Ports, a label for each circuit (tools/pages_tidy.py stage 6)
    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
2026-11-03 KiCAD-10import: Sensors, a label for each circuit (tools/pages_tidy.py stage 6)
    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
2026-11-03 KiCAD-10import: Analog_Clock_Power, a label for each circuit (tools/pages_tidy.py stage 6)
    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
2026-11-03 KiCAD-10import: Sensor_Terminals, a label for each circuit (tools/pages_tidy.py stage 6)
    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
2026-11-03 KiCAD-10import: USB_ISP_Feather, a label for each circuit (tools/pages_tidy.py stage 6)
    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
2026-11-03 KiCAD-10import: Feather_ISP, a label for each circuit (tools/pages_tidy.py stage 6)
    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
2026-11-03 KiCAD-10import: the fifteen stage-6 commits undone, back to the sixteen-page state of e3f0de2
    The page-by-page run of stage 6 left the project at Eagle nets 200 of
    209 and ERC 146 (the gate was run after the loop, not per page, and
    the rehearsal had passed only because a failed block left its sheet
    untouched). Every sheet is the file committed at e3f0de2 again; the
    gate holds (seventeen identical, 209 of 209, ERC 112). The stage is
    re-applied correctly in the commits that follow.
    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
2026-11-03 KiCAD-10import: Core_Power_Path, a label for each circuit (tools/pages_tidy.py stage 6, the block rectangles corrected)
    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
2026-11-03 KiCAD-10import: Indicators, a label for each circuit (tools/pages_tidy.py stage 6)
    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
2026-11-03 KiCAD-10import: Core_Power_Path, a label for each circuit and the rows moved down together (tools/pages_tidy.py stage 6)
    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
2026-11-03 KiCAD-10import: Core_Supply, a label for each circuit and the lower rows moved down together (tools/pages_tidy.py stage 6)
    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
2026-11-03 KiCAD-10import: Power_Input, circuit labels raised to clear bands (tools/pages_tidy.py stage 7)
    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
2026-11-03 KiCAD-10import: Core_Supply, circuit labels raised to clear bands (tools/pages_tidy.py stage 7)
    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
2026-11-03 KiCAD-10import: Core_Power_Path, circuit labels raised to clear bands (tools/pages_tidy.py stage 7)
    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
2026-11-03 KiCAD-10import: Aux_Rails, circuit labels raised to clear bands (tools/pages_tidy.py stage 7)
    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
2026-11-03 KiCAD-10import: Microcontroller, circuit labels raised to clear bands (tools/pages_tidy.py stage 7)
    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
2026-11-03 KiCAD-10import: GPIO_Expander, circuit labels raised to clear bands (tools/pages_tidy.py stage 7)
    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
2026-11-03 KiCAD-10import: Cell_Module, circuit labels raised to clear bands (tools/pages_tidy.py stage 7)
    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
2026-11-03 KiCAD-10import: Level_Shifters, circuit labels raised to clear bands (tools/pages_tidy.py stage 7)
    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
2026-11-03 KiCAD-10import: Level_Shifters_Ports, circuit labels raised to clear bands (tools/pages_tidy.py stage 7)
    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
2026-11-03 KiCAD-10import: Sensors, circuit labels raised to clear bands (tools/pages_tidy.py stage 7)
    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
2026-11-03 KiCAD-10import: Analog_Clock_Power, circuit labels raised to clear bands (tools/pages_tidy.py stage 7)
    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
2026-11-03 KiCAD-10import: Sensor_Terminals, circuit labels raised to clear bands (tools/pages_tidy.py stage 7)
    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
2026-11-03 KiCAD-10import: USB_ISP_Feather, circuit labels raised to clear bands (tools/pages_tidy.py stage 7)
    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
2026-11-03 KiCAD-10import: Feather_ISP, circuit labels raised to clear bands (tools/pages_tidy.py stage 7)
    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
2026-11-03 KiCAD-10import: Core_Supply six ticks down under its heading, circuit labels raised again (stages 8 and 7)
    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
2026-11-03 KiCAD-10import: Core_Power_Path six ticks down under its heading, circuit labels raised again (stages 8 and 7)
    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
2026-11-03 KiCAD-10import: Aux_Rails six ticks down under its heading, circuit labels raised again (stages 8 and 7)
    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
2026-11-03 KiCAD-10import: Indicators six ticks down under its heading, circuit labels raised again (stages 8 and 7)
    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
2026-11-03 KiCAD-10import: Level_Shifters six ticks down under its heading, circuit labels raised again (stages 8 and 7)
    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
2026-11-03 KiCAD-10import: Level_Shifters_Ports six ticks down under its heading, circuit labels raised again (stages 8 and 7)
    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
2026-11-03 KiCAD-10import: Analog_Clock_Power six ticks down under its heading, circuit labels raised again (stages 8 and 7)
    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
2026-11-03 KiCAD-10import: Sensor_Terminals six ticks down under its heading, circuit labels raised again (stages 8 and 7)
    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
2026-11-03 KiCAD-10import: Feather_ISP six ticks down under its heading, circuit labels raised again (stages 8 and 7)
    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
2026-11-03 KiCAD-10import: Power_Input, circuit labels raised again (stage 7)
    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
2026-11-03 KiCAD-10import: GPIO_Expander, circuit labels raised again (stage 7)
    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
2026-11-03 KiCAD-10import: Aux_Rails, circuit labels placed by raster search, below a part when nothing is clear above (stage 7)
    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
2026-11-03 KiCAD-10import: Level_Shifters, circuit labels placed by raster search, below a part when nothing is clear above (stage 7)
    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
2026-11-03 KiCAD-10import: Level_Shifters_Ports, circuit labels placed by raster search, below a part when nothing is clear above (stage 7)
    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
2026-11-03 KiCAD-10import: Sensor_Terminals, circuit labels placed by raster search, below a part when nothing is clear above (stage 7)
    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
2026-11-03 KiCAD-10import: Analog_Clock_Power, circuit labels placed by raster search, below a part when nothing is clear above (stage 7)
    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
2026-11-03 KiCAD-10import: Core_Supply, circuit labels placed by raster search, below a part when nothing is clear above (stage 7)
    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
2026-11-03 KiCAD-10import: Core_Power_Path, circuit labels placed by raster search, below a part when nothing is clear above (stage 7)
    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
2026-11-03 KiCAD-10import: Feather_ISP, circuit labels placed by raster search, below a part when nothing is clear above (stage 7)
    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
2026-11-03 KiCAD-10import: Cell_Module, circuit labels placed by raster search, below a part when nothing is clear above (stage 7)
    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
2026-11-03 KiCAD-10import: Sensors, circuit labels placed by raster search, below a part when nothing is clear above (stage 7)
    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
2026-11-03 KiCAD-10import: USB_ISP_Feather, circuit labels placed by raster search, below a part when nothing is clear above (stage 7)
    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
2026-11-03 KiCAD-10import: Microcontroller, circuit labels placed by raster search, below a part when nothing is clear above (stage 7)
    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
2026-11-03 KiCAD-10import: GPIO_Expander, circuit labels placed by raster search, below a part when nothing is clear above (stage 7)
    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
2026-11-03 KiCAD-10import: Power_Input, circuit labels placed by raster search, below a part when nothing is clear above (stage 7)
    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
2026-11-03 KiCAD-10import: the six circuit labels the search could not seat, set by hand (stage 9)
    Level_Shifters_Ports: each chip's label beside it, with its reference,
    since the stacked columns leave no band above or below. Indicators: the
    status LED block six ticks down from under its heading, its label above
    it, the LED driver's label at the top left of its column.
    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
2026-11-03 KiCAD-10import: the ports page labelled per column, Indicators' last nudges (stage 10)
    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
2026-11-03 KiCAD-10import: Indicators, the status LED label two ticks above its block
    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
2026-11-03 KiCAD-10import: Indicators, the status heading and label clear of the divider line
    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
2026-11-03 KiCAD-10import: 27 global labels turned or slid off the wires and parts they printed over
    pages_collisions.py renders each page with and without its annotations
    and names every label whose flag has ink under it (47 of 30 pixels or
    more, on ten pages); pages_fix_labels.py tries each one at its anchor
    and at the far end of its wire, at the four angles, and keeps the
    placement with the least ink under it. 27 moved; three that slid to
    their pin end left a bare stub, deleted. Eagle nets 209 of 209; ERC
    112; seventeen sheets identical.
    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
2026-11-03 KiCAD-10import: the SD card off the page edge, C32 out from under the RTC's labels, the pull-up ladder clear of U41, J2's leads straightened (stage 11)
    Andy's third-round spots: the SD block five ticks left; the RTC's
    capacitor eight ticks left with its leads stretched, so the two labels
    no longer print over it; the MCP23018's pull-up ladder eight ticks
    down with three leads stretched; the eight diagonal label leads on
    the terminals page replaced by four-tick horizontal stubs with each
    label at the far end. Eagle nets 209 of 209; ERC 112; seventeen
    sheets identical.
    Claude-Session: https://claude.ai/code/session_017F2gr2axqf8HWh46zhsQ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
2026-11-03 KiCAD-10import: every page's ink inside the 4 mm edge rule (stage 12)
    The two page dividers that ran to the paper edge are trimmed to the
    printable area (Aux_Rails across the page, Power_Input down to the
    title block). The terminals block on Power_Input moves 16 ticks left
    into the middle of its column and the TPL5111 timer block on
    Feather_ISP eight ticks left, which takes their right-hand labels
    inside the border. Then each page is shifted by the whole ticks its
    own printed ink needs: Power_Input, Microcontroller 2; Aux_Rails 1;
    GPIO_Expander 4; USB_ISP_Feather, Feather_ISP 3. Eagle nets 209 of
    209; ERC 112; seventeen sheets identical; no page over the rule.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
2026-11-03 KiCAD-10import: circuit labels centered over their parts and re-seated, BOM fields and terminal package names hidden (stage 13)
    Andy's third round, the general causes: a circuit label sat at a typed
    offset from its part, which left "Battery / USB sense" over empty
    space and "Pull-ups" under the chip's notes. Each label now starts
    centered on its part and the band search slides the column by whole
    ticks either side when a vertical wire blocks it, taking the seat
    nearest the part (a slid column costs three times its slide), above
    the part before below it. The pull-up ladder and the SPI buffer block
    move down six ticks to open a band for their labels; the three
    terminal labels stand beside thei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
2026-11-03 KiCAD-10import: nine labels and five notes moved off what they printed over (second fixer pass)
    pages_fix_labels.py, now judging each candidate against the whole page
    without that one annotation and with two new moves: a label pushed two
    or four ticks out along its wire with the wire lengthened (MISO and
    3V3_CORE on the ICSP header, BUS_LOGIC_EN_PRIME and _SEC on the port
    shifters, ADC_3 on the ADS1115, 3V3_CORE on the ATmega), and a note
    nudged by ticks (Select address on Indicators up six ticks clear of the
    address-pin labels, ADR = 0x48, Also ext PWM, and the three terminal
    labels). Left as they are, the best candidate still over ink: RST on
    R52 (30 px), GPIO_1_OUT beside a capacitor's fi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
2026-11-03 KiCAD-10import: the three terminal labels at one x, ten mm clear of the connectors
    Stage 13 had set each four ticks closer than its connector's pin
    stubs and the fixer then nudged each by a different amount. One x for
    the group (the longest label sets it), so V_PRIME, Battery and Solar
    line up. Eagle nets 209 of 209; ERC 112; seventeen sheets identical.
    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
2026-11-03 KiCAD-10import: blocks spaced evenly and grouped on eleven pages (stage 14)
    Andy, 2026-11-04: uniform spacing, no crowding, grouping by function.
    Twenty whole-block moves by ticks from the measured ink boxes: the
    solar charger 10 mm down from the battery protection block it touched;
    Core Supply's three blocks at even gaps; the battery switch beside the
    ideal diode; the ATmega 30 mm right with its clock and reset given
    10 mm of room; the core-side level shifters in two columns; C44 back
    beside the third TXS0104; the on-board sensors and the analog page in
    2x2 grids; J1 to J4 in one row at a 66 mm pitch with their labels
    re-seated above; the ICSP header under the power timer and the Feather
    so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
2026-11-03 KiCAD-10import: four labels turned or pushed out after the block moves, the terminal labels aligned (third fixer pass)
    3V3_CORE on C42 pushed four ticks out with a stub wire added (the
    anchor was also the pin end, so moving the wire's end had cut the
    net; the fixer now adds a wire instead), GND on the SPI buffer and
    RTC_INT and MISO turned at their anchors, and V_PRIME, Battery and
    Solar at one x 14 mm clear of their connectors. Collisions at 30 px
    or more after the block moves: 14, now the least-ink residue. Eagle
    nets 209 of 209; ERC 112; seventeen sheets identical.
    Claude-Session: https://claude.ai/code/session_017F2gr2axqf8HWh46zh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
2026-11-03 KiCAD-10import: dividers below the heading band, circuit labels re-seated with two ticks of air (stage 15)
    After the block moves pages_headings_check.py found five labels and
    one heading resting on the ink under them (Terminals on its divider,
    Pull-ups, Feather UART, ATmega1284, BME280 environment). Every
    divider now starts at y 17.78, under the heading band, and every
    circuit label is re-seated with a 7 mm clear band and two ticks of
    air; 3V3_AUX buck on the fullest page keeps its seat by hand. 77
    headings and labels, 0 with overlapping ink. Eagle nets 209 of 209;
    ERC 112; seventeen sheets identical.
    Claude-Session: https://claude.ai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
2026-11-03 KiCAD-10import: ISP & Feather follows Cellular Module in the page order (stage 16)
    Andy, 2026-11-04: the two pages are two ways to host a Particle
    module, the B-series SoM on the M.2 E-key socket (Eagle's "Particle B
    Series SoM") and a Boron on the Feather socket, so they sit next to
    each other as pages 9 and 10; the rest keep their order. Only the
    root's sheet positions and page numbers change. Eagle nets 209 of
    209; ERC 112; seventeen sheets identical.
    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
2026-11-03 KiCAD-10import: the pages ordered by relevance (stage 17)
    Power first, in the order the current flows: input, the path that
    picks the source for the core, the core rails, the aux rails. Then
    the brain with its programming and serial port (USB was last), the
    on-board peripherals (indicators; analog, clock and power monitor;
    sensors), the two Particle hosts, and the chain out to the sensor
    terminals (core-side shifters, port-side shifters, switched port
    power, terminals). Shared signal nets between neighboring pages sum
    to 45 against 42 before; only the root changes. Eagle nets 209 of
    Claude-Ses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
2026-11-03 KiCAD-10import: a no-connect flag on each of the 61 pins open in Eagle as well (CHECKS-TODO ERC item 4)
    Placed from ERC's own report (pin_not_connected, the pin's connection
    point) by erc_noconnects.py: J9's 27 unused M.2 pins, the Feather
    socket's 12, the FT231X's handshake and CBUS pins, SD1's DAT1 and
    DAT2, USB2's ID and shell, J8's two pads, U38's three, RTC1's 32KHZ
    and RST, U41's INTB and GPA2, U44's INT, U3's FB, U4's NTC, the three
    load switches' CT. USB2's shell net on the board takes the name the
    schematic now gives it. ERC 112 to 46 (pin_not_connected 61 to 0,
    pin_not_driven 6 to 1); DRC 375, unconnected 3, parity 0, as before;
    Eagle nets 209 of 209; seventeen sheets identical.
    C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
2026-11-03 KiCAD-10import: SBU1 and SBU2 on the USB-C are no-connects, not single-pin labels (CHECKS-TODO ERC item 3, two of three)
    Eagle carried the two sideband pins as named single-pin nets; here
    each label goes and a no-connect flag sits on the pin end, and the
    board pads A8 and B8 take the unconnected names the schematic gives
    them. SENSOR_INT on the BMA456's interrupt pin is left for Andy's
    word. ERC 46 to 44; DRC 375, unconnected 3, parity 0; Eagle nets 209
    of 209; seventeen sheets identical.
    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
2026-11-04 KiCAD-10import: the TPL5111's DRVn pin is an output on the Feather page (CHECKS-TODO ERC item 5)
    The sheet's copy of nw-cold-silicon's TPL5111DDC refreshed after the
    library retyped the pin (nw-cold-silicon, build rule PIN_TYPES). The
    placed instance is untouched. ERC 44 to 43; Eagle nets 209 of 209;
    seventeen sheets identical.
    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
2026-11-04 KiCAD-10import: S5's keepout is Eagle's bRestrict, no copper on B.Cu (KICAD-TODO step 6)
    Re-bodied from nw-cold-silicon 71c5983 and the zones refilled. The
    import had carried the switch's restrict as a keepout on both copper
    layers with tracks, pads and pours allowed; it is now the bottom layer
    with nothing allowed, as Bobby drew it. DRC reports two tracks under
    it that the Eagle board carried too, V_PRIME and V_PRIME_SENSE on
    B.Cu at (161.9, 162.9) mm: 375 to 377, unconnected 3, parity 0; the
    board re-saves identically.
    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
2026-11-04 KiCAD-10import: the regulators' outputs drive their rails (CHECKS-TODO ERC item 6, first part)
    Sheet copies of TLV61220DBV, TPS210, TPS797 and MIC9409C6 (Core
    Supply), TPS6103RSA and TPS22917DBV (Aux Rails), TPS22917DBV (ISP &
    Feather) and MIC2544MSOP (Switched Port Power) refreshed from
    nw-cold-silicon e4361e1. power_pin_not_driven 42 to 33; twelve
    pin_to_pin warnings appear, seven of them against pins the import
    typed bidirectional or open collector on diodes, transistors, a fuse
    and two inputs (next), five between two switches that feed one rail
    by design (V_HP, VBUS_PRIME, VBUS_SEC). ERC 43 to 46 on the way to
    fewer; Eagle nets 209 of 209; seventeen sheets identical.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
2026-11-04 KiCAD-10import: diodes, LEDs, MOSFETs and fuses carry passive pins; ADDR and VDD_IO typed by datasheet (ERC item 6, second part)
    Nine symbols' sheet copies refreshed from nw-cold-silicon a4a1038 on
    eight pages. power_pin_not_driven 33 to 17 (the nine LEDs' anodes and
    cathodes and D6 no longer count as undriven supplies), pin_to_pin 12
    to 5 (the five left are two switches feeding one rail by design).
    ERC 46 to 23; Eagle nets 209 of 209; seventeen sheets identical.
    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
2026-11-04 KiCAD-10import: charger, USB bridge, sensor, switch and connector pins typed by datasheet (ERC item 6, third part)
    Eight symbols' sheet copies refreshed from nw-cold-silicon b9d62b8 on
    seven pages. ERC stays at 23 (17 undriven rails, 5 two-switch
    warnings, SENSOR_INT); what changed is latent: before this, every
    PWR_FLAG placed on those rails drew 25 bidirectional-against-output
    warnings from the import's typing. Eagle nets 209 of 209; seventeen
    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
2026-11-04 KiCAD-10import: a PWR_FLAG where each rail enters the schematic (ERC item 6, last mechanical part)
    Fourteen flags placed from ERC's own report by pwr_flags.py, each on
    the pin where a rail comes in from a connector, a battery, a passive
    part or a power symbol: VREF, the RTC's cell, GND, the B-SoM's 3V3
    and VBUS, the LDO's input through D8, V_PRIME, V_BETA, the BQ2980's
    BAT, VDD and VSS, the charger's VIN, 3V3_AUX and the USB-C's VBUS.
    ERC 23 to 9: the three converter switch nodes and the five two-switch
    warnings on the decisions list, and SENSOR_INT. Eagle nets 209 of 209;
    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
2026-11-04 KiCAD-10import: the ISP header's pins passive (sheet copy from nw-cold-silicon 8a54c2b)
    ERC 9 as before; Eagle nets 209 of 209; seventeen sheets identical.
    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
2026-11-04 KiCAD-10import: U3's nine thermal vias at the ring Eagle fabricated (CHECKS-TODO DRC item 5)
    Re-bodied from nw-cold-silicon e747648, where every through-hole pad
    is grown to Eagle's restring: the nine 0.3048 mm pads on 0.254 mm
    drills become 0.508 mm, the size the boards were made with. No other
    pad on the board changed. Zones refilled. annular_width 9 to 0; DRC
    377 to 368 (one USB2 shell item moved from shorting to clearance, the
    same copper); unconnected 3, parity 0; the board re-saves identically.
    Andy, 2026-11-04: match the way the Eagle boards printed.
    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
2026-11-04 KiCAD: board checks as the Eagle boards were fabricated: silkscreen checks off, Eagle's hole-to-hole and copper-to-edge
    Andy, 2026-11-04: match the way the Eagle boards printed. Bobby's CAM
    Gerbers carry the reference designators over pads and outlines and the
    connector outlines over the board edge, and the fab clips silk over
    copper, so silk_over_copper, silk_overlap, silk_edge_clearance and the
    two text-size checks are set to ignore. Hole-to-hole becomes Eagle's
    mdDrill (6 mil, 0.1524 mm) and copper-to-edge Eagle's mdCopperDimension
    (15 mil, 0.381 mm), which every Northern Widget DRU sets; neither
    finds a new item, so the boards were routed to them.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
2026-11-04 KiCAD-10import: J10's pads against its own holes accepted as fabricated (DRC rule)
    The USB-C package's non-plated holes sit 0.18 mm from its VBUS and GND
    pads; the rule names the part and the measured gap. hole_clearance 4
    to 0 for J10; DRC 33 to 29.
    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
2026-11-04 KiCAD-10import: the micro-USB shell as Eagle built it, three slots, each one unconnected pad (CHECKS-TODO DRC item 7)
    USB2 re-bodied from nw-cold-silicon 38f98b3: each slot's two holes
    share a pad number with the copper bar folded into the pad, and the
    symbol carries three BODY pins, each with a no-connect flag, as
    Eagle's netlist left the shell unconnected. The board's shell pads
    take the schematic's three unconnected nets; the footprint allows
    bridged mask apertures, as the fabricated shell has. The shell's
    rules leave the rule file; J10's stays. DRC 29 to 5 (the two tracks
    under S5's restrict, two dangling track ends and the floating GND
    island, all as fabricated), unconnected 3 to 0, par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
2026-11-05 KiCad: BT1's two + springs are one terminal, from nw-cold-silicon
    Symbol refreshed to one + pin, the footprint re-bodied with both pads
    numbered POWER0 and duplicate_pad_numbers_are_jumpers yes, the net
    KiCad now names Net-(BT1-+). Gate unchanged: 17 sheets and the board
    identical, ERC 9, DRC 5 / 0 / parity 0; the Eagle comparison reads
    208 of 209 because Eagle's BT1 has a POWER1 pin and KiCad's has one pin
    for both springs.
    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
2026-11-05 README: the sensor port current limits, 1 A per port and 1.5 A by jumper, and why
    The MIC2544 ILIM values as built (232 Ω, 453 Ω in parallel through JP1 to
    JP4) and the reason the default is not the maximum: the 5 V rail is one
    boost that also carries the telemetry module's transmit bursts. Andy,
    2026-11-05: "This would be the reason. Document it."
    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
2026-11-05 README: the 66-minute timer, what it does and what the firmware does not yet do with it
    The TPL5111 as the telemetry module's power timer: the interval from
    R20, the floor, the hang bound, the logger's restart through FEATHER_EN,
    DONE from the module, and the state of the firmware on 2026-11-05.
    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
2026-11-05 README: the timer's hourly wake is the module's receive window, stated as its purpose
    Andy, 2026-11-05: keep it waking to be able to receive information as needed.
    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
2026-11-05 README: the regulator feedback dividers, and why the TPS62822's stays above the datasheet's center
    Both dividers follow their datasheets; the TPS62822's trades a halving of
    FB-node sensitivity for 9 µW at light load. Andy, 2026-11-05: keep as is,
    document why.
    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
2026-11-05 KiCad: the BMA456's INT pin is a no-connect; the accelerometer reports orientation on demand
    Andy, 2026-11-05: U43 will be read for the board's orientation when
    wanted, not run continuously or for impulses, so its interrupt output is
    unused. The SENSOR_INT label and its stub go; the pad takes KiCad's
    unconnected net. ERC 9 to 8; DRC 5 / 0 / parity 0; 17 sheets and the
    board identical; the Eagle comparison lists U43 pin 5 among the
    unconnected pins by design.
    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
2026-11-06 README: Power metering, what the PAC1934 and its shunts can see and what they cost
    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
2026-11-06 README: Reference voltage on the sensor port, what J2's VREF pin supplies and R48's dual-size pads (Okapi #36)
    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
2026-11-06 docs: v0.7 pre-build checks for the first v0.7.0 boards
    What to confirm on a board that has never been built: ILIM resistors, the
    330 Ω size, C40 to C42, R19, R48 and VREF, R51 and the PAC1934 address,
    the four shunts, the MPPT pair, and Q7. Expected values only; no as-built
    value exists yet.
    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
2026-11-06 KiCad: symbols carry Eagle's BOM fields (MF, MPN, DIGIKEY, DISP)
    From NW-Tests kicad/eagle_fields.py: 667 fields added on 16 sheets (MPN 211,
    DIGIKEY 215, MF 219, DISP 22), insert-only. D8's part number was under a
    misspelled attribute, MFP, in Eagle's bschulz BAT54C device; it is BAT54CLT1G,
    the onsemi part its DIGIKEY code BAT54CLT1GOSCT-ND names, pins 1 and 2 anodes
    and 3 the common cathode as the device connects them, and is written as MPN.
    BoM export: 251 rows, MPN on 235, every field equal to Eagle's. Checks:
    Eagle nets 208 of 209, round-trip 17 of 17 identical, ERC 8.
    Claude-Session: https://claude.ai/code/session_017F2gr2axqf8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
2026-11-06 KiCad: footprints carry their symbols' BOM fields
    NW-Tests kicad/link_paths.py --values --fields from the netlist export, as
    Update PCB from Schematic writes them: 667 fields on 252 footprints,
    insert-only. Schematic parity 199 to 0; pad-net table identical; board
    round-trip identical; DRC 5 / 0 unconnected.
    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
2026-11-06 KiCad: R26 to R29 value 232 Ω, as their part number (MIC2544 ILIM, 1 A)
    The value field said 287R since the 2024 design; the part number was always RC0402FR-07232RL. 230 V / 232 Ω = 0.99 A (DS20005725B Eq. 5-1; A2, 2026-11-06). Checks unchanged: nets 208 of 209, 17 of 17 sheets and the board identical, ERC 8, DRC 5 / 0 / parity 0.
    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
2026-11-06 KiCad: R30 to R33 464 Ω (RC0402FR-07464RL, 311-464LRCT-ND)
    The second ILIM resistor of each port switch, closed in by JP1 to JP4. The built 453 Ω put 232 ∥ 453 = 153.4 Ω below the MIC2544's 154 Ω floor; 232 ∥ 464 = 154.7 Ω, 1.49 A nominal (A2, Andy 2026-11-06). The value field said 287R. Digi-Key code read from Digi-Key's listing. Checks: nets 208 of 209, 17 of 17 sheets and the board identical, ERC 8, DRC 5 / 0 / parity 0, pad-nets identical.
    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
2026-11-06 KiCad: the eight 330 Ω 0402s take the 0402 part number (RC0402FR-07330RL)
    R36 to R40 and R42 to R44 sat on 0402 pads with RC0603FR-07330RL, an 0603 part, as Margay's R7/R9 did; R37 and R39 also carried the 0603 Digi-Key code 311-330HRCT-ND. All eight now match R9: RC0402FR-07330RL, 311-330LRCT-ND, one line of nine. Checks: nets 208 of 209, 17 of 17 sheets and the board identical, ERC 8, DRC 5 / 0 / parity 0, pad-nets identical.
    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
2026-11-06 KiCad: R19 100 kΩ, joining the 100 k line (FEATHER_EN pull-up)
    From 120 kΩ (RC0402FR-07120KL), the board's only 120 k; no specification binds the pull-up on Q3's gate (A4, decided 2026-11-05). RC0402FR-07100KL, 311-100KLRCT-ND, as R18. Checks: nets 208 of 209, 17 of 17 sheets and the board identical, ERC 8, DRC 5 / 0 / parity 0, pad-nets identical.
    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
2026-11-06 KiCad: R54, R84 to R87 value fields from their part numbers
    The five carried the device name R-EU_R0402 as their value: R54, R86, R87 are RC0402FR-0710KL (10k), R84, R85 RC0402FR-075K1L (5.1k, the USB-C CC pull-downs). Checks: nets 208 of 209, 17 of 17 sheets and the board identical, ERC 8, DRC 5 / 0 / parity 0, pad-nets identical.
    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
2026-11-06 KiCad: R45, R52 take the 0402 Digi-Key code of the 10 kΩ line
    Both carried 311-10.0KHRCT-ND, Digi-Key's code for the 0603 RC0603FR-0710KL, against their own 0402 MPN RC0402FR-0710KL; the other ten 10 kΩ parts carry 311-10.0KLRCT-ND. One code now, as the planned table asks. Checks: nets 208 of 209, 17 of 17 sheets and the board identical, ERC 8, DRC 5 / 0 / parity 0, pad-nets identical.
    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
2026-11-06 KiCad: R51 0 Ω, the PAC1934 at address 0x10 (RC0402JR-070RL)
    ADDRSEL to ground through R51 selects 0x10 (DS20005850B Table 5-1), free on the on-board segment; pacFind() scans 0x10 to 0x1F (A3, decided 2026-11-05). R51 had no value or number. Digi-Key 311-0.0JRCT-ND, read from its listing. Checks: nets 208 of 209, 17 of 17 sheets and the board identical, ERC 8, DRC 5 / 0 / parity 0, pad-nets identical.
    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
2026-11-06 KiCad: R72, R73, R75 20 mΩ shunts (ERJ-6BWFR020V, 0.5 W)
    The PAC1934's V_LI, V_PRIME and V_BETA channels, which had no value: 100 mV full scale at 5 A, LSB 76 µA unidirectional, 0.18 W at a 3 A burst on the 0.5 W ERJ-6BW series (A3, decided 2026-11-05; DS20005850B). Digi-Key P.02AQCT-ND as recorded in A3. Checks: nets 208 of 209, 17 of 17 sheets and the board identical, ERC 8, DRC 5 / 0 / parity 0, pad-nets identical.
    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
2026-11-06 KiCad: R74 50 mΩ shunt on V_SOLAR_IN (ERJ-6BWFR050V, 0.5 W)
    The PAC1934's charge-input channel: 2 A full scale, LSB 31 µA, 0.11 W at 1.5 A (A3, decided 2026-11-05). The same part as #32's charger sense resistor, which B8 adds. Digi-Key P17581CT-ND, read from its listing. Checks: nets 208 of 209, 17 of 17 sheets and the board identical, ERC 8, DRC 5 / 0 / parity 0, pad-nets identical.
    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
2026-11-06 KiCad: R48 1 kΩ 0402 (RC0402FR-071KL), the reference bias; its pads stay 0603 until #36
    From 330 Ω 0603: (5 - 2.5) V / 1 kΩ = 2.5 mA, about 2 mA on VREF for a load, 6 mW (A4, Andy 2026-11-06), on R12's line. The part number is 0402 while the footprint is still R0603; #36 (B8) gives R48 the dual 0603/0402 pads, so the slip is temporary and B8 removes it. Checks: nets 208 of 209, 17 of 17 sheets and the board identical, ERC 8, DRC 5 / 0 / parity 0, pad-nets identical.
    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
2026-11-06 KiCad: Q7 is the onsemi 2N7002WT1G, the 5V_AUX switch that does not latch (#7)
    The 2N7002W-7-F used in the late-2019 run turned off too slowly and could hold 5V_AUX on, about 100 mA from the backup battery; Bobby Schulz found the 2N7002WT1G fixes it (#7). Same SOT-323 footprint. Q4 and Q8 keep the 2N7002W-7-F; whether they change too is a question for Andy. Digi-Key 2N7002WT1GOSCT-ND, read from its listing. Checks: nets 208 of 209, 17 of 17 sheets and the board identical, ERC 8, DRC 5 / 0 / parity 0, pad-nets identical.
    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
2026-11-06 KiCad: C11, C13 manufacturer spelled Taiyo Yuden
    The Eagle attribute read Yaiyo Yuden, the same slip Margay's C13 and C14 carried until rc.2; the part number TMK107B7105KA-T is Taiyo Yuden's. Checks: nets 208 of 209, 17 of 17 sheets and the board identical, ERC 8, DRC 5 / 0 / parity 0, pad-nets identical.
    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
2026-11-06 README: the port jumper puts 464 Ω beside 232 Ω, inside the MIC2544's 154 Ω floor
    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
2026-11-06 KiCad: MS1 off the BoM (the Feather footprint; the Particle board is fitted by the user)
    MS1 is the FEATHERWING footprint for the Particle Feather form factor; like the B-SoM, the module and its headers are not assembly parts (Andy, 2026-11-06). Symbol in_bom no; footprint exclude_from_bom from link_paths. Checks: nets 208 of 209, 17 of 17 sheets and the board identical, ERC 8, DRC 5 / 0 / parity 0, pad-nets identical.
    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
2026-11-06 KiCad: Q4 and Q8 take the 2N7002WT1G as Q7 does, one line for the three
    Q4 pulls RST low for the Particle (0.33 mA against R52), Q8 switches R70 on the charger's !SHDN divider (microamps); both have 3.3 V gate drive, which the onsemi part covers with its 2.5 V maximum threshold, and its 150 nA gate leakage costs Q8 at most 0.15 V across R55 (1 MΩ). One BoM line and the part Bobby Schulz tested on this board (#7; Andy, 2026-11-06). Checks: nets 208 of 209, 17 of 17 sheets and the board identical, ERC 8, DRC 5 / 0 / parity 0, pad-nets identical.
    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
2026-11-06 KiCad: C42 is an 0402 1 µF part (Samsung CL05A105KA5NQNC) on its 0402 pad
    C42 decouples AVCC and AREF on 3V3_CORE. It carried CL10B105MO8NNWC, a CL10 (0603) part, on an 0402 pad (#28 item 3). CL05A105KA5NQNC: 0402, 1 µF, 25 V X5R, active, 1276-1445-1-ND, read from Digi-Key's listing (A4, Andy 2026-11-06). Checks: nets 208 of 209, 17 of 17 sheets and the board identical, ERC 8, DRC 5 / 0 / parity 0, pad-nets identical.
    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
2026-11-06 KiCad: C18 is the Murata GRM188Z71C475KE21D, 4.7 µF 16 V X7R 0603
    From GRM188R61C475KAAJD (X5R). C18 (3V3_CORE) and C1 (5V_AUX) take one X7R 16 V part (A4, decided 2026-11-05; the pick Andy's, 2026-11-06); C1 follows with its footprint. 490-GRM188Z71C475KE21DCT-ND, active, read from Digi-Key's listing; stock not shown there, 17-week lead, to recheck before an order. Checks: nets 208 of 209, 17 of 17 sheets and the board identical, ERC 8, DRC 5 / 0 / parity 0, pad-nets identical.
    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
2026-11-06 KiCad: C1 to 0603 on C18's part, one 4.7 µF line (GRM188Z71C475KE21D)
    C1 (5V_AUX, beside the TPS61032) was a Kemet 0805 X7R; it takes C18's Murata 0603 16 V X7R (A4, decided 2026-11-05). Footprint C0805 to C0603 from nw-cold-silicon with rebody.py: pads 1.3 x 1.5 mm at ±0.95 become 1.0 x 1.0 at ±0.85, and every track end still lands on its pad (DRC unconnected 0, with and without a zone refill). Checks: nets 208 of 209, 17 of 17 sheets and the board identical, ERC 8, DRC 5 / 0 / parity 0, pad-nets identical.
    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
2026-11-06 KiCad: XTAL1 is the ECS-80-12-30-JGN-TR; the TXC 7A-8.000MAAE-T is obsolete
    Digi-Key lists the TXC part as obsolete. ECS ECX-53 series, 8 MHz, 12 pF load as before, ±20 ppm tolerance, ±30 ppm stability, 100 Ω ESR, 5.0 x 3.2 mm two-pad, -40 to +85 °C (suffix N; Andy asked for at least that range), active, 50-ECS-80-12-30-JGN-CT-ND. Its sibling JGM, Digi-Key's direct substitute, is -20 to +70 °C. The terminals (1.3 x 2.0 mm, 2.4 mm gap) lie inside the existing pads (1.7 x 2.4 mm at ±1.85 mm); no footprint change. Checks: nets 208 of 209, 17 of 17 sheets and the board identical, ERC 8, DRC 5 / 0 / parity 0, pad-nets identical.
    Claud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
2026-11-06 KiCad: C40, C41 take the TDK 12 pF C0G of C23/C24 (crystal load, 0402)
    They carried CL10C120JB8NNNC, a Samsung 0603 (CL10) number, on 0402 pads. 12 pF on the ECS-80-12-30-JGN (12 pF load): inside the ATmega1284P's 12 to 22 pF range, at its cold-start end, slightly under nominal load (the clock runs tens of ppm fast; UART tolerance is about 2 %); one part for every small capacitor on Okapi and Margay (Andy, 2026-11-06). #18 moves from its 18 pF premise: the crystal was always a 12 pF part. Checks: nets 208 of 209, 17 of 17 sheets and the board identical, ERC 8, DRC 5 / 0 / parity 0, pad-nets identical.
    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
2026-11-06 KiCad: R5, R7 to 0402 on the 180 kΩ line (RC0402FR-07180KL); zones refilled
    The feedback legs of U1 (TLV61220) and U2 (TPS62822), the last pending row of the resistor table (Andy, 2026-11-06: no downside, go). Same tolerance and tempco (1 %, ±100 ppm/°C) as the Panasonic ERJ-3EKF1803V they replace, so the set points do not move. Footprint R0603 to R0402 with rebody.py; R7's new pad sat 0.110 mm from the stale GND fill on F.Cu (rule 0.127), so the zones were refilled and saved: every changed fill point lies within 138.3 to 148.3 mm x, 128.4 to 138.3 mm y, around R7 and C1, whose fill this also updates after its own footprint change. Checks: nets 208 of 209, 17 of 17 sheets and the board id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
2026-11-06 KiCad: R6 is a 1 % part (RC0603FR-07820KL), for a tighter 3V3_AUX
    The top of the TPS62822's divider was RC0603JR-07820KL, 5 %, against R7's 1 %. With both at 1 % the divider's worst-case share of the 3V3_AUX error falls from 4.92 % to 1.64 % (R6 / (R6 + R7) times the summed tolerances); Andy asked for the higher precision, 2026-11-06. Same value and 0603 footprint; 311-820KHRCT-ND, active, 51,726 on Digi-Key. Checks: nets 208 of 209, 17 of 17 sheets and the board identical, ERC 8, DRC 5 / 0 / parity 0, pad-nets identical.
    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
2026-11-07 KiCad: C22 on USB VBUS to 4.7 µF X7R 0603 (GRM188Z71C475KE21D), FTDI's value
    C22 (10 µF 0805 X5R) plus C21 (0.1 µF) put 10.1 µF nominal on VBUS, at or over USB's 10 µF limit for a device (from memory). FTDI's UMFT231XA puts 4.7 µF + 0.1 µF on the FT231X's VCC, which takes VBUS; the logger's own load from USB draws through F1 and D9 from V_BETA's capacitors, not from C22. The part is C1 and C18's, so no new line (Andy, 2026-11-07). Footprint C0805 to C0603 with rebody.py; no zone reaches C22 (refill changed no fill). Checks: nets 208 of 209, 17 of 17 sheets and the board identical, ERC 8, DRC 5 / 0 / parity 0, pad-nets identical.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
2026-11-07 KiCad: C33 on the DAC output to 68 pF (Würth 885012005060, C6's part)
    The MCP4726's VOUT "can drive up to 100 pF of capacitive load" and its electrical specifications assume CL = 100 pF (DS22272C §4.4.6); C33 was 0.1 µF with no series resistor, 1000 times that. 68 pF is inside the stated load and is C6's part, so no new line (Andy, 2026-11-08). Same 0402 footprint. Checks: nets 208 of 209, 17 of 17 sheets and the board identical, ERC 8, DRC 5 / 0 / parity 0, pad-nets identical.
    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
2026-11-07 KiCad: R9 (BQ298000 VDD filter) to 220 Ω, inside the 300 Ω maximum
    SLUSCS3M Table 8-1 gives R_VDD a maximum of 300 Ω and C_VDD 0.1 µF typical, 1 µF maximum; R9 was 330 Ω. 220 Ω is the existing TE CRGCQ0402F220R line (A129619CT-ND), with C11 (1 µF) unchanged and inside its bound (Andy, 2026-11-08). Same 0402 footprint. Checks: nets 208 of 209, 17 of 17 sheets and the board identical, ERC 8, DRC 5 / 0 / parity 0, pad-nets identical.
    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
2026-11-07 KiCad: C15, C16 to 1 µF (Samsung CL05A105KA5NQNC, C42's part); the 0.22 µF line is gone
    C16 bypasses V_PRIME at both the TPS2105's IN2 and U21 (TPS22917) VIN. TI: "In most situations, using an input capacitance (CIN) of 1 μF is sufficient to prevent the supply voltage from dipping when the switch is turned on" (SLVSDW8B §11), and U21 switches the backup battery onto C2 (22 µF); 0.22 µF was short of that. The TPS2105 asks "a 0.22-µF ceramic bypass" at each input (SLVS235A) with no maximum, so 1 µF meets it on both; C15 (IN1, 5V_LP) follows for one line (Andy, 2026-11-08). Same 0402 footprint. Checks: nets 208 of 209, 17 of 17 sheets and the board identical, ERC 8, DRC 5 / 0 / parity 0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
2026-11-08 KiCad: C3, C4, C14 to 22 µF (GRM219R61C226ME15L) for effective margin at 4.2 to 5 V
    Murata's DC-bias data: the 10 µF 0805 delivers 6.04 µF at 4.2 V and 5.22 µF at 5 V, the 22 µF 9.14 and 7.58. C3 (V_BETA: U1's input, bulk for U22's inrush into C2, the LTC4412 load side), C4 (5V_LP: U1's output, minimum 4.7 µF, stability C >= L/2 = 3.4 µF) and C14 (V_LI: the LT3652's required 10 µF at BAT) take the larger part (Andy, 2026-11-08; NW-Status capacitors.md). Same 0805 footprint. Checks: nets 208 of 209, 17 of 17 sheets and the board identical, ERC 8, DRC 5 / 0 / parity 0, pad-nets identical.
    Claude-Session: https://claude.ai/code/se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
2026-11-08 KiCad: C43 is a 100 µF 10 V X5R 1206 ceramic (Murata GRM31CR61A107MEA8L), on its existing pads
    The Vishay TL8A0107M010D is obsolete (#43). Leakage decided the type: the tantalums are rated at 63 to 100 µA maximum, bounded at roughly 12 to 41 µA on the always-on V_CORE against a 4 µA backup-sleep figure; a ceramic leaks nanoamps. Murata's data: 50.6 µF at 3.6 V, 34.8 µF at 5 V (25 °C), -6.7 % at -40 °C; worst case about 26 µF at 5 V, enough to carry V_CORE through the TPS2105's ~0.65 ms switchover at the logger's loads. 10 V rating puts V_CORE's 5.0 to 5.4 V at 50 to 54 %. 873,508 on Digi-Key, /bin/bash.55 (Andy, 2026-11-08). The part is 1206 like the tantalum, so it sits on the exis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
2026-11-08 README: solar panel 4.95 to 16 V open-circuit on v0.7.0 (C10 is rated 16 V; #44)
    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
2026-11-08 KiCad: R22, R69, R70, R71, R48 on the dual 0603/0402 land (nw-cold-silicon R0402_0603)
    The five user-swappable resistors (the MPPT pair R22/R69, the charger start-voltage pair R70/R71, the reference bias R48; #33, #36) take nw-cold-silicon's R0402_0603 (84d2436): Blues' production-proven geometry, pads 0.75 x 0.80 mm at +/-0.725 mm. Same inner edge as the 0603 land, so every track end stays on its pad. Fitted parts unchanged for now; R48's move clear of C31 (#36) is separate. Zones refilled: no fill changed. Checks: nets 208 of 209, 17 of 17 sheets and the board identical, ERC 8, DRC 5 / 0 / parity 0, pad-nets identical.
    Claude-Session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
2026-11-08 KiCad: R69 and R71 fitted as 0402s on their dual lands, joining the 100 kΩ and 1 MΩ 0402 lines
    Andy, 2026-11-08: 0402 at the factory on the Blues-geometry dual land (R0402_0603). R69 RC0402FR-07100KL (311-100KLRCT-ND, as R18); R71 RC0402FR-071ML (311-1.00MLRCT-ND, as R55). A user can still fit an 0603 to retune the panel settings. Retires the 100 kΩ 0603 and 1 MΩ 0603 lines. Checks: nets 208 of 209, 17 of 17 sheets and the board identical, ERC 8, DRC 5 / 0 / parity 0, pad-nets identical.
    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
2026-11-08 KiCad: R81 to R83 (B-SoM RGB LED) 5.6 kΩ to 5.1 kΩ, the USB-C CC resistors' line
    The LED cathode resistors are the flexible position; 5.1 kΩ is held by R84/R85, which USB-C sets. The LED runs about 10 % brighter. Retires the 5.6 kΩ line (Andy, 2026-11-08). Checks: nets 208 of 209, 17 of 17 sheets and the board identical, ERC 8, DRC 5 / 0 / parity 0, pad-nets identical.
    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
2026-11-08 KiCad: R11 (BQ298000 BAT resistor) 20 Ω to 27 Ω, the FT231X USB series line
    TI lists R_BAT 20 Ω typical and notes a larger value can affect OV/UV measurement accuracy; the BAT pin draws microamps, so 7 Ω more moves the reading by microvolts (estimate). 27 Ω is held by R34/R35, FTDI's reference value. Retires the 20 Ω line (Andy, 2026-11-08). Checks: ERC 8, DRC 5 / 0 / parity 0, pad-nets identical; nets and round-trip in the next commit's full run.
    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
2026-11-08 KiCad: R3 (TPS61032 low-battery divider) 360 kΩ to 330 kΩ, R17's line
    With R2 (1.62 MΩ), the LBI threshold on V_HP moves from 0.5 x (1 + 1.62/0.36) = 2.75 V to 0.5 x (1 + 1.62/0.33) = 2.95 V. 330 kΩ is held by R17 in the LT3652's float divider, which sets the cell's charge voltage. Same 0603 footprint. Retires the 360 kΩ line (Andy, 2026-11-08). Checks: nets 208 of 209, 17 of 17 sheets and the board identical, ERC 8, DRC 5 / 0 / parity 0, pad-nets identical.
    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
2026-11-09 KiCad: R15 1 kΩ (RC0402FR-071KL), the BQ298000 PACK resistor, on R12's line
    From 2 kΩ: Table 8-1 sets a 2 kΩ maximum and no minimum. Against the
    internal 100-550 kΩ PACK pull-down, PACK reads 8-42 mV low at 4.2 V
    instead of 15-82 mV, against 100/400/700 mV detection thresholds. A
    reversed cell reaches BAT through R11 (27 Ω) and VDD through R9 (220 Ω)
    before PACK, so 1 kΩ adds no weak point (Andy 2026-11-09: change if safe).
    Removes 2k from the board's values. Checks: nets 208 of 209, 17 of 17
    sheets and the board identical, ERC 8, DRC 5 / 0 / parity 0, pad-nets
    identical.
    Claude-Session: https://claude.ai/code/session_017F2gr2ax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
2026-11-09 KiCad: R21 1 MΩ 1 % (ERJ-3EKF1004V), the LTC4412 STAT pull-up
    From 470 kΩ 5 %: STAT's 10 µA sink still pulls fully low (R ≥ 420 kΩ),
    the 470k line leaves the board, and the pin draws 4.6 µA instead of about
    10 µA while USB carries the load (Andy 2026-11-09). Panasonic for the
    shorter Digi-Key lead time. Checks: nets 208 of 209, 17 of 17 sheets and the board identical, ERC 8, DRC 5 / 0 / parity 0, pad-nets identical.
    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
2026-11-09 KiCad: R13 180 kΩ (ERJ-3EKF1803V), the LT3652 VFB bias resistor, on R1/R8's line
    From 182 kΩ: R13 + R16||R17 = 251.3 kΩ against 253.3 kΩ, inside the
    225-275 kΩ window around the 250 kΩ bias compensation; the float stays
    3.3 V x (1 + 91/330) = 4.210 V. The 182k line leaves the board (Andy
    2026-11-09). Checks: nets 208 of 209, 17 of 17 sheets and the board identical, ERC 8, DRC 5 / 0 / parity 0, pad-nets identical.
    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
2026-11-09 KiCad: R2/R4 1.62 MΩ primary Vishay CRCW06031M62FKEA (100 ppm/°C)
    The Stackpole RMCF0603FT1M62 is ±200 ppm/°C (Digi-Key, 2026-11-09), past
    the 100 ppm rule for 1 % lines; the Vishay is 100 ppm, Active, 12,095 in
    stock at Digi-Key US. R4 sets the TLV61220's 5 V and R2 the TPS61032's
    low-battery threshold.
    Checks: nets 208 of 209, 17 of 17 sheets and the board identical, ERC 8, DRC 5 / 0 / parity 0, pad-nets identical.
    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
2026-11-09 KiCad: R51 0 Ω primary Panasonic ERJ-2GE0R00X (Yageo RC0402JR-070RL at 0 in stock)
    Digi-Key US, 2026-11-09: the Yageo part 0 in stock, 10,000 due; the
    Panasonic 14,161,449 in stock, 15-week lead.
    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
2026-11-09 KiCad: R20 130 kΩ primary Panasonic ERJ-3EKF1303V (Yageo RC0603FR-07130KL at 0 in stock)
    Digi-Key US, 2026-11-09: the Yageo part 0 in stock, 5,000 due, 24-week
    lead; the Panasonic 59,870 in stock, 15-week lead. Same value, 1 %,
    100 ppm/°C; the TPL5111's 66-minute interval is unchanged.
    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
2026-11-09 KiCad: R70 200 kΩ fitted 0402 on its dual land, Panasonic ERJ-2RKF2003X
    From the 0603 Yageo RC0603FR-07200KL, which the R0402_0603 land takes
    either way: the dual lands are fitted 0402 throughout (R48, R69, R71).
    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
2026-11-09 KiCad: R49/R50 precision 10 kΩ primary Bourns CRT0603-BY-1002ELF, Margay's part
    One line for both boards. Digi-Key US, 2026-11-09: the Bourns 66,794 in
    stock, 20-week lead; the Panasonic ERA-3AEB103V 0 in stock, 55-week lead.
    Both 0.1 %, ±25 ppm/°C, 0603 thin film.
    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
2026-11-09 KiCad: secondary parts (ALT_MPN, ALT_MF, ALT_DIGIKEY) on every resistor line except the shunts
    A different maker per line, Active and in stock at Digi-Key US on
    2026-11-09 (NW-Status sources/2026-11-09-resistor-digikey-agent-report.md),
    81 positions, read back from a fresh netlist with 0 mismatches. Not yet:
    R10, R72-R75 (the shunt secondaries' land patterns are unchecked) and R22
    (143k, replaced on v0.8.0 by #46). Fields hidden, in the importer's form.
    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
2026-11-09 KiCad: C30 22 µF (GRM219R61C226ME15L), the MCP4726's VDD bulk, on C7's line
    From 10 µF on the same 0805 land: the MCP4726 datasheet draws a 10 µF
    tantalum (no DC-bias loss); at 5 V the 10 µF X5R gave 5.2 µF effective and
    the 22 µF gives 7.6 µF (Murata data). Okapi's 10 µF line leaves the board
    (Margay still uses it). Andy 2026-11-09.
    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
2026-11-10 docs: v0.7 pre-build checks carry the consolidation's changes since 2026-11-06
    R3, R5/R7, R6, R9, R11, R13, R15, R21, R70/R71, R81-R83, C1, C3/C4/C14,
    C30, C15/C16, C22, C33, C43, XTAL1, and the dual lands of R22/R69/R70/R71,
    from a netlist diff against a5b9409. R9 leaves the 330 ohm group (220 ohm).
    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
2026-11-10 KiCad: R1, R8 to 0402 on the 180 kΩ line (RC0402FR-07180KL); GND track under R8 centered (#33)
    The 5V_AUX pull-ups into the expander join R5/R7/R65/R66 on the 0402 180 kΩ
    line (secondary ERJ-2RKF1803X). Footprint R0603 to R0402 with rebody.py;
    the old track ends still land on the smaller pads. R8's pad 2 then sat
    0.117 mm from the GND track that runs between its pads (rule 0.127): that
    track's vertical run moved 0.056 mm to the part's center line, 145.8441,
    with its two 45-degree joints shortened to match, for 0.173 mm on both
    sides. No zone refill was needed. Checks: nets 208 of 209, 17 of 17 sheets
    and the board identical, ERC 8, DRC 5 / 0 / parity 0, pad-nets identical.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
2026-11-10 docs: figure for #37, the PAC1934 SLOW trace boxed in by 3V3_CORE and the B.Cu bundle
    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
2026-11-10 KiCad: delete the 'Check current rating!!' note beside F1 (#28 item 4)
    F1, the MF-NSMF150-2 on the USB power input, holds 1.5 A and trips at
    3 A, under D9's (B340A) 3 A rating; a USB port supplies 500-900 mA, so
    normal use never reaches it and the fuse is sized for a fault (Andy,
    2026-11-10). Checks: nets 208 of 209, 17 of 17 sheets and the board
    identical, ERC 8, DRC 5 / 0 / parity 0, pad-nets identical.
    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
2026-11-10 KiCad: JP8 and R62 out; R20 to GND directly, the TPL5111 keeps 66 minutes (#34)
    R62 (330 kOhm) sat above the TPL5111's 170 kOhm maximum, so JP8's other
    position never worked (decided 2026-11-05). Schematic: R62 and JP8
    deleted, R20's lower lead wired to JP8's GND symbol, the DELAY wire
    merged across R62's junction. Board: both footprints and R62's two
    stubs deleted; R20 pad 1's track (formerly to JP8 pad 3) runs on to
    JP8's old GND track at 146.8601, 83.9846. Checks: 17 of 17 sheets and
    the board identical; ERC 8; DRC 5 / 0 / parity 0. Eagle nets 204 of
    209 (with JP8, R62 ignored): the four intended changes (GND, N$19,
    N$42, N$63) plus the known BT1 one. Pad-nets: only JP8 and R62 gone
    and R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
2026-11-10 KiCad: R48 1 mm right, clear of C31, with a 'VREF bias' silk label (#36)
    Hot air on the user-swappable R48 no longer reaches C31 (centers 1.65 to
    2.65 mm apart). Its 5V_AUX lead now drops straight from the pad and
    joins the via at 45 degrees; its VREF lead's horizontal run lengthens by
    1 mm. Checks: 17 of 17 sheets and the board identical, ERC 8, DRC 5 / 0
    / parity 0, pad-nets identical, Eagle nets unchanged (204 of 209 since
    #34).
    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
2026-11-10 README: where R48 is on the board (silk 'VREF bias'), for the reference-current swap (#36)
    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
2026-11-10 Revert "README: where R48 is on the board (silk 'VREF bias'), for the reference-current swap (#36)"
    This reverts commit 9a7f161b025a528d2d1597b670524fe92bb8a4c9.
2026-11-10 Revert "KiCad: R48 1 mm right, clear of C31, with a 'VREF bias' silk label (#36)"
    This reverts commit 2445bf9d6acc26a4fd24d50697211deadbfbdc73.
2026-11-10 README: solar charger set points, with R22/R69 and R71/R70 values per panel class (#20)
    Formulas from the LT3652 (VIN_REG 2.7 V, SHDN 1.2 V); values from the
    2026-11-09 solar-panel study, recomputed: 6.561/7.2 V as built for
    6 V 12-cell panels, 5.917/7.054 V for 10-cell ETFE panels, 16.2/13.2 V
    for 12 V panels on v0.8.0. Notes that 10-cell panels may not start the
    charger as built, and why 12 V panels wait for v0.8.0.
    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
2026-11-10 KiCad: 'START' and 'MPPT' silk labels under the charger's user-set pairs R71/R70 and R22/R69 (#20)
    Points a user at the parts the README's solar-charger table changes.
    Checks: 17 of 17 sheets and the board identical, ERC 8, DRC 5 / 0 /
    parity 0, pad-nets identical.
    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
2026-11-10 KiCad: second-source parts on the shunts R10, R72-R75 (KOA, Vishay)
    ALT_MPN, ALT_MF and ALT_DIGIKEY, hidden, in the form 4adc304 gave every
    other resistor line, carried to the board with link_paths.py --fields:
    - R72, R73, R75 (20 mOhm 0805): KOA UR73VD2ATTD20L0F, 2019-UR73VD2ATTD20L0FCT-ND
    - R74 (50 mOhm 0805): KOA UR73V2ATTD50L0F, 2019-UR73V2ATTD50L0FCT-ND
    - R10 (3 mOhm 0805): Vishay WFC08053L000FE66, 541-WFC08053L000FE66CT-ND
    Land fit (NW-Status sources/2026-11-10-c10-parts-lookups-agent-report.md,
    against each primary's recommended land): the 20 mOhm KOA fits as-is (gap
    0.8 against Panasonic's 0.9). The 50 mOhm KOA wants a 1.2 mm gap, 0.3 mm
    wider than the Panasonic land, and mounts. Th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
2026-11-10 README: the slide switches S1/S2 pick each sensor bus's voltage, gated so 5 V and 3.3 V are exclusive; firmware only enables the bus (#53)
    Was: 'the firmware enables one or neither'. Traced from the netlist:
    U14/U15 AND gates and U11/U12 inverters on S1-P/S2-P. Moving the switch
    with the logger running is safe once #53's pull-downs are fitted.
    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
2026-11-10 KiCad: U1, U2, U3 refreshed from nw-cold-silicon 31f86a1, switch-node pins typed by datasheet (ERC 8 to 5)
    TLV61220 and TPS61032 SW input, TPS62822 SW power output (B5 item 5a).
    Checks: nets 204 of 209, 17 of 17 sheets and the board identical, ERC 5
    (the five dual-switch warnings), DRC 5 / 0 / parity 0, pad-nets identical.
    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
2026-11-10 KiCad: S5's keepout on F.Cu per the Panasonic EVP-BB land pattern (nw-cold-silicon 32cb601); DRC 5 to 3
    Re-bodied with rebody.py: the zone's layer and track rule change, and its
    body items take fresh uuids as on placement. No via or pad sits in the
    corrected area, which is the datasheet's requirement; the two B.Cu tracks
    (V_PRIME, V_PRIME_SENSE) stay. Checks: nets 204 of 209, 17 of 17 sheets
    and the board identical, ERC 5, DRC 3 / 0 / parity 0, pad-nets identical.
    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
2026-11-10 KiCad: the bottom GND pour removes islands, as the other GND pours do; the 46 mm2 floating island is gone (DRC 3 to 2)
    island_removal_mode 1 (never) came from Bobby's Eagle polygon, which kept
    orphans; KiCad's default 0 (always) matches the board's other GND pours.
    Zones refilled with pcbnew: the GND B.Cu pour drops one of its three
    filled polygons, and the 5V_AUX F.Cu pour moves 8 vertices by about
    0.02 mm near R1 (141.6, 135.2), catching up with R1's 0402 pads (#33).
    Nothing outside the zones changed. Checks: nets 204 of 209, 17 of 17
    sheets and the board identical, ERC 5, DRC 2 / 0 / parity 0, pad-nets
    Claude-Session: htt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
2026-11-10 KiCad: delete two dangling bottom-copper stubs left from the Eagle routing (DRC 2 to 0)
    V_LI near J2: a 0.40 mm overshoot past a trace corner.
    3V3_AUX beside C28/U30: a 0.25 mm spur off a joint whose two
    segments share an exact endpoint, so the trace stays continuous.
    Neither stub touched a pad or via at its free end. Gates: Eagle nets
    204 of 209 (5 known differences), 17 sheets and the board identical
    on round trip, ERC 5, DRC 0 / unconnected 0 / parity 0, pad-nets
    identical; a refill with the project rules changes no pour.
    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
2026-11-10 KiCad: two-layer stackup from Bobby's Eagle design rules (jlcpcb-2layer)
    Eagle's layerSetup (1*16) gives 0.035559375 mm copper on each side of
    a 1.6 mm core, and the 2024-11-02 Gerber job (in the repository and in
    Okapi_2024-11-02.zip, byte-identical) reports the sum, 1.671119 mm.
    The stackup now records the same: F.Cu and B.Cu 0.035559 mm (KiCad
    stores whole nanometers), FR4 core 1.6 mm, and the board thickness
    1.671118 mm; KiCad's own Gerber job reports 1.6711 mm. Solder mask is
    0 thickness because Eagle did not model it, so the total matches.
    Gates: Eagle nets 204 of 209 (5 known differences), 17 sheets and the
    board identical on round trip, ERC 5, DRC 0 / unconnected 0 / parity 0,
    pad-n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
2026-11-10 KiCad: Particle net names, one module served two ways (Feather socket MS1, B-SoM M.2 socket J9)
    FEATHER_EN -> PARTICLE_EN
    FEATHER_BAT -> PARTICLE_VCC
    3V3_FEATHER -> PARTICLE_3V3
    FEATHER_GPIO -> PARTICLE_GPIO
    FEATHER_RTS -> PARTICLE_RTS
    FEATHER_CTS -> PARTICLE_CTS
    SDA_FEATHER -> SDA_PARTICLE
    SCL_FEATHER -> SCL_PARTICLE
    BSOM_VUSB -> PARTICLE_BSOM_VUSB
    29 labels on five sheets; board nets renamed by pin set (rename_nets.py).
    Sheet names (Feather_ISP, USB_ISP_Feather) and text notes unchanged.
    Gates: Eagle nets 204 of 209 (5 known), 17 sheets and the board identical
    on round trip, ERC 5, DRC 0 / unconnected 0 / parity 0; pad-net table
    identical for all 1071 pads once the nine names are mapped (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
2026-11-11 KiCad: J10 and USB2 shell stakes in milled slots, re-bodied from nw-cold-silicon 26badbb
    The Eagle import had dropped the slots Eagle milled on layer 46, so
    J10 (USB-C) and USB2 (vertical micro-USB) had round drills where
    their shell stakes need slots. Re-bodied from the library, which now
    makes each milled outline the pad's oval drill: J10 M1/M2 0.6 x 1.7
    and M3/M4 0.6 x 1.2 in 1 x 2 copper; USB2's three pairs of 0.5 mm
    holes become three oval pads, 0.5 x 1.2, 0.5 x 1.2 and 0.5 x 1.6.
    Exported drill file against the fabricated profile.gbr of
    Okapi_2024-11-02.zip (offset from J10's two 0.65 mm holes): all seven
    slots land on the milled outlines, residual 0 at 0.001 mm.
    Gates: Eagle nets 20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
2026-11-11 KiCad: the board's printed labels back on the silkscreen (Eagle tDocu/bDocu, 116 items)
    Eagle's CAM for the 2024 fab (Okapi_2024-11-02.zip) printed layer 51 on
    the top silkscreen and 52 on the bottom: RST, LOG, STAT, AUX, MODE, the
    A/B/C jumper grid, '3v3/5v', 'No Cover!' on top; the pin labels, the
    port-limit notes, the VSolar/VBat/VPrime ranges, 'Primary Bus' and
    'Secondary Bus', and the 'Project Okapi v1.0' credit on the bottom.
    KiCad's import put them on F.Fab and B.Fab, which do not print. All 78
    board-level texts and 38 drawings move to F.SilkS and B.SilkS; the
    rendered silkscreen Gerbers now carry them as Eagle's did. Board
    normalized by kicad-cli pcb upgrade; the diff is the layer ch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
2026-11-11 KiCad: Bobby's two bottom keepouts restored, under XTAL1/C40/C41 and under L2
    Eagle bRestrict polygons (Okapi.brd plain, layer 42), dropped by the
    importer (NW-Status Eagle conversion audit, finding B1): 27.50 mm2 under
    the crystal and its load capacitors, 60.51 mm2 under the inductor. Each is
    a B.Cu rule area with no tracks, vias, pads or pour, from Eagle's
    vertices. Refilling changes no zone's copper (the 2024 fab had none there
    either), so this only keeps v0.8 routing out of them. Checks: board round
    trip identical, DRC 0 / unconnected 0 / parity 0.
    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
2026-11-11 KiCad: U41 MCP23018 manufacturer is Microchip, not TI (an error carried from the 2021 BoM)
    Found by the part verification (NW-Status sourcing-brands). Checks: nets
    204 of 209, sheets and board identical on round trip, ERC 5, DRC 0 /
    unconnected 0 / parity 0.
    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
2026-11-11 KiCad: J10 is KiCad's GCT USB4105 footprint, replacing the Eagle USB_C_CUSB31-CFM2AX-01-X (Andy)
    As Project-Margay 8706d25: nw-cold-silicon's native copy of KiCad's
    footprint (GCT's slots 1.7 and 1.4 mm, pads A1..B12), the USB_C symbol's
    two-pad pins split to match, J10 placed by pcbnew so every contact pad,
    shell slot and peg lands on the old one (0 nm offset).
    Checks: 17 sheets and the board identical on round trip; ERC 5; nets 204
    of 209 with J10's split pins folded back (203 raw); parity 0; DRC 4, all
    new at J10: KiCad's courtyard (wider than Eagle's) overlaps R84, R85 and
    C22, and one GND track passes 0.117 mm from a front shell pad against
    0.127. Shell pads have no net, as before.
    Co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
2026-11-11 KiCad: GND corner beside J10's shell pad moves 0.144 mm onto the 5-mil grid, clear of the GCT pad
    The corner at (127.0311, 165.3916) goes to (127.1751, 165.3916), Eagle
    (11.049, 7.112), both multiples of 0.127 mm; the diagonal to the
    junction at (128.3621, 166.7226) keeps its end. Clearance to the front
    shell pad was 0.117 mm against 0.127. Zones refilled, no copper change.
    Checks: board round trip identical; DRC 3 (KiCad's courtyard over R84,
    R85 and C22) / unconnected 0 / parity 0.
    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
2026-11-11 Revert "KiCad: J10 is KiCad's GCT USB4105 footprint, replacing the Eagle USB_C_CUSB31-CFM2AX-01-X (Andy)"
    This reverts commit 2734fc4d4007f0cc98058ea7c952ddfef1a39c42.
2026-11-11 KiCad: J10 front shell slots 1.4 mm (GCT's length), re-bodied from nw-cold-silicon 7cec4b9
    Andy's footprint otherwise unchanged (pads 1.0 x 2.0); no pad moved.
    Checks: board round trip identical; DRC 0 / unconnected 0 / parity 0.
    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
2026-11-11 KiCad: J10 takes its footprint's new courtyard and description, re-bodied from nw-cold-silicon 7a6ebc7
    The courtyard overlaps R84, R85 and C22 (DRC 3, courtyards_overlap);
    round trip identical, unconnected 0, parity 0.
    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
2026-11-11 Rules: J10's courtyard over R84, R85 and C22 accepted, as fabricated in 2024 (DRC 3 to 0)
    A named rule in Okapi.kicad_dru, beside the other as-fabricated rules,
    with the reason in its comment. Targeted: with C22 dropped from the
    condition, exactly the C22 overlap returns. Copper clearances unchanged.
    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
2026-11-11 KiCad: BT1 is the Linx BAT-HLD-012-SMT-TR (active), the obsolete BAT-HLD-012-SMT on tape and reel (#73)
    Same holder and footprint (TE drawing BAT-HLD-012-SMT-OTL rev B lists the
    two as one part in two packings); Digi-Key BAT-HLD-012-SMTCT-ND, 1,518 in
    stock on 2026-11-11 (part verification report). TE rates it -30 to 70 C:
    a documented exception to the -40 C rule until a holder that fits is
    found. Checks: nets 204 of 209, round trip identical, ERC5 DRC0, unconnected 0, parity 0.
    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
2026-11-11 KiCad: BT1 is the MPD BK-916-TR, for its price, quantity and -40 C rating (Andy, #73)
    MPD drawing BK-916 rev E: -40 to +270 C, CR1216/1220/1225, one
    phosphor-bronze clip. Digi-Key BK-916-CT-ND: 45,748 in stock, $0.388 at
    100 (2026-11-11), against the Linx -TR's 1,518, $0.46 at 1,000 and
    -30 C. Footprint unchanged (LINX_BAT-HLD-012-SMT): the side pads match to
    0.03 mm and the center pad to 0.04 mm, but the drawing omits the tabs'
    offset from the cell center, so the fit is to be confirmed before boards
    are ordered. Checks: nets 204 of 209, round trip identical, ERC 5, DRC 0, unconnected 0, parity 0.
    Claude-Session: https://claude.ai/code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
2026-11-11 KiCad: J10's USB-C shell (SHIELD, S1) to GND (Andy, Project-Margay #81)
    The USB_C symbol refreshed from nw-cold-silicon b9a9e4c, which adds the
    SHIELD pin, and a GND symbol (#SUPPLY011) on that pin's end. Netlist: the
    only change is J10.S1 joining GND. ERC 5 as before; Eagle check 204 of 209
    as before (GND already differed); every sheet re-saves identical.
    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
2026-11-11 KiCad board: J10's shell stakes are pad S1 on GND, tied by short links (Andy, Project-Margay #81)
    J10 takes nw-cold-silicon b9a9e4c's pad numbers (M1-M4 become S1, one piece
    of metal), on GND. The right rear stake joins the GND track beside it on
    F.Cu (1.1 mm of 0.4064 mm track); the left rear stake reaches the GND track
    on B.Cu that runs behind the connector (two segments, 3.5 mm). DRC 0
    violations, 0 unconnected, parity 0, as before.
    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
2026-11-12 README: JP8 and R62 are gone from the KiCad board (#34); fix the pointer to #33
    The 66-minute timer section still described JP8 as present and sent the
    reader to #33, which is the resistor-footprint issue. It now says the
    2024 boards carry JP8 and R62 and the KiCad board removes both.
    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
2026-11-12 Schematic: AREF off 3V3_CORE onto its own 100 nF, C58 (#15)
    IC1 pin 29 (AREF) was wired straight to 3V3_CORE beside AVCC. With a
    fixed voltage on AREF the datasheet forbids selecting the internal 1.1 V
    or 2.56 V reference, which would be shorted to the rail (DS40002070B),
    and on an open Arduino board that is one analogReference() call away.
    AREF now goes to C58, a 100 nF GCM155R71C104KA55D (0402) to GND, by local
    labels: the datasheet's "AVCC with external capacitor at AREF pin".
    AVCC stays on 3V3_CORE with C42 (#28 item 2, decided 2026-11-12).
    C58 is the next free number, clear of the 2024 boards' designators.
    Schematic only: the board is placed in v0.8.0 (#78), so DRC parity now
    reports C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
2026-11-12 Schematic: C59-C61, 100 nF at each of IC1's VCC/GND pairs (#17)
    Three 100 nF GCM155R71C104KA55D (0402) from 3V3_CORE to GND, as decided
    2026-11-08 per AN2519: C59 at pins 5/6, C60 at 17/18, C61 at 38/39. A
    note on the sheet says which pair each one serves, for the v0.8.0
    layout (#78), where IC1's fanout is rerouted to put each beside its pins.
    Checks: netlist pin-for-pin, only C59-C61 pin 1 join 3V3_CORE and pin 2
    join GND (comps 251 to 254, nets 280); ERC unconnected endpoints 0,
    off-grid 0, total 5 (unchanged); round trip all sheets identical; DRC
    parity 2 to 5, the three new footprints the board does not have yet.
    Claude-Session: h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
2026-11-12 Schematic: R88, the LT3652's 50 mOhm charge-current sense resistor (#32)
    Since 677d839 (2024) SENSE and BAT sat on one net, V_LI, so the charger
    had no current to read: constant current ran at the switch limit and the
    C/10 test was met before charging began. R88 now sits in the SENSE row
    between L4's output and the drop to V_LI: L4 pin 2 and U4 SENSE (pin 10)
    on one side, U4 BAT (pin 9), C14, R16 and the rest of V_LI on the other.
    0.1 V / 50 mOhm = 2 A, the part's maximum.
    Part: ERJ-6BWFR050V (0805, 0.5 W, 1 %), R74's line, per the 2026-11-06
    correction on #32. Its value is shown on the sheet (R74 hides its own).
    R88 is the next free number.
    Checks: netlist pin-for-pin, V_LI loses L4.P$2 a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
2026-11-12 Schematic: R89, 100 kOhm pull-up from SLOW to 3V3_CORE (#37)
    The PAC1934's SLOW/ALERT pin (U32 pin 1, net CSA_~{ALERT}) meets only the
    MCP23018's GPB4, open-drain with its pull-up off at power-on and never
    configured, so SLOW floated and the PAC1934's sample rate was undefined.
    R89 holds it high, the low-power state, as decided 2026-11-10.
    Part: RC0402FR-07100KL (0402), the board's existing 100k line (R18 as
    template). Placed beside U32 in free space and joined by the two global
    labels, since U32's pin row is fully labeled; a short note marks it.
    Checks: netlist pin-for-pin, R89.1 joins CSA_~{ALERT} and R89.2 joins
    3V3_CORE, nothing else moves (comps 255 to 256, nets 281); ERC
    unconnected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
2026-11-12 Schematic: R90, R91, 100 kOhm pull-downs on the bus-voltage switch commons (#53)
    S1's and S2's common pin P selects 5 V or 3.3 V for each sensor bus
    through U11/U14 and U12/U15, and floated while a slider was between
    positions. R90 (Net-(S1-P)) and R91 (Net-(S2-P)) hold P low there, so the
    5 V and 3.3 V switches can never conduct together. Decided 2026-11-13:
    the AUP inputs leak 1.0 uA per net worst case, 0.1 V at 100 kOhm against
    the 0.9 V low threshold; 33 uA only while the slider sits at 3.3 V.
    Part: RC0402FR-07100KL (0402), the board's existing 100k line, drawn
    down from P's junction to GND, value and name left of the body.
    Checks: netlist pin-for-pin, R90.2 joins Net-(S1-P), R91.2 joi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
2026-11-12 Schematic: move #17's note down 5.08 mm, clear of the space #54 uses
    Text position only; no symbol, wire or net changes.
    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
2026-11-12 Schematic: R92, R93, 100 kOhm pull-downs on C0 and C1 (#54)
    C0 and C1 (IC1 PC2, PC3; JTAG off) select the aux rails through U40 and
    U16 and floated through reset and the bootloader, leaving 5V_AUX, 3V3_AUX
    and V_HP undefined until the firmware drove them. R92 and R93 hold them
    low. Decided 2026-11-13: worst-case leakage 2.5 uA per line (IC1, AUP,
    AHC), 0.25 V at 100 kOhm against the 0.9 V low threshold; 33 uA while a
    line is driven high.
    beside #17's capacitors and joined by the C0 and C1 global labels.
    Checks: netlist pin-for-pin, R92.2 joins C0, R93.2 joins C1, both pin 1
    join GND, nothing else moves (comps 258 to 260,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
2026-11-13 Board: ten vias back to their fabricated size, 0.554 mm on 0.3 drill, 0.508 on 0.254
    The Eagle importer took each via's diameter attribute (0.4016 mm)
    literally; Eagle's restring made them 0.554 and 0.508 mm, which is what
    the 2024-11-02 copper Gerbers flash. The six on 0.3 mm drills had a
    0.0508 mm ring, the four on 0.254 mm drills 0.0738 mm. Same fault as
    U3's thermal vias (6911cdf). Zones refilled around them.
    Check: all ten match the fabricated flash, top and bottom (20 of 20).
    Eagle nets 197 of 209 (12 attributed), ERC 5, DRC 0 / 0 / parity 13,
    round trips identical.
    Claude-Session: https://claude.ai/code/session_017F2gr2axqf8HWh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
2026-11-13 Board rules: Eagle's 6 mil clearances to vias and through-hole pads, and its 5 mil via ring
    From jlcpcb-2layer in Okapi.brd: mdWirePad, mdWireVia, mdPadVia and
    mdViaVia are 6 mil (0.1524 mm), as four rules in Okapi.kicad_dru; the
    5 mil pairs stay on the netclass's 0.127 mm. rlMinViaOuter 5 mil is the
    minimum via ring (0.127 mm, was the import's 0.0508), and the minimum via
    diameter is Eagle's msDrill 0.2 mm plus two rings (0.454 mm, was 0.4016).
    Check: the board meets all of them, DRC 0 / 0 / parity 13. Each rule
    bites: at 0.3 mm the four report 774 track-via, 126 track-pad, 92
    via-via and 6 pad-via items, and one via set back to 0.4016 mm on a copy
    reports annular_width and via_diameter.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
2026-11-13 Board: the GND corner beside J10 back at Eagle's point (reverts 474288b)
    474288b moved the corner 0.144 mm, to (127.1751, 165.3916), clear of the
    GCT USB-C's front shell pad; 1a3b25b reverted that footprint 19 minutes
    later and the move stayed without its reason. Against today's J10 the
    corner at Eagle's (10.905, 7.112), KiCad (127.0311, 165.3916), meets every
    rule, the 6 mil track to through-hole pad included.
    Check: DRC 0 / 0 / parity 13 with zones refilled (fills unchanged);
    Eagle nets 197 of 209 (12 attributed), ERC 5, round trips identical.
    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
2026-11-13 Board: every footprint re-bodied from nw-cold-silicon 7c956b8, so the package documentation prints
    Eagle's CAM for the 2024 fab printed tDocu and bDocu, the A1 and A3
    divider diagrams under U$1 and U$2, IC1's pin stripes, the M.2 card
    outline and the IC and terminal outlines among them; KiCad had them on
    Fab only. The library now copies each to the silkscreen of its side.
    Check against the fabricated silkscreen Gerbers (gerbv 600 dpi, 0.15 mm
    tolerance): Eagle-only ink on top 55.15 to 13.83 mm2, on the bottom
    10.80 to 8.09 mm2; KiCad-only ink unchanged (2.77, 8.17). 250
    footprints re-bodied, 0 pad changes, pad-net table identical. Eagle nets
    197 of 209 (12 attributed), ERC 5, DRC 0 / 0 / pa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
2026-11-13 Board: twelve reference designators that the 2024 board printed are shown again
    U2, U11-U16, U27, U29, U42, S1 and S2: their Eagle packages carry no
    >NAME text, and each element's smashed NAME attribute on tNames printed;
    the importer hid the reference in that case. Positions are the
    importer's, from the attribute. BT1 stays hidden: its footprint is now
    MPD's, and its reference would print where the 2024 board printed none.
    Check against the fabricated top silkscreen: Eagle-only ink 13.83 to
    10.52 mm2, KiCad-only 2.77 to 2.78. DRC 0 / 0 / parity 13, round trips
    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
2026-11-13 Board: J8, the LiPo connector, gets + and - on the bottom silkscreen (Resnik 2020)
    The pair from the 2020 stash (archive/resnik-polarity-marks-2020, Eagle
    45.847 and 48.387 at y 2.286, bDocu), in the form of the three pairs
    beside it: + at KiCad x 161.9731 under J8 pad 2 (LI+), - at 164.5131
    under pad 1 (LI-), 1.0795 mm, mirrored. Neither the 2024 Eagle board nor
    its fab carried them; Andy asked for every mark (2026-11-13).
    Check: rendered from below, the pair sits under the second VBat label
    like its neighbors. DRC 0 / 0 / parity 13.
    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
2026-11-13 Schematic: ten values that Eagle printed are shown again (R51, R54, R72-R75, R84-R87)
    They were hidden while the value was a package name (0ac3de9, 2959b52)
    and stayed hidden when f6d69e0, ea0956c, 71462f6 and 3ff57bd gave them
    real values. R74's 50m moves 5.08 mm left, under its own body, clear of
    C10. XTAL1 stays hidden for now: its value is the Eagle device name
    CRYSTAL8MHZ5X3.2, which printed down through the crystal, C42 and RST.
    Check: each rendered and viewed; Eagle nets 197 of 209 (12 attributed),
    ERC 5, DRC 0 / 0 / parity 13, all sheets re-save identically.
    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
2026-11-13 Schematic: symbols refreshed from nw-cold-silicon e5f1e83, pin names and types by datasheet
    U43 (BMA456) pin 1 reads SDO and pin 10 CSB, where they read GND and VCC;
    U38 (MLX90393) pins 4, 9, 10, 14 and 16 read NC, where they read VSS.
    Open-drain outputs typed so: U2 and U9 PG, U3 LBO, U7 STAT, U33 ALERT,
    RTC1 SQW. IC1 PC0 and PC1 bidirectional; U45 SCL input and SDA
    bidirectional. No wire moves; the copper was right throughout.
    Check: Eagle nets 197 of 209 (12 attributed), ERC 5 (the same five), DRC
    0 / 0 / parity 13, all sheets re-save identically.
    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
2026-11-13 Q3 and Q5: maker onsemi, where it read Fairchild (FDN360P, active at onsemi)
    Symbols refreshed from nw-cold-silicon, the two instances' MF fields and
    the two footprints' on the board. MPN and Digi-Key number unchanged.
    The Bosch MPNs on U31 and U43 ("BME280", "BMA456") were checked and are
    Bosch's order codes (Digi-Key 828-1063-1-ND, 828-1075-1-ND).
    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
2026-11-13 Revert "Schematic: R92, R93, 100 kOhm pull-downs on C0 and C1 (#54)" for v0.7.0, the KiCad conversion
    v0.7.0 is the conversion with schematic and board in agreement; parts
    that only the schematic carries wait for v0.8.0, where the layout places
    them, and come back then by reverting this revert (Andy, 2026-11-13).
    This reverts commit c7d8c7164de5c9b2332087d33626f48cac6dacbf.
    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
2026-11-13 Revert "Schematic: move #17's note down 5.08 mm, clear of the space #54 uses" for v0.7.0, the KiCad conversion
    This reverts commit f7dd07d200a3df0925760a70ff9b50e2309ac75d.
    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
2026-11-13 Revert "Schematic: R90, R91, 100 kOhm pull-downs on the bus-voltage switch commons (#53)" for v0.7.0, the KiCad conversion
    This reverts commit 17be6c504afda1eb18931a356488bbf381ac6428.
    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
2026-11-13 Revert "Schematic: R89, 100 kOhm pull-up from SLOW to 3V3_CORE (#37)" for v0.7.0, the KiCad conversion
    This reverts commit 384cab01f1b19f07fda5cf288e5950d6afbd71a5.
    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
2026-11-13 Revert "Schematic: R88, the LT3652's 50 mOhm charge-current sense resistor (#32)" for v0.7.0, the KiCad conversion
    This reverts commit c9eae66f276685223929c4d70fdebcc2bf5addec.
    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
2026-11-13 Revert "Schematic: C59-C61, 100 nF at each of IC1's VCC/GND pairs (#17)" for v0.7.0, the KiCad conversion
    This reverts commit 33889a5bb7ea2a1f91cd8171457122423cfc016f.
    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
2026-11-13 Revert "Schematic: AREF off 3V3_CORE onto its own 100 nF, C58 (#15)" for v0.7.0, the KiCad conversion
    This reverts commit 7c33037a86bcc60fe6adbb3e36b7aba7a0e41998.
    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
2026-11-13 README: on v0.7.0 the slide switches move with the logger off; #53's pull-downs come in v0.8.0
    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
2026-11-13 Board: footprints re-bodied from nw-cold-silicon bb46777, each with its KiCad type
    226 smd, 13 through_hole; the diff is those attr lines and item uuids.
    Pad-net table identical; DRC 0 / 0 / parity 0.
    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
2026-11-13 Board rules: footprint_type_mismatch is an error again, now that every footprint has a type
    It was set to ignore while the Eagle-converted footprints carried none.
    The board passes it (DRC 0); on a copy, AVRISP marked smd reports it.
    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
2026-11-13 Production: make_production.sh and okapi_pos.py, the fabrication files from the KiCad board
    kicad-cli writes the Gerbers (copper, paste, silkscreen, mask, outline),
    the drill files (plated and non-plated) and the grouped BoM, after a DRC
    that must report no errors. okapi_pos.py writes the placement as Eagle's
    2024 export did: every part with an SMD pad, at the center of its SMD pad
    centers. kicad-cli's own export leaves out J9, J10, U3 and USB2 (SMD
    parts with plated holes) and puts SD1 8 mm from its pads (its origin).
    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
2026-11-13 Production: Okapi v0.7 fabrication files and BoM, 2026-11-13
    Okapi_0v7_2026-11-13.zip holds the Gerbers, the drill files and the
    placement; Okapi_BoM_0v7_2026-11-13.csv the parts, 107 lines, 248 parts.
    Checked against the 2024-11-02 fab (Hardware/Okapi_2024-11-02/CAMOutputs):
    placement 235 of 235 parts within 0.011 mm (Eagle's two decimals) and
    the same rotation, the bare jumpers JP6 and JP7 aside (180 degrees, no
    part); JP8 and R62 gone. Drill hits 443 against 446, the same sizes:
    USB2's six 0.5 mm holes are its three slots (bd565bd). Copper and
    silkscreen were compared on the board itself (KICAD-TODO, 2026-11-13).
    Claude-Session: ht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
2026-11-13 README: the KiCad board matches the 2024 files except where a recorded change differs, listed
    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
2026-11-13 README: the USB-C shell's slots and ground link in the list of recorded changes
    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
2026-11-13 README: JP8 and R62 are in the 2024 Eagle files, which were never built (DECISIONS A1); the 25 boards are 2020's v0.4
    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
2026-11-13 README: v0.7.0 is not to be built, since the 2024 charger has no current-sense resistor (#32)
    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
2026-11-13 docs: v0.7 pre-build checks say v0.7.0 is not to be built; the charger sense resistor row goes to v0.8.0 (#32)
    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
2026-11-13 README: the charger starts at 7.2 V as built (R71/R70), where two lines said 4.95 V
    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
2026-11-13 README: the I2C table lists the eleven on-board chips at their v0.7.0 addresses (was the 2020 board's six)
    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
2026-11-13 README: three broken links (bootloader, field operator's guide, Mounting_Plate)
    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
2026-11-13 README: the board's LEDs, D4 and D5 for the logger, D7 for the B-SoM, and D10-D18 on the PCA9634
    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
2026-11-13 README: on v0.7.0 the PAC1934's SLOW pin is high only through the expander's internal pull-up (#37 in v0.8.0)
    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
2026-11-13 docs: pre-build checks aim at the first v0.8.0 boards, name R88 there, and use the net name PARTICLE_EN
    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
2026-11-13 Okapi_2024-11-02: the 2024 fab's drill file, which *.xln in .gitignore had kept out of the CAM set
    The README compares the KiCad drills with it; without it the 2024
    CAMOutputs had Gerbers and placement but no holes.
    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
2026-11-13 README: the KiCad project's library, nw-cold-silicon, and that the design opens without it
    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
2026-11-13 KiCad: the library folder is NW-Cold-Silicon, the repository's new name (footprint and symbol tables, drawing sheet)
    The library nickname stays nw-cold-silicon, so no symbol or footprint
    reference changes. Checks unchanged; the drawing sheet prints.
    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
2026-11-13 README: link the KiCad library, NW-Cold-Silicon, now public
    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
2026-11-13 Remove KiCad-v7import/, the June 2026 KiCad 7 import that Hardware/KiCAD-10import superseded
    Nothing in the repository refers to it; it stays in history at 6b6530f.
    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
2026-11-13 Remove Hardware/Okapi_BoM.csv, the 2021 parts list; Production/ holds the current one
    Last changed 2021-07-05 (bb041bd), before the 2024 redesign. Nothing
    refers to it; it stays in history.
    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
2026-11-13 XTAL1: value 8 MHz, shown under the crystal (was the Eagle device name CRYSTAL8MHZ5X3.2, hidden)
    The long name printed down through the crystal, C42 and RST; 8 MHz sits
    below the crystal's lower lead, clear of C41's value. Board footprint
    value follows. Checks: Eagle nets 204 of 209, ERC 5, DRC 0 / 0 / 0.
    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
2026-11-13 Board: the bottom's three multi-line texts split into one text per line, at Eagle's 1.5x line pitch
    KiCad 10.0.8 ignores line_spacing on board text and set the lines about
    8 % closer than the 2024 fab printed them. Each line is its own text now,
    at a pitch of 1.5 times Eagle's size (1.905 mm for the credit block,
    1.219 mm for the two port-limit notes), centered on the old anchor.
    Check against the fabricated bottom silkscreen: Eagle-only ink 8.09 to
    3.72 mm2, KiCad-only 8.75 to 3.92. DRC 0 / 0 / 0.
    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
2026-11-13 Production: v0.7 files rebuilt, XTAL1's value now 8 MHz and the split silkscreen texts
    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
2026-11-13 Board plot: silkscreen clipped at the solder mask (subtractmaskfromsilk yes)
    A fab does not print silkscreen on exposed copper; Eagle's documentation
    marks (now on the silkscreen) cross many pads, and about 40 % of the
    2023 Margay top silkscreen ink sat inside mask openings. With this the
    Gerbers carry what prints. Andy, 2026-11-13: clean-ups of the Eagle
    versions are welcome. Board re-saves identically.
    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
2026-11-13 make_production.sh: silkscreen Gerbers clipped at the solder mask
    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
2026-11-13 Board: the three bottom range labels print one tilde (4.95~32v), as the 2024 fab did
    The importer wrote Eagle's '~' as '~~', which KiCad prints doubled. Found
    by the silkscreen review; rendered and read.
    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
2026-11-13 Board: three stale board texts out, J8 and J9 by the Feather headers and J6 by D7
    J8 and J9 named the Feather socket's two female headers in the 2021 parts
    list (16 and 12 pins); today J8 is the LiPo connector and J9 the M.2
    socket, so the labels pointed at the wrong parts. J6 sat beside D7 and
    R81 with no J6 near (J6 is a screw terminal at the bottom edge). Found by
    the silkscreen review; the 2024 fab printed them too.
    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
2026-11-13 Board: a + on the top silkscreen at J8's LI+ pad, where the LiPo plugs in
    J8's polarity was marked only on the bottom, 5 mm from its pads, and LiPo
    plug polarity varies by vendor. The + sits between pad 2 (LI+) and the
    connector outline, 1.08 mm as the bottom marks, clear of copper (render
    viewed). Suggested by the silkscreen review; Andy, 2026-11-13: useful
    minor silk changes are fine in the base conversion.
    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
2026-11-13 Board: IC1 re-bodied from NW-Cold-Silicon ffaa124, its pin-1 dot outside the package where the fab prints it
    Eagle's dot sat on the exposed pad and was clipped away, leaving the
    ATmega with no orientation mark. Checked against the board before: every
    placement, pad, track, via and zone identical (pcb_same.py); DRC
    unchanged; rendered and viewed.
    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
2026-11-13 Production: v0.7 files rebuilt, silkscreen clipped at the mask, with today's silk fixes (tilde, stale labels, J8 +, IC1 pin-1 dot)
    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
2026-11-13 Board: R14, R12 and C12 references moved right of their column, off their own pads
    Each reference's last digit sat on its part's pad, so a fab that clips silk
    at the mask printed "R1", "R1" and "C1". They now sit 3.175 mm right of
    the parts, in one column, clear of the BMS_CTR via and over tented copper
    only. DRC 0/0/0, parity 0; round trip identical.
    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
2026-11-13 Board: reference designators hidden, as on Margay
    Margay's board prints no reference designators (all 84 hidden, as its
    2023 boards); Okapi printed 242, 44 of them half or more on pads. All 242
    are now hidden. Function labels, pin names, docu outlines and pin-1 marks
    still print, as on Margay; values were already on the Fab layers.
    Diff: 242 "(hide yes)" lines and nothing else. DRC 0/0/0, parity 0;
    round trip identical.
    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
2026-11-13 Production: v0.7 files rebuilt with the reference designators hidden
    Only the two silkscreen Gerbers differ from 083c068 (front 584,386 to
    194,491 bytes, back 251,349 to 242,277); copper, mask, paste, edge,
    drill, placement and BoM are unchanged apart from timestamps.
    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
